m-soori/hi3535_nvr/1. Schematic/BOM.txt

1	1	BT1	BAT_3V	BAT_CR1220					
2	4	C1	20PF	SC0603					
		C2	20PF	SC0603					
		C23	20PF	SC0603					
		C24	20PF	SC0603					
3	2	C3	10nF	C0402					
		C25	10nF	C0402					
4	2	C4	NC/10nF	C0402					
		C26	NC/10nF	C0402					
5	7	C5	4.7UF	SC0603					
		C10	4.7UF	SC0603					
		C12	4.7UF	SC0603					
		C27	4.7UF	SC0603					
		C32	4.7UF	SC0603					
		C34	4.7UF	SC0603					
		C329	4.7uF	SC0603					
6	124	C6	100NF	SC0402					
		C8	100NF	SC0402					
		C9	100NF	SC0402					
		C11	100NF	SC0402					
		C13	100NF	SC0402					
		C14	100NF	SC0402					
		C28	100NF	SC0402					
		C30	100NF	SC0402					
		C31	100NF	SC0402					
		C33	100NF	SC0402					
		C35	100NF	SC0402					
		C36	100NF	SC0402					
		C45	100NF	SC0402					
		C47	100NF	SC0402					
		C50	100NF	SC0402					
		C51	100NF	SC0402					
		C52	100NF	SC0402					
		C53	100NF	SC0402					
		C54	100NF	SC0402					
		C55	100NF	SC0402					
		C56	100NF	SC0402					
		C57	100NF	SC0402					
		C60	100NF	SC0402					
		C61	100NF	SC0402					
		C62	100NF	SC0402					
		C63	100NF	SC0402					
		C64	100NF	SC0402					
		C65	100NF	SC0402					
		C66	100NF	SC0402					
		C88	100NF	SC0402					
		C89	100NF	SC0402					
		C90	100NF	SC0402					
		C91	100NF	SC0402					
		C92	100NF	SC0402					
		C93	100NF	SC0402					
		C97	100NF	SC0402					
		C98	100NF	SC0402					
		C99	100NF	SC0402					
		C100	100NF	SC0402					
		C101	100NF	SC0402					
		C102	100NF	SC0402					
		C103	100NF	SC0402					
		C104	100NF	SC0402					
		C105	100NF	SC0402					
		C106	100NF	SC0402					
		C107	100NF	SC0402					
		C108	100NF	SC0402					
		C109	100NF	SC0402					
		C110	100NF	SC0402					
		C111	100NF	SC0402					
		C112	100NF	SC0402					
		C113	100NF	SC0402					
		C123	100NF	SC0402					
		C124	100NF	SC0402					
		C125	100NF	SC0402					
		C126	100NF	SC0402					
		C127	100NF	SC0402					
		C128	100NF	SC0402					
		C130	100NF	SC0402					
		C131	100NF	SC0402					
		C132	100NF	SC0402					
		C133	100NF	SC0402					
		C134	100NF	SC0402					
		C135	100NF	SC0402					
		C136	100NF	SC0402					
		C137	100NF	SC0402					
		C138	100NF	SC0402					
		C141	100NF	SC0402					
		C142	100NF	SC0402					
		C143	100NF	SC0402					
		C144	100NF	SC0402					
		C145	100NF	SC0402					
		C146	100NF	SC0402					
		C147	100NF	SC0402					
		C148	100NF	SC0402					
		C149	100NF	SC0402					
		C151	100NF	SC0402					
		C152	100NF	SC0402					
		C153	100NF	SC0402					
		C154	100NF	SC0402					
		C156	100NF	SC0402					
		C157	100NF	SC0402					
		C158	100NF	SC0402					
		C159	100NF	SC0402					
		C160	100NF	SC0402					
		C161	100NF	SC0402					
		C162	100NF	SC0402					
		C163	100NF	SC0402					
		C164	100NF	SC0402					
		C167	100NF	SC0402					
		C168	100NF	SC0402					
		C169	100NF	SC0402					
		C170	100NF	SC0402					
		C171	100NF	SC0402					
		C172	100NF	SC0402					
		C173	100NF	SC0402					
		C174	100NF	SC0402					
		C175	100NF	SC0402					
		C186	100NF	SC0402					
		C187	100NF	SC0402					
		C199	100NF	SC0402					
		C200	100NF	SC0402					
		C202	100NF	SC0402					
		C203	100NF	SC0402					
		C204	100NF	SC0402					
		C206	100NF	SC0402					
		C207	100NF	SC0402					
		C210	100NF	SC0402					
		C211	100NF	SC0402					
		C213	100NF	SC0402					
		C214	100NF	SC0402					
		C216	100NF	SC0402					
		C217	100NF	SC0402					
		C219	100NF	SC0402					
		C220	100NF	SC0402					
		C231	100NF	SC0402					
		C241	100NF	SC0402					
		C245	100NF	SC0402					
		C246	100NF	SC0402					
		C249	100NF	SC0402					
		C250	100NF	SC0402					
		C252	100NF	SC0402					
		C323	100NF	SC0402					
		C325	100NF	SC0402					
7	10	C7	1NF	SC0402					
		C29	1NF	SC0402					
		C140	1NF	SC0402					
		C166	1NF	SC0402					
		C264	1NF	SC0402					
		C281	1NF	SC0402					
		C288	1NF	SC0402					
		C302	1NF	SC0402					
		C319	1NF	SC0402					
		C326	1NF	SC0402					
8	41	C15	100NF	SC0603					
		C16	100NF	SC0603					
		C17	100NF	SC0603					
		C18	100NF	SC0603					
		C20	100NF	SC0603					
		C21	100NF	SC0603					
		C37	100NF	SC0603					
		C38	100NF	SC0603					
		C39	100NF	SC0603					
		C40	100NF	SC0603					
		C42	100NF	SC0603					
		C43	100NF	SC0603					
		C183	100NF	SC0603					
		C189	100NF	SC0603					
		C190	100NF	SC0603					
		C191	100NF	SC0603					
		C192	100NF	SC0603					
		C225	100NF	SC0603					
		C227	100NF	SC0603					
		C229	100NF	SC0603					
		C242	100NF	SC0603					
		C254	100NF	SC0603					
		C257	100NF	SC0603					
		C260	100NF	SC0603					
		C263	100NF	SC0603					
		C266	100NF	SC0603					
		C267	100NF	SC0603					
		C271	100NF	SC0603					
		C274	100NF	SC0603					
		C277	100NF	SC0603					
		C280	100NF	SC0603					
		C284	100NF	SC0603					
		C289	100NF	SC0603					
		C292	100NF	SC0603					
		C295	100NF	SC0603					
		C298	100NF	SC0603					
		C301	100NF	SC0603					
		C305	100NF	SC0603					
		C309	100NF	SC0603					
		C315	100NF	SC0603					
		C318	100NF	SC0603					
9	14	C19	10UF	SC0805					
		C22	10UF	SC0805					
		C41	10UF	SC0805					
		C44	10UF	SC0805					
		C139	10UF	SC0805					
		C150	10UF	SC0805					
		C165	10UF	SC0805					
		C176	10UF	SC0805					
		C188	10UF	SC0805					
		C256	10UF	SC0805					
		C273	10UF	SC0805					
		C290	10UF	SC0805					
		C294	10UF	SC0805					
		C310	10UF	SC0805					
10	24	C46	1UF	SC0402					
		C48	1UF	SC0402					
		C67	1UF	SC0402					
		C68	1UF	SC0402					
		C69	1UF	SC0402					
		C80	1UF	SC0402					
		C81	1UF	SC0402					
		C82	1UF	SC0402					
		C86	1UF	SC0402					
		C87	1UF	SC0402					
		C117	1UF	SC0402					
		C118	1UF	SC0402					
		C122	1UF	SC0402					
		C129	1UF	SC0402					
		C155	1UF	SC0402					
		C198	1UF	SC0402					
		C205	1UF	SC0402					
		C208	1UF	SC0402					
		C209	1UF	SC0402					
		C212	1UF	SC0402					
		C215	1UF	SC0402					
		C268	1UF	SC0402					
		C285	1UF	SC0402					
		C307	1UF	SC0402					
11	9	C49	10UF	SC0603					
		C58	10UF	SC0603					
		C59	10UF	SC0603					
		C119	10UF	SC0603					
		C120	10UF	SC0603					
		C121	10UF	SC0603					
		C201	10UF	SC0603					
		C248	10UF	SC0603					
		C251	10UF	SC0603					
12	2	C70	22UF	SC1206					
		C78	22UF	SC1206					
13	5	C71	2.2UF	HSC0402					
		C72	2.2UF	HSC0402					
		C197	2.2UF	HSC0402					
		C218	2.2UF	HSC0402					
		C247	2.2UF	HSC0402					
14	3	C73	470NF	SC0402					
		C74	470NF	SC0402					
		C283	470nF	SC0402					
15	6	C75	220NF	SC0402					
		C76	220NF	SC0402					
		C77	220NF	SC0402					
		C83	220NF	SC0402					
		C84	220NF	SC0402					
		C85	220NF	SC0402					
16	6	C79	2.2UF	SC0603					
		C114	2.2UF	SC0603					
		C115	2.2UF	SC0603					
		C116	2.2UF	SC0603					
		C270	2.2UF	SC0603					
		C287	2.2UF	SC0603					
17	1	C94	4.7UF	SC1206					
18	6	C95	220UF	STC3528					
		C96	220UF	STC3528					
		C261	220UF	STC3528					
		C265	220UF	STC3528					
		C278	220UF	STC3528					
		C282	220UF	STC3528					
19	1	C177	1NF	SC0603					
20	2	C178	27PF	SC0603					
		C179	27PF	SC0603					
21	2	C180	22PF	SC0402					
		C181	22PF	SC0402					
22	4	C182	8pF	C0402					
		C185	8pF	C0402					
		C232	8pF	C0402					
		C233	8pF	C0402					
23	4	C184	1uF	C0402					
		C239	1uF	C0402					
		C244	1uF	C0402					
		C347	1uF	C0402					
24	4	C221	10NF	SC0402					
		C222	10NF	SC0402					
		C223	10NF	SC0402					
		C224	10NF	SC0402					
25	4	C226	100UF	STC7343					
		C230	100UF	STC7343					
		C321	100UF	STC7343					
		C322	100UF	STC7343					
26	2	C228	10NF	SC0603					
		C243	10NF	SC0603					
27	3	C234	4.7uF	C0603					
		C240	4.7uF	C0603					
		C355	4.7uF	C0603					
28	11	C235	0.1uF	C0402					
		C236	0.1uF	C0402					
		C237	0.1uF	C0402					
		C238	0.1uF	C0402					
		C253	0.1uF	C0402					
		C339	0.1uF	c0402					
		C340	0.1uF	c0402					
		C342	0.1uF	C0402					
		C345	0.1uF	c0402					
		C346	0.1uF	C0402					
		C354	0.1uF	C0402					
29	4	C255	47UF	STC7343					
		C272	47UF	STC7343					
		C293	47UF	STC7343					
		C308	47UF	STC7343					
30	15	C258	22UF	SC0805					
		C259	22UF	SC0805					
		C262	22UF	SC0805					
		C275	22UF	SC0805					
		C276	22UF	SC0805					
		C279	22UF	SC0805					
		C296	22UF	SC0805					
		C297	22UF	SC0805					
		C300	22UF	SC0805					
		C313	22UF	SC0805					
		C314	22UF	SC0805					
		C317	22UF	SC0805					
		C324	22UF	SC0805					
		C327	22UF	SC0805					
		C328	22UF	SC0805					
31	3	C269	NC	SC0402					
		C286	NC	SC0402					
		C306	NC	SC0402					
32	1	C291	220UF	CAPC2-138-335					
33	4	C299	100UF	STC3528					
		C303	100UF	STC3528					
		C316	100UF	STC3528					
		C320	100UF	STC3528					
34	1	C304	1UF/NC	SC0603					
35	1	C311	0.033UF	C0603					
36	1	C312	0.033UF	SC0603					
37	2	C330	220PF	SC0603					
		C331	220PF	SC0603					
38	2	C332	0.1UF	SC0603					
		C333	0.1UF	SC0603					
39	5	C334	1U	C0402					
		C335	1U	C0402					
		C336	1U	C0402					
		C337	1U	C0402					
		C338	1U	C0402					
40	1	C341	22uF	c0805					
41	2	C343	"matching circuit, will be determined"	C0402					
		C344	"matching circuit, will be determined"	C0402					
42	2	C348	10uF/6.3V	SMC0603					
		C349	10uF/6.3V	SMC0603					
43	5	C350	0.1uF	SMC0402					
		C351	0.1uF	SMC0402					
		C352	0.1uF	SMC0402					
		C353	0.1uF	SMC0402					
		C356	0.1uF	SMC0402					
44	3	C357	33pF	SMC0402					
		C358	33pF	SMC0402					
		C359	33pF	SMC0402					
45	4	D1	LED	SD0805-LED					
		D2	LED	SD0805-LED					
		D4	LED	SD0805-LED					
		D8	LED	SD0805-LED					
46	1	D3	1N4148	SOD523					
47	1	D5	1N5819	SOD123					
48	1	D6	NC/1N5819	SOD123					
49	1	D7	DZ	SD2723					
50	2	D9	MBRS330T3	SMC-2L					
		D10	MBRS330T3	SMC-2L					
51	8	ED1	NC/ESDA6V8UL/AZC199-02S	SOT23					
		ED2	NC/ESDA6V8UL/AZC199-02S	SOT23					
		ED3	NC/ESDA6V8UL/AZC199-02S	SOT23					
		ED4	NC/ESDA6V8UL/AZC199-02S	SOT23					
		ED5	NC/ESDA6V8UL/AZC199-02S	SOT23					
		ED6	NC/ESDA6V8UL/AZC199-02S	SOT23					
		ED7	NC/ESDA6V8UL/AZC199-02S	SOT23					
		ED8	NC/ESDA6V8UL/AZC199-02S	SOT23					
52	4	ED9	NC/ESD9B5VL	E0402N					
		ED10	NC/ESD9B5VL	E0402N					
		ED11	NC/ESD9B5VL	E0402N					
		ED12	NC/ESD9B5VL	E0402N					
53	2	ESD1	ES0402V014BT	ESD0402					
		ESD2	ES0402V014BT	ESD0402					
54	2	FB1	BLM18PG181SN1	L0603					
		FB2	BLM18PG181SN1	L0603					
55	3	FB3	31/3A-L3	SMR0603					
		FB4	31/3A-L3	SMR0603					
		FB5	31/3A-L3	SMR0603					
56	1	F1	FUSE2	SF6127					
57	6	ID1	ID-BOARD	ID-BOARD					
		ID2	ID-BOARD	ID-BOARD					
		ID3	ID-BOARD	ID-BOARD					
		ID4	ID-BOARD	ID-BOARD					
		ID5	ID-BOARD	ID-BOARD					
		ID6	ID-BOARD	ID-BOARD					
58	2	J1	LPJG4813HENL	SI-51009-F					
		J2	LPJG4813HENL	SI-51009-F					
59	1	J3	SIP3	SIP-3P					
60	1	J4	SIP7M2	SATA7-M					
61	1	J5	USB-4M2	USB4-1507					
62	1	J6	USB-9S4	RUSB9-180-0726A					
63	1	J7	10029449-111RLF	HDMI_A					
64	4	J8	SIP1	SIP-1P					
		J9	SIP1	SIP-1P					
		J10	SIP1	SIP-1P					
		J11	SIP1	SIP-1P					
65	1	J12	PWC3_A	PWC0103-M-C					
66	1	J13	DEBUG	conn3_box					
67	1	J14	6.91322E+11	PHEONIX_CONN_3					
68	1	J15	HEADER 4 2.54mm /NC	header-4					
69	1	J16	CON3	antenna_wifi					
70	8	LB1	LB	SL0805					
		LB2	LB	SL0805					
		LB3	LB	SL0805					
		LB4	LB	SL0805					
		LB19	LB	SL0805					
		LB21	LB	SL0805					
		LB23	LB	SL0805					
		LB25	LB	SL0805					
71	13	LB5	LB	SL0402					
		LB6	LB	SL0402					
		LB7	LB	SL0402					
		LB8	LB	SL0402					
		LB9	LB	SL0402					
		LB10	LB	SL0402					
		LB11	LB	SL0402					
		LB12	LB	SL0402					
		LB13	LB	SL0402					
		LB14	LB	SL0402					
		LB15	LB	SL0402					
		LB17	LB	SL0402					
		LB18	LB	SL0402					
72	1	LB16	LB	SL0603					
73	4	LB20	LB	SL1206					
		LB22	LB	SL1206					
		LB24	LB	SL1206					
		LB27	LB	SL1206					
74	1	LB26	LB	SL1806					
75	1	LED1	LED0603-G	SM0603LED_AC					
76	2	L1	2.2UH	HSL1008					
		L2	2.2UH	HSL1008					
77	3	L3	12UH	SPL1212C					
		L4	12UH	SPL1212C					
		L5	12UH	SPL1212C					
78	2	L6	15UH	L_					
		L7	15UH	L_					
79	1	L8	"matching circuit,will be determined"	R0402					
80	1	MPCIE_A_1	MINI PCIE-52-H6.7	pciexp_mini52pn_half					
81	1	Q1	DS1820	TO-TR					
82	2	Q2	WNM2021/2SK3018	SOT23					
		Q3	WNM2021/2SK3018	SOT23					
83	1	Q4	NC/WNM2021/2SK3018	SOT23					
84	10	RN1	33	SRN8-0804					
		RN2	33	SRN8-0804					
		RN3	33	SRN8-0804					
		RN4	33	SRN8-0804					
		RN5	33	SRN8-0804					
		RN6	33	SRN8-0804					
		RN7	33	SRN8-0804				R271	C360
		RN8	33	SRN8-0804				R272	C361
		RN9	33	SRN8-0804				R273	C362
		RN10	33	SRN8-0804				R274	C363
85	2	R1	1MEG	SR0603				R275	C364
		R51	1MEG	SR0603				R276	C365
86	24	R2	0	SR0402				R277	C366
		R3	0	SR0402				R278	C367
		R4	0	SR0402				R279	
		R26	0	SR0402				R280	
		R28	0	SR0402					
		R30	0	SR0402					
		R32	0	SR0402					
		R33	0	SR0402					
		R38	0	SR0402					
		R53	0	SR0402					
		R54	0	SR0402					
		R55	0	SR0402					
		R77	0	SR0402					
		R79	0	SR0402					
		R80	0	SR0402					
		R83	0	SR0402					
		R84	0	SR0402					
		R85	0	SR0402					
		R186	0	SR0402					
		R223	0	SR0402					
		R226	0	SR0402					
		R231	0	SR0402					
		R234	0	SR0402					
		R241	0	SR0402					
87	6	R5	0/NC	SR0402					
		R15	0/NC	SR0402					
		R31	0/NC	SR0402					
		R56	0/NC	SR0402					
		R66	0/NC	SR0402					
		R82	0/NC	SR0402					
88	4	R6	510R	R0402					
		R29	510R	R0402					
		R57	510R	R0402					
		R81	510R	R0402					
89	19	R7	0R	R0402					
		R8	0R	R0402					
		R9	0R	R0402					
		R10	0R	R0402					
		R11	0R	R0402					
		R12	0R	R0402					
		R13	0R	R0402					
		R14	0R	R0402					
		R58	0R	R0402					
		R59	0R	R0402					
		R60	0R	R0402					
		R61	0R	R0402					
		R62	0R	R0402					
		R63	0R	R0402					
		R64	0R	R0402					
		R65	0R	R0402					
		R262	0R	R0402					
		R263	0R	R0402					
		R265	0R	r0402					
90	18	R16	1K	SR0402					
		R67	1K	SR0402					
		R103	1K	SR0402					
		R104	1K	SR0402					
		R105	1K	SR0402					
		R106	1K	SR0402					
		R117	1K	SR0402					
		R118	1K	SR0402					
		R119	1K	SR0402					
		R120	1K	SR0402					
		R154	1K	SR0402					
		R155	1K	SR0402					
		R161	1K	SR0402					
		R162	1K	SR0402					
		R163	1K	SR0402					
		R164	1K	SR0402					
		R166	1K	SR0402					
		R196	1K	SR0402					
91	2	R17	2.49K	SR0603					
		R68	2.49K	SR0603					
92	2	R18	NC/10	R0402					
		R69	NC/10	R0402					
93	24	R19	33	SR0402					
		R20	33	SR0402					
		R22	33	SR0402					
		R24	33	SR0402					
		R25	33	SR0402					
		R27	33	SR0402					
		R70	33	SR0402					
		R71	33	SR0402					
		R73	33	SR0402					
		R75	33	SR0402					
		R76	33	SR0402					
		R78	33	SR0402					
		R111	33	SR0402					
		R112	33	SR0402					
		R113	33	SR0402					
		R114	33	SR0402					
		R115	33	SR0402					
		R116	33	SR0402					
		R125	33	SR0402					
		R126	33	SR0402					
		R127	33	SR0402					
		R128	33	SR0402					
		R129	33	SR0402					
		R130	33	SR0402					
94	34	R21	4.7K	SR0603					
		R23	4.7K	SR0603					
		R34	4.7K	SR0603					
		R35	4.7K	SR0603					
		R36	4.7K	SR0603					
		R37	4.7K	SR0603					
		R40	4.7K	SR0603					
		R42	4.7K	SR0603					
		R43	4.7K	SR0603					
		R45	4.7K	SR0603					
		R46	4.7K	SR0603					
		R48	4.7K	SR0603					
		R49	4.7K	SR0603					
		R72	4.7K	SR0603					
		R74	4.7K	SR0603					
		R87	4.7K	SR0603					
		R88	4.7K	SR0603					
		R89	4.7K	SR0603					
		R90	4.7K	SR0603					
		R91	4.7K	SR0603					
		R92	4.7K	SR0603					
		R94	4.7K	SR0603					
		R96	4.7K	SR0603					
		R98	4.7K	SR0603					
		R100	4.7K	SR0603					
		R137	4.7K	SR0603					
		R138	4.7K	SR0603					
		R139	4.7K	SR0603					
		R140	4.7K	SR0603					
		R141	4.7K	SR0603					
		R145	4.7K	SR0603					
		R146	4.7K	SR0603					
		R150	4.7K	SR0603					
		R153	4.7K	SR0603					
95	3	R39	470	SR0603					
		R86	470	SR0603					
		R249	470	SR0603					
96	10	R41	4.7K/NC	SR0603					
		R44	4.7K/NC	SR0603					
		R47	4.7K/NC	SR0603					
		R93	4.7K/NC	SR0603					
		R95	4.7K/NC	SR0603					
		R97	4.7K/NC	SR0603					
		R147	4.7K/NC	SR0603					
		R148	4.7K/NC	SR0603					
		R149	4.7K/NC	SR0603					
		R156	4.7K/NC	SR0603					
97	2	R50	4.7K/CN	SR0603					
		R99	4.7K/CN	SR0603					
98	2	R52	4.7K	SR0402					
		R142	4.7K	SR0402					
99	6	R101	10K	SR0402					
		R109	10K	SR0402					
		R123	10K	SR0402					
		R133	10K	SR0402					
		R136	10K	SR0402					
		R213	10K	SR0402					
100	3	R102	240	SR0402					
		R110	240	SR0402					
		R124	240	SR0402					
101	4	R107	120	SR0402					
		R108	120	SR0402					
		R121	120	SR0402					
		R122	120	SR0402					
102	1	R131	1MEG	SR0402					
103	1	R132	10	SR0402					
104	5	R135	10K	R0402					
		R202	10K	R0402					
		R204	10K	R0402					
		R205	10K	R0402					
		R264	10K	r0402					
105	3	R143	0/NC	SR0603					
		R144	0/NC	SR0603					
		R216	0/NC	SR0603					
106	11	R151	10K	SR0603					
		R152	10K	SR0603					
		R157	10K	SR0603					
		R158	10K	SR0603					
		R159	10K	SR0603					
		R160	10K	SR0603					
		R165	10K	SR0603					
		R193	10K	SR0603					
		R195	10K	SR0603					
		R198	10K	SR0603					
		R200	10K	SR0603					
107	1	R169	470K	SR0402					
108	15	R170	22	SR0402					
		R172	22	SR0402					
		R174	22	SR0402					
		R176	22	SR0402					
		R177	22	SR0402					
		R178	22	SR0402					
		R180	22	SR0402					
		R181	22	SR0402					
		R182	22	SR0402					
		R183	22	SR0402					
		R184	22	SR0402					
		R185	22	SR0402					
		R187	22	SR0402					
		R188	22	SR0402					
		R190	22	SR0402					
109	2	R171	270	SR0603					
		R173	270	SR0603					
110	2	R175	200	SR0603					
		R179	200	SR0603					
111	6	R189	1K	SR0603					
		R191	1K	SR0603					
		R229	1K	SR0603					
		R237	1K	SR0603					
		R245	1K	SR0603					
		R251	1K	SR0603					
112	4	R192	100K	SR0603					
		R194	100K	SR0603					
		R197	100K	SR0603					
		R199	100K	SR0603					
113	1	R201	680R	R0402					
114	1	R203	100K	R0402					
115	1	R212	1.13K	SR0603					
116	1	R214	20K	SR0402					
117	1	R215	47K	SR0402					
118	4	R217	1.62K%1	R0402					
		R218	1.62K%1	R0402					
		R219	1.62K%1	R0402					
		R220	1.62K%1	R0402					
119	2	R221	NC/10K	R0402					
		R222	NC/10K	R0402					
120	3	R224	100K	SR0402					
		R232	100K	SR0402					
		R242	100K	SR0402					
121	1	R225	12.1K	SR0402					
122	1	R227	1.5K	SR0402					
123	1	R228	127K	SR0402					
124	2	R230	24.9K	SR0402					
		R244	24.9K	SR0402					
125	1	R233	27K	SR0402					
126	1	R235	12K	SR0402					
127	1	R236	200K	SR0402					
128	1	R238	45.3K	SR0402					
129	1	R239	1K	SR1206					
130	2	R240	10K/NC	SR0603					
		R253	10K/NC	SR0603					
131	1	R243	24K	SR0402					
132	2	R246	100	SR0603					
		R252	100	SR0603					
133	3	R247	51	SR0603					
		R248	51	SR0603					
		R250	51	SR0603					
134	1	R254	49.9	SC0603					
135	2	R255	10k	SC0603					
		R256	10k	SC0603					
136	1	R257	49	SC0603					
137	1	R258	1.91k	SC0603					
138	1	R259	3.16k	SC0603					
139	2	R260	499	SC0603					
		R261	499	SC0603					
140	1	R266	0R/NC	R0402					
141	2	R267	0R/NM	SMR0402					
		R269	0R/NM	SMR0402					
142	1	R268	0R	SMR0402					
143	1	R270	240R	SMR0402					
144	1	SIM1	CR-201-6P	micro_sim					
145	2	SW1	DSW4	SDSW8-L					
		SW2	DSW4	SDSW8-L					
146	1	S1	PSW3_B	PSW3-RA					
147	2	TS1	TEST	GND12					
		TS2	TEST	GND12					
148	1	T1	DLW21SN900SQ2L	choke_coil					
149	2	U1	RTL8211EG_1	QFN64-050-0909LH					
		U2	RTL8211EG_1	QFN64-050-0909LH					
150	1	U4	HI3535	PBGA563-32-2828					
151	2	U5	DDR3 DRAM-4GBIT-800MHZ-16BIT	BGA96-32-1609G					
		U6	DDR3 DRAM-4GBIT-800MHZ-16BIT	BGA96-32-1609G					
152	1	U7	MCP7940M-I/SN	soic-8					
153	1	U8	H27U2G8F2CTR_BC	SOP48-20-720A					
154	2	U9	MIC2505	SOP8-50-150					
		U10	MIC2505	SOP8-50-150					
155	1	U11	GL850G	SSOP28					
156	2	U12	NC/RClamp0524PA/ESD5304/TPD4E02B04DQAR	SLP2510P8					
		U13	NC/RClamp0524PA/ESD5304/TPD4E02B04DQAR	SLP2510P8					
157	3	U14	TSP54328EDDA	HSOP8					
		U15	TSP54328EDDA	HSOP8					
		U16	TSP54328EDDA	HSOP8					
158	2	U17	FMB3904 dual NPN	SSOT-6L					
		U18	FMB3904 dual NPN	SSOT-6L					
159	1	U19	TPS54383PWP	HTSSOP14					
160	1	U20	MAX3232	soic16					
161	1	U21	ZM5304	ZM5304					
162	1	U22	RL-UM12BS-8188EUS	WIFI_BT_R					
163	1	U23	PT5108E23E-33/RT9013-33B	SOT23-5					
164	2	X1	25MHZ	SX2-1205					
		X2	25MHZ	SX2-1205					
165	1	X3	24MHZ	SX2-1205					
166	1	X4	0.032768MHZ	XTAL2-100					
167	1	X5	12M/20pF	5032-12m					
168	1	Y1	32.768K	cm315d
