m-soori/hi3535_nvr/6. Doc/PadDesign.txt

Begin layer = End layer = internal layer + 10
Thermal reliefs = Antipads = Regular pads + 10
Soldermask Top = Regular Pad Top + 10
