m-soori/hi3535_nvr/2. Layout/Design Recommendations.xlsx

Sheet: Board
2. PCB Design Recommendation
2.1. Fanout Design Recommendations
* Pay attention to the fanout mode of the pins in the five outmost circles and via positions, ensuring the maximum current capacity of the power layer, smooth reflow paths of the GND layer, and the integrity of the GND layer and power layer
* It is recommended that power be supplied to the 3.3 V, 1.5 V, and DVDD_CORE power pins by using complete power planes and the power be supplied to the DVDD_CPU pin over a copper plane. In addition, ensure that the copper planes for the DVDD_CORE and DVDD_CPU pins are wide to support the maximum current capacities of 3 A and 2 A respectively.
2.2. Design Recommendations for Power Supplies and Filtering Capacitors
2.2.1. Core Power Supply
* Same as demo board. The recommended material for the filtering capacitors is X7R.
* Routing mode and filtering capacitor layout for core power supply must be same as demo board
2.2.2. CPU Power Supply Design
2.3. Design Requirements on DDR2 or DDR3 SDRAM Interface Routing
The design of the DDR SDRAM interface on the Hi3535 must be the same as that on the Hi3535 demo board. The items to be designed include the trace width, trace spacing, the spacing between a trace and GND, trace length, surrounding with GND traces, filtering capacitor position, and matching mode.
2.4. GMAC Routing Recommendations
Avoid routing signal traces across power plane splits to retain complete reference planes for signal traces.
Determine the signal trace length based on the clock trace length, and ensure that the length deviation is ±200 mils.
Ensure that the GND under the transformer is void.
Each pair of differential traces (MDI+_0, MDI−_0, MDI+_1, MDI−_1, MDI+_2, MDI−_2, MDI+_3, and MDI−_3) has the same length. The length deviation is ±5 mils, and the impedance of each differential trace is 100 Ω±10%.
2.5 USB 2.0 Circuit Design Recommendations
The differential data traces must be short and straight, and the internal differential traces must have the same length. t is recommended that the trace deviation be ±5 mils.
The differential impedance of the differential data trace must be 90 Ω±10%.
Route differential data traces on the plane that is close to the GND plane and never change the routing plane.
Route differential data traces by referencing a complete GND plane, and do not cross the plane splits.
Minimize the use of vias and corners when routing differential data traces. When corners are required, use arcs or135° turns rather than a 90° turn, reducing signal reflection and impedance variance.
Keep the differential data traces away from other high-speed cyclic signal traces and large current signal traces. The spacing must be greater than 50 mils. In this way, the crosstalk effect is reduced. Keep the differential data traces at least 20 mils away from low-speed non-cyclic signals.
Place the REXT resistor close to the Hi3535.
2.6 USB 3.0 Circuit Design Recommendations
Place the blocking capacitor close to the connector.
Route traces at the top layer, and punch at most one vias.
Ensure that the length of each differential trace is shorter than 3 inches.
2.7 Design Recommendations on SATA Port Routing
The differential impedance must be 100 Ω±10%.
The 10 nF surface mounting technology (SMT) capacitor connected to the differential signal line in series must be placed close to the SATA connector.
It is recommended that the length deviation for each pair of differential signal traces be ±5 mils.
Route traces at the top layers and never punch vias and change the routing layer.
It is recommended that the signal trace length on the PCB be shorter than 5 inches
2.8 Design Recommendations on HDMI Routing
The differential impedance of the four pairs of HDMI differential signal traces must be 100 Ω±10%.
ESD components must be placed close to the HDMI connector.
It is recommended that the signal trance at the corners be routed as arcs.
The length deviation for each pair of internal differential signal traces must be ±5 mils, and the length deviation for all differential signal traces must be ±50 mils.
The length of each HDMI differential signal trace is shorter than 5 inches.
2.10 PCB Design Recommendations on the PCIe Bus
The differential data traces must be short and straight, and the internal differential traces must have the same length. It is recommended that the trace deviation be ±20 mils.
Ensure that the spacing between adjacent differential data traces is constant. Route traces on the routing planes close to GND, and do not change a routing plane.

Sheet: Allegro
Creating Differential Pairs
* Constraint Manager
_ Electrical -> Net -> Routing -> Differential Pair
 | A list of nets appear, pick a pair of traces, R-click -> Create -> Differential Pair
 | Diff Pair Name
 | The 2 traces will move to the diff pair group
_ Object -> Create -> Differential Pair…
 | Auto Setup…
 | + Filter, - Filter, Prefix
Creating a Cset
* Constraint Manager
_ Spacing
_ Object -> Create -> Spacing C-set: Create new C-Set
_ Net -> Line ->
Setting Impedance
- Cross Section
- Thickness
- Trace width
Tool
Phase tune
Delay tune
Change to another editor
File -> Change editor -> Check High Speed
Total Etch Length
- Optional: we can highlight the rat nets
- Constraint Manger -> Electrical -> Net -> Total Etch Length
 | Pick the traces -> create -> net class
- Route
- Come back with CM -> Analyze -> Analyze Modes…
- Electrical Modes -> Turn on Total etch length
- It will give you the length of the traces
- CM -> Electrical -> Electrical Constraint Set -> Routing -> Total Etch length
- R-click on the table -> Create -> Electrical Cset -> Create a Cset
- Set maximum total etch
- Change the group into Cset group
- Delay tune
Electrical Constraint Set Topologies Allegro PCB High Speed Option

Sheet: TPS
The layout guidelines presented here are illustrated in the PCB layout examples given in Figure 51 and Figure 52.
• The PowerPAD must be connected to a low current (signal) ground plane having a large copper surface areato dissipate heat. Extend the copper surface well beyond the IC package area to maximize thermal transfer of heat away from the IC.
• Connect the GND pin to the PowerPAD through a 10-mil (.010 in, or 0.0254 mm) wide trace.
• Place the ceramic input capacitors close to PVDD1 and PVDD2; connect using short, wide traces.
• Maintain a tight loop of wide traces from SW1 or SW2 through the switch node, inductor, output capacitor and rectifier diode. Avoid using vias in this loop.
• Use a wide ground connection from the input capacitor to the rectifier diode, placed as close to the power path as possible. Placement directly under the diode and the switch node is recommended.
• Locate the bootstrap capacitor close to the BOOT pin to minimize the gate drive loop.
• Locate voltage setting resistors and any feedback components over the ground plane and away from the switch node and the rectifier diode to input capacitor ground connection.
• Locate snubber components (if used) close to the rectifier diode with minimal loop area.
• Locate the BP bypass capacitor very close to the IC; a minimal loop area is recommended.
• Locate the output ceramic capacitor close to the inductor output terminal between the inductor and any electrolytic capacitors, if used.

Sheet: Stackup
 | Layer Stackup | Thickness
 | Silk top | Default
 | Solder top
ART01 |  | 1.8
PREPREG |  | 3.9
GND02 |  | 1.2
CORE |  | xxx
POW03 |  | 1.2
PREPREG |  | 3.9
ART04 |  | 1.8
 | Solder bot | Default
 | Silk bot
Single Impedance | Layer | Trace Width (mil) | Tolerance | Freq (MHz) | Remark
50 ohm | 1, 4 | 6 | 10% | Default
Diff Impedance | Layer | Trace W/S (mil) | Tolerance | Freq (MHz) | Remark
100 ohm | 1, 4 | 5/8 | 10% | Default
90 ohm | 1 | 6.1/7 | 10% | Default
