m-soori/hi3535_nvr/(list of files, cad)

Other CAD files:
Footprint/1825027-5.psm
Footprint/5032-12m.psm
Footprint/abm3-24.psm
Footprint/anten_sma_fe_edge.psm
Footprint/antenna_wifi.psm
Footprint/b3u-1000p.psm
Footprint/bat_cr1220.psm
Footprint/bat_upright.psm
Footprint/bga453-19x19.psm
Footprint/bga624_0p8_21x21.psm
Footprint/bga636_1.psm
Footprint/bga96-32-1609g.psm
Footprint/bitpipe.psm
Footprint/block2.psm
Footprint/button_fsm.psm
Footprint/buzzer_dip2.psm
Footprint/bzv55c.psm
Footprint/c0402.psm
Footprint/c0603.psm
Footprint/c0805.psm
Footprint/cap-2917.psm
Footprint/cap2-300-240.psm
Footprint/cap400.psm
Footprint/cap_1210.psm
Footprint/cap_al_d.psm
Footprint/cap_alu_smd_d.psm
Footprint/cap_thru.psm
Footprint/capc2-138-335.psm
Footprint/capmp3216x166.psm
Footprint/capp_ae_f.psm
Footprint/capp_taj_a.psm
Footprint/capp_taj_c.psm
Footprint/capp_taj_d.psm
Footprint/choke_coil.psm
Footprint/clp-2x15-1_27-l-d.psm
Footprint/cm315d.psm
Footprint/con5_microusb_skt_sm.psm
Footprint/con5smd.psm
Footprint/con_2.psm
Footprint/con_40p_bot.psm
Footprint/con_dil_8.psm
Footprint/conffc0_5mm_40_top.psm
Footprint/conn2_box.psm
Footprint/conn3_box.psm
Footprint/conn50.psm
Footprint/conn5_box.psm
Footprint/conn_dil_10.psm
Footprint/conn_jack_dc.psm
Footprint/connffc6p0_5.psm
Footprint/connffc6p0_5_top.psm
Footprint/cry-d3225.psm
Footprint/cry3225.psm
Footprint/cry3225_m.psm
Footprint/crys14.psm
Footprint/d1206.psm
Footprint/db15-3rf-a.psm
Footprint/db9-2rm.psm
Footprint/dc_jack_straight.psm
Footprint/dfn2510p10e_az1045.psm
Footprint/dip_2x6.psm
Footprint/do-214ab.psm
Footprint/do214ac_sma.psm
Footprint/drill3mm.psm
Footprint/dsw4-lp.psm
Footprint/e0402n.psm
Footprint/esd0402.psm
Footprint/ese11mv13.psm
Footprint/ethernet_poe.psm
Footprint/fbga169_0p5_14x18mm.psm
Footprint/fbga96-10x14.psm
Footprint/fbga96_0p8_14x10.psm
Footprint/ffc_15pin_1mm.psm
Footprint/fid-040.psm
Footprint/finished_hole-100.psm
Footprint/finished_smt-200.psm
Footprint/gnd12.psm
Footprint/harting_12p.psm
Footprint/harting_2p.psm
Footprint/hdmi_a.psm
Footprint/header-4.psm
Footprint/header17x2.psm
Footprint/header2.psm
Footprint/header25x2.psm
Footprint/header2x2.psm
Footprint/header3.psm
Footprint/header3x2.psm
Footprint/header4-125.psm
Footprint/header4.psm
Footprint/header4x2.psm
Footprint/header5x2.psm
Footprint/header6-125.psm
Footprint/header8-125.psm
Footprint/header_3p.psm
Footprint/header_3x2.psm
Footprint/header_4p.psm
Footprint/header_4x2.psm
Footprint/header_5x2.psm
Footprint/hearder_2_pitch_1p25mm.psm
Footprint/hk23f-6-200.psm
Footprint/hole160-8star.psm
Footprint/hsc0402.psm
Footprint/hsl1008.psm
Footprint/hsod323a.psm
Footprint/hsop8.psm
Footprint/hsr0402.psm
Footprint/htssop14.psm
Footprint/id-board.psm
Footprint/idc20-dtm1-a.psm
Footprint/in4d_5x5.psm
Footprint/ind-3x3.psm
Footprint/ind-5x5.psm
Footprint/ind_3x3.psm
Footprint/ind_4_7u_2a.psm
Footprint/ind_4u7_rs9113.psm
Footprint/ind_hex.psm
Footprint/ind_tdk-vclf4020.psm
Footprint/indc2012n.psm
Footprint/l0603.psm
Footprint/l_.psm
Footprint/lan8270a.psm
Footprint/lcc28.psm
Footprint/ledrgb.psm
Footprint/lqfp48_7x7mm_0_5mmpp.psm
Footprint/lqfp48l.psm
Footprint/lqfp_32p.psm
Footprint/mark.psm
Footprint/mf-msmf.psm
Footprint/micro_sim.psm
Footprint/mj8-srlfy.psm
Footprint/mlf14b-050-0403l.psm
Footprint/mlf32-050-0505le.psm
Footprint/mlf_1_2mmx1_2mm-4pin.psm
Footprint/molex_47151-19_hdmi.psm
Footprint/molex_53048-0810.psm
Footprint/mp2365.psm
Footprint/msop10.psm
Footprint/msop8.psm
Footprint/nrfmini.psm
Footprint/oled128x32.psm
Footprint/oled128x32_1.psm
Footprint/opto_7mm.psm
Footprint/pbga563-32-2828.psm
Footprint/pciexp_mini52pn_half.psm
Footprint/pheonix_conn_3.psm
Footprint/plcc32.psm
Footprint/pmr0104-200rq.psm
Footprint/poe.psm
Footprint/powerso20.psm
Footprint/pqfp100.psm
Footprint/psw3-ra.psm
Footprint/pwc0103-m-c.psm
Footprint/qfn-72.psm
Footprint/qfn32_d5_5x5_50.psm
Footprint/qfn48-6x6.psm
Footprint/qfn48.psm
Footprint/qfn64-050-0909lh.psm
Footprint/r0402.psm
Footprint/r0402s4.psm
Footprint/r0603.psm
Footprint/r0805.psm
Footprint/r2w.psm
Footprint/rca80-8.psm
Footprint/rj45-vertical.psm
Footprint/rk616_bga144.psm
Footprint/rn2483.psm
Footprint/rs9113.psm
Footprint/rt8070zqw.psm
Footprint/rusb9-180-0726a.psm
Footprint/sata7-m.psm
Footprint/sata7_aba-sat-010-k.psm
Footprint/sata_pwr.psm
Footprint/sc0402.psm
Footprint/sc0603.psm
Footprint/sc0805.psm
Footprint/sc1206.psm
Footprint/sc1210.psm
Footprint/sc70_5.psm
Footprint/scapc2-0808c.psm
Footprint/sd0805-led.psm
Footprint/sd1714a.psm
Footprint/sd1714d.psm
Footprint/sd2723.psm
Footprint/sdsw8-l.psm
Footprint/sen3-100c.psm
Footprint/sf6127.psm
Footprint/sgm8903.psm
Footprint/si-51009-f.psm
Footprint/sip-1p.psm
Footprint/sip-3p.psm
Footprint/sk34a.psm
Footprint/sl0402.psm
Footprint/sl0603.psm
Footprint/sl0805.psm
Footprint/sl0805b.psm
Footprint/sl1206.psm
Footprint/sl1210.psm
Footprint/sl1806.psm
Footprint/sl4040.psm
Footprint/slp2510p8.psm
Footprint/sm0603led_ac.psm
Footprint/smc-2l.psm
Footprint/smc0201.psm
Footprint/smc0402.psm
Footprint/smc0603.psm
Footprint/smc0805.psm
Footprint/smdcap.psm
Footprint/smdres.psm
Footprint/smr0201.psm
Footprint/smr0402.psm
Footprint/smr0603.psm
Footprint/smr0805.psm
Footprint/smr1206.psm
Footprint/sod123.psm
Footprint/sod323f.psm
Footprint/sod523.psm
Footprint/soic-8.psm
Footprint/soic14.psm
Footprint/soic16.psm
Footprint/soic20w.psm
Footprint/soic4.psm
Footprint/soic8.psm
Footprint/sop16-26-208-255.psm
Footprint/sop16-50-173.psm
Footprint/sop16-50-300a.psm
Footprint/sop38-20-173a.psm
Footprint/sop48-20-720a.psm
Footprint/sop56-20-250-550.psm
Footprint/sop8-26-118.psm
Footprint/sop8-50-150.psm
Footprint/sop8-50-157h.psm
Footprint/sop8-50-173.psm
Footprint/sop8h-50-155a.psm
Footprint/sot223.psm
Footprint/sot23-5.psm
Footprint/sot23-5b.psm
Footprint/sot23-6.psm
Footprint/sot23-6l.psm
Footprint/sot23-6n.psm
Footprint/sot23.psm
Footprint/sot230p696x180-4n.psm
Footprint/sot23_2.psm
Footprint/sot23_6.psm
Footprint/sot25.psm
Footprint/sot523_312.psm
Footprint/spl1212c.psm
Footprint/sr0402.psm
Footprint/sr0603.psm
Footprint/sr1206.psm
Footprint/srn8-0804.psm
Footprint/ss14.psm
Footprint/ssop28.psm
Footprint/ssot-6l.psm
Footprint/ssw-push.psm
Footprint/stamp-1x5-80.psm
Footprint/stc3528.psm
Footprint/stc7343.psm
Footprint/stfm24-39-630.psm
Footprint/sw_dip_2p_smd.psm
Footprint/sw_smd_3x6x2mm5.psm
Footprint/sx2-1205.psm
Footprint/sx4-0705.psm
Footprint/t-0_7.psm
Footprint/t-1_0.psm
Footprint/test_hole.psm
Footprint/to-269aa.psm
Footprint/to-tr.psm
Footprint/to92ecb.psm
Footprint/tp24-smd.psm
Footprint/tqfp64.psm
Footprint/trc41604nl.psm
Footprint/tsop48.psm
Footprint/tssop-8.psm
Footprint/tssop20.psm
Footprint/usb-mini.psm
Footprint/usb4-1507.psm
Footprint/usb_a.psm
Footprint/usb_cam.psm
Footprint/usb_x2.psm
Footprint/usbonboard.psm
Footprint/usd_socket.psm
Footprint/usop_10p.psm
Footprint/vaf2.psm
Footprint/vaf3-a.psm
Footprint/vaf6-1406d.psm
Footprint/vmn2.psm
Footprint/wbc0104-49t.psm
Footprint/wbc0109-20ra.psm
Footprint/wcm_2012hdmi_900t.psm
Footprint/wifi_bt_r.psm
Footprint/wlcsp-20.psm
Footprint/xson10u.psm
Footprint/xtal1170x500x450.psm
Footprint/xtal2-100.psm
Footprint/zip20.psm
Footprint/zm5202_a.psm
Footprint/zm5304.psm
