m-soori/hi3535_nvr/1. Schematic/draft.pdf

# Connector

## VOU1120_DATA7/BOOT_SEL0

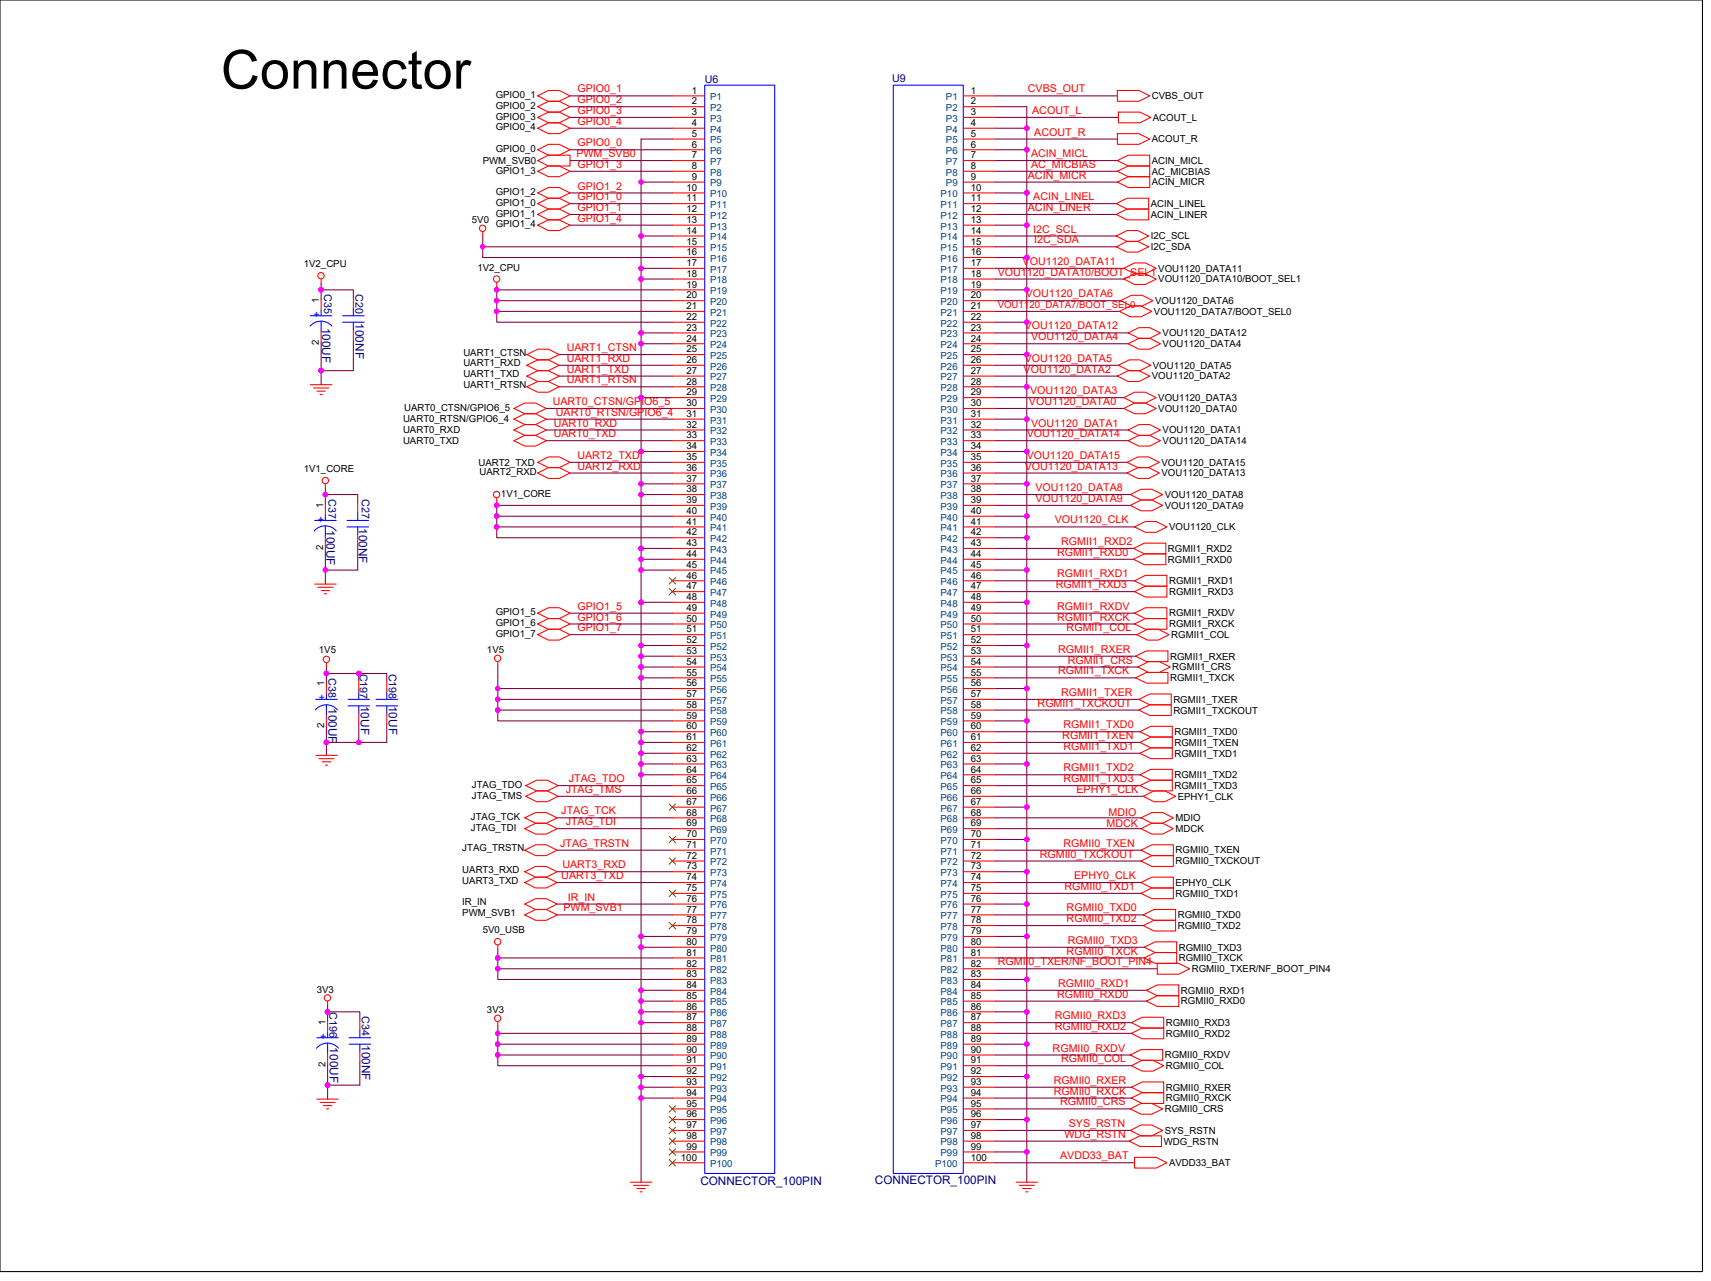
[picture p1: page 1]

VO

## VOU1120_DATA11

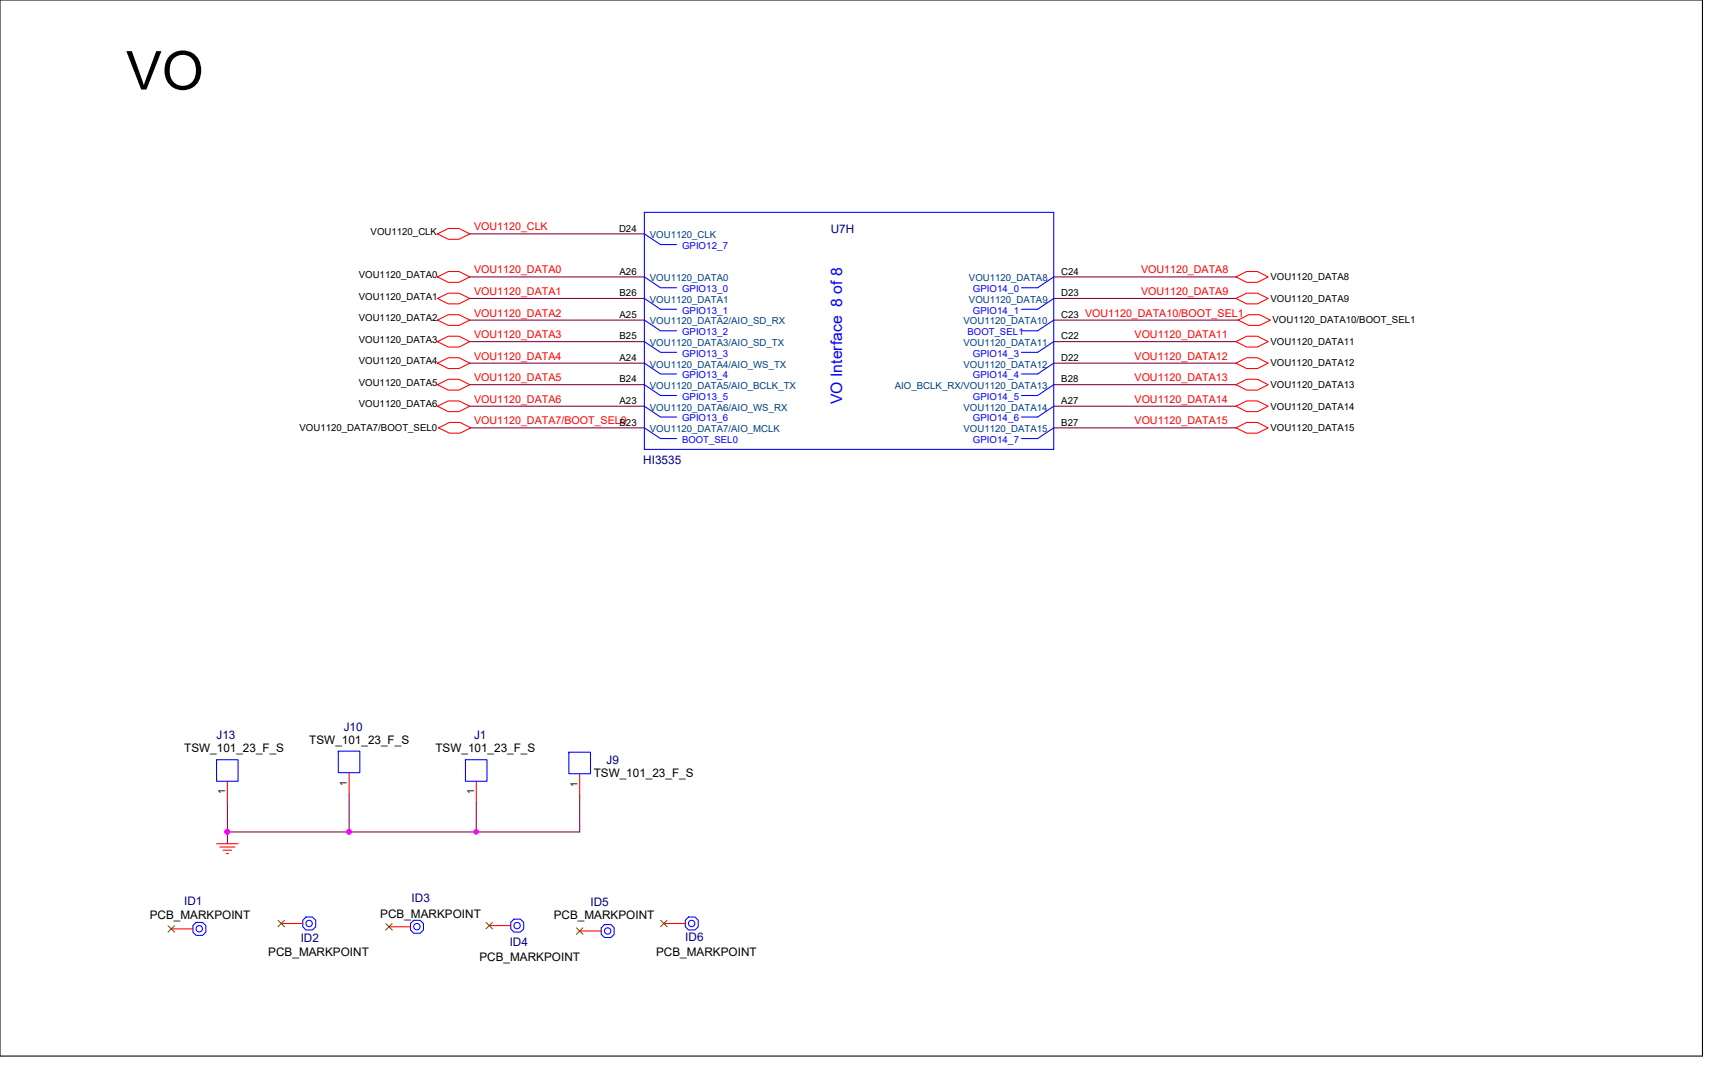
[picture p2: page 2]

The HDMI differential trace impedance is 100 OHM. HDMI The HDMI trace length is less than 5 inch.

## HDMI_SEC

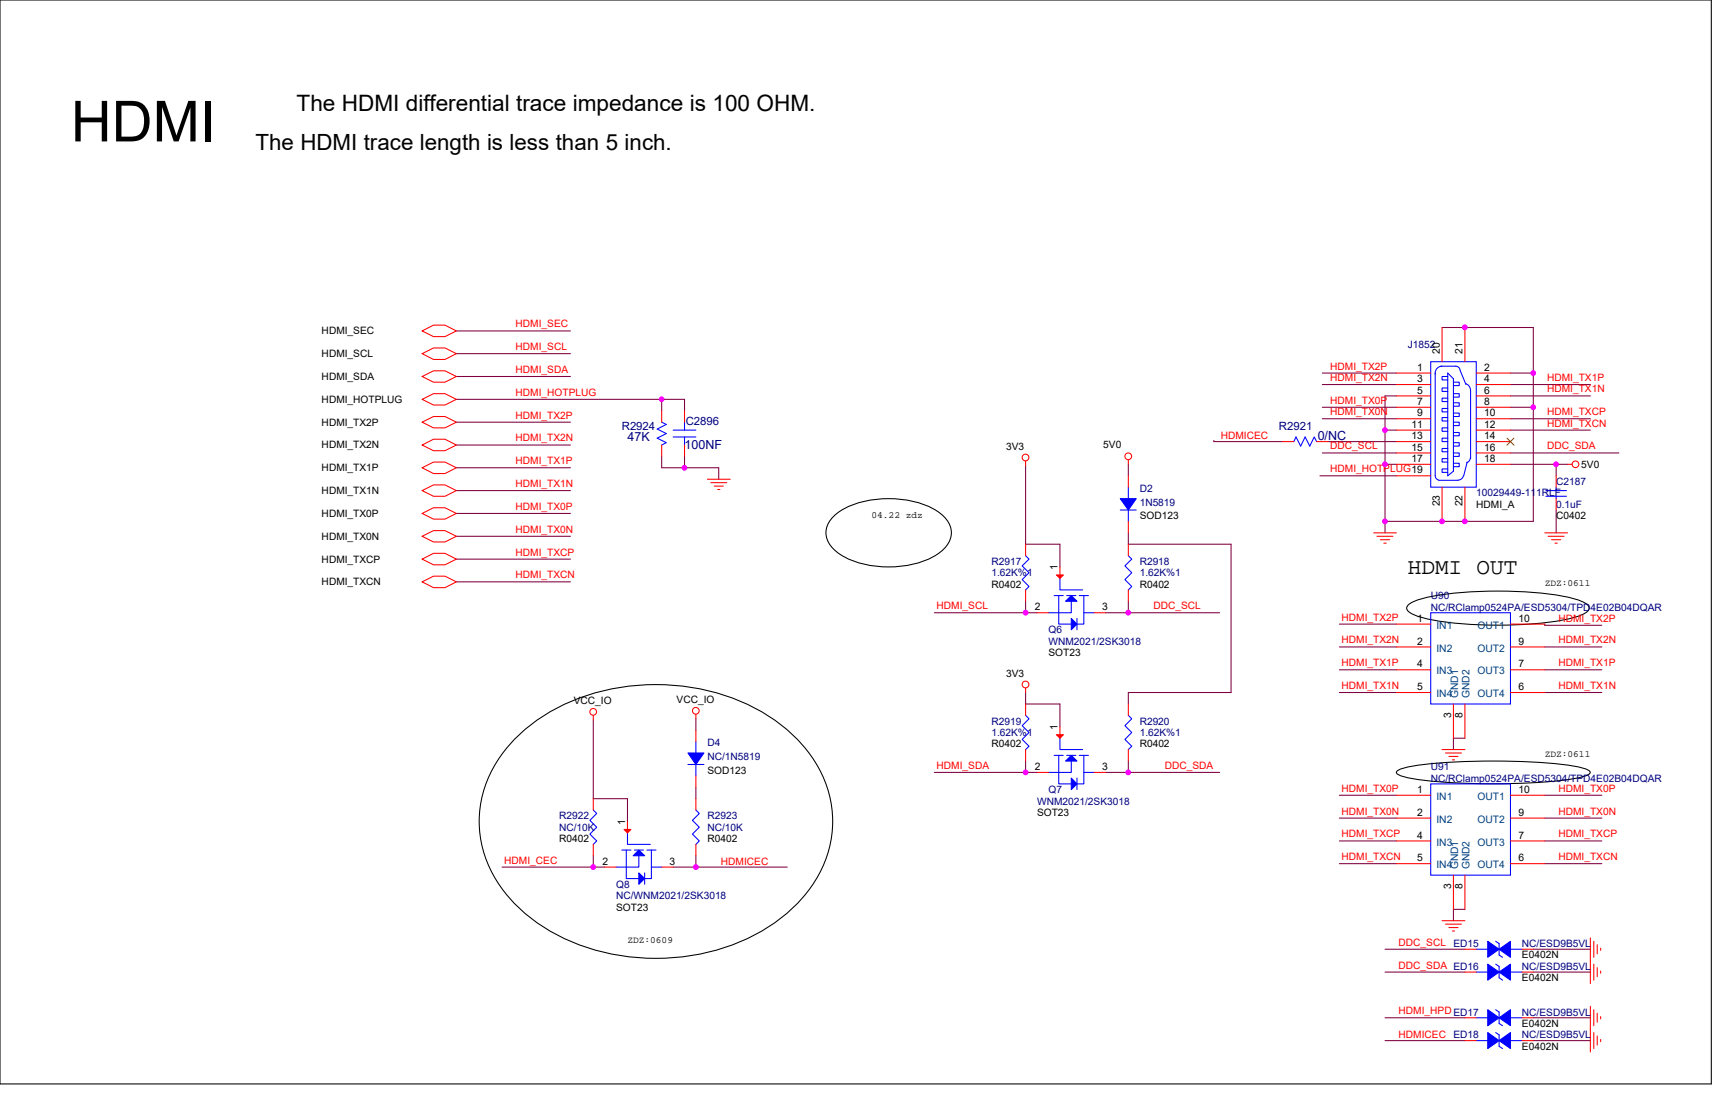
[picture p3: page 3]

### Put 75 OHM Resistors close to Hi3535

# DISPLAY

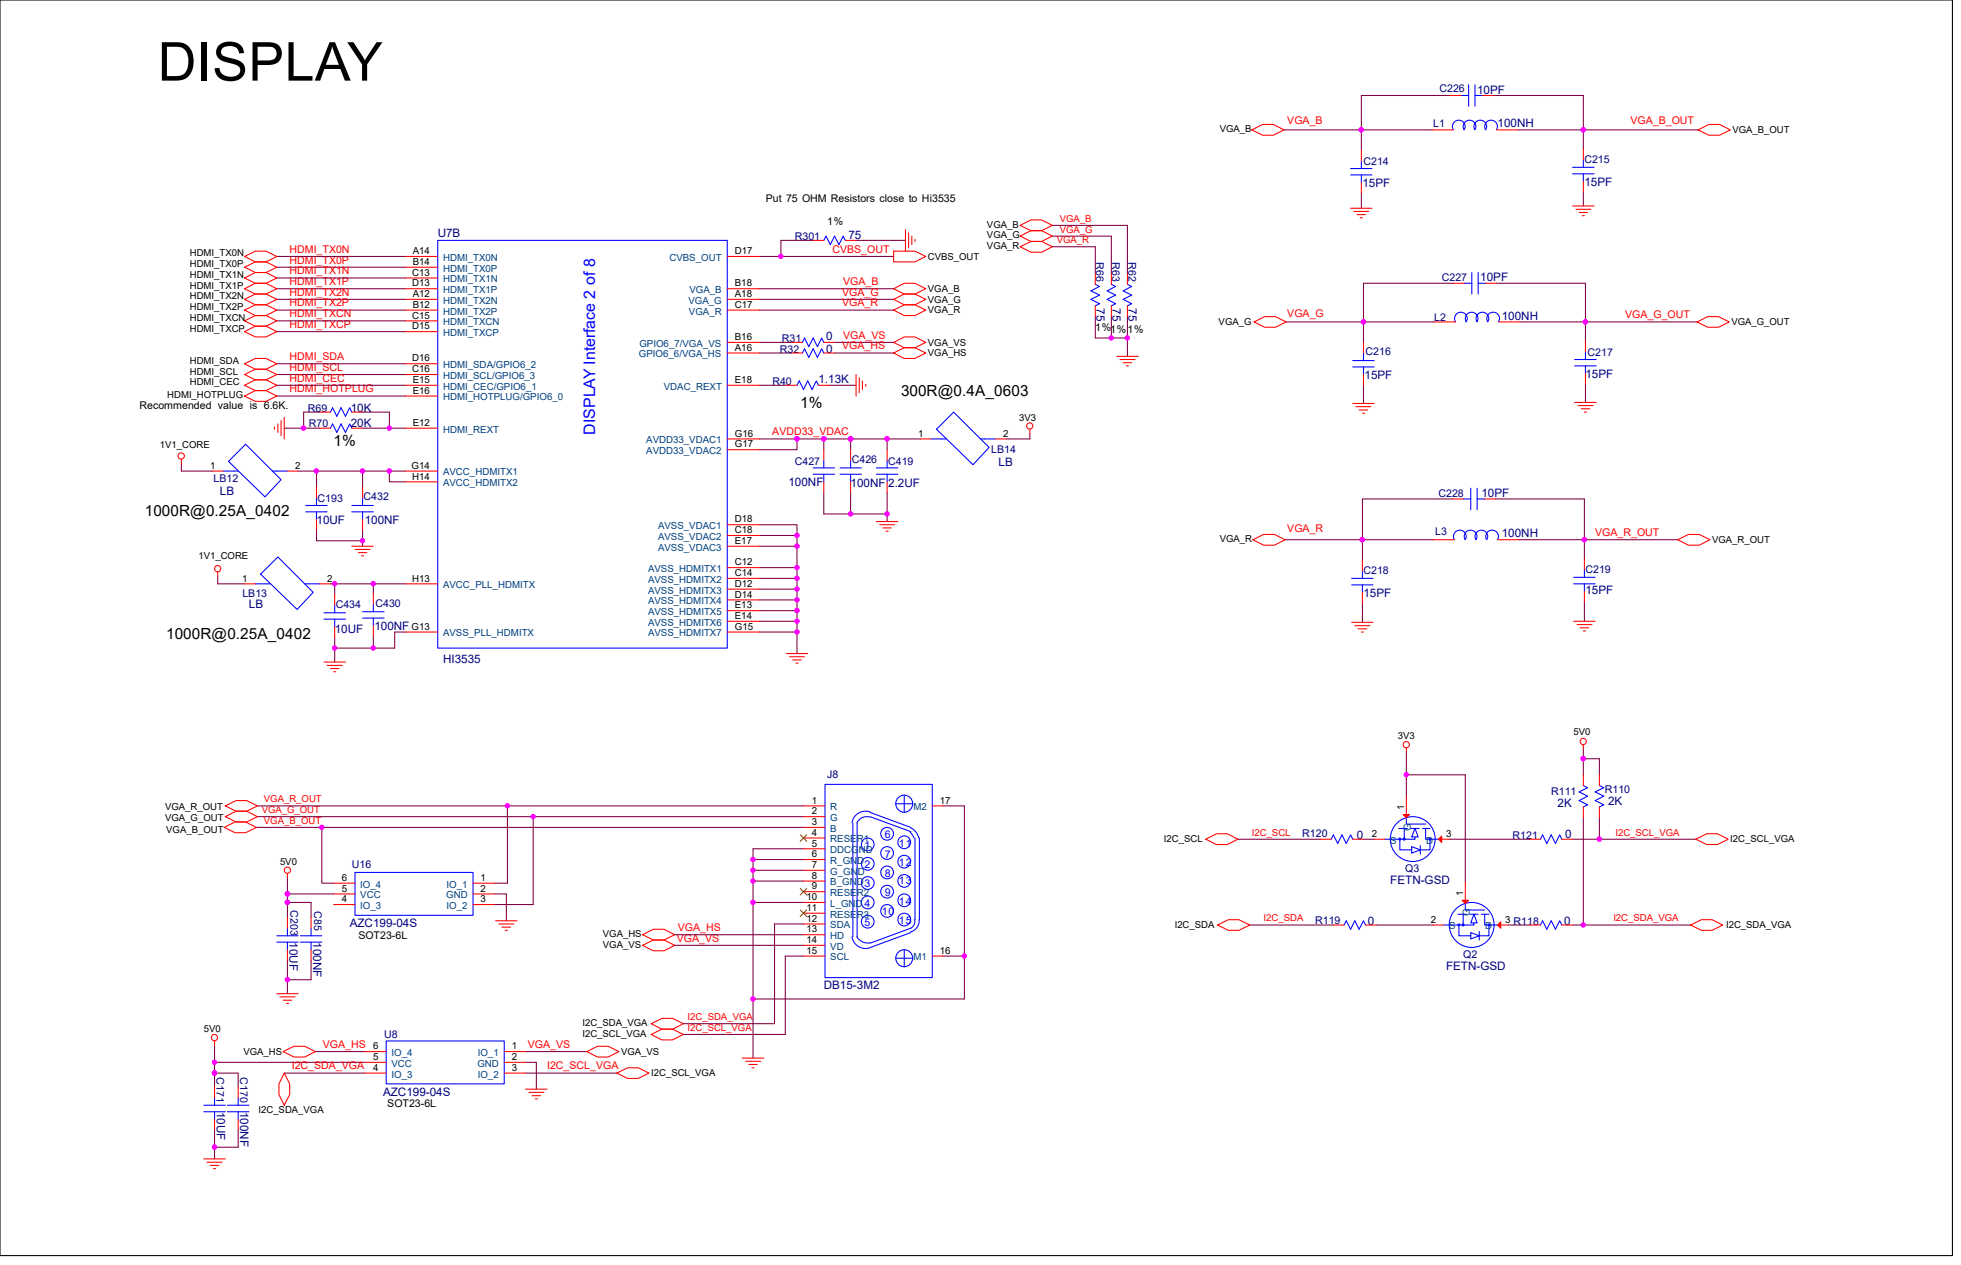
[picture p4: page 4]

# USB3.0

The SATA trace length is less than 5 inch. The USB trace length is less than 5 inch.

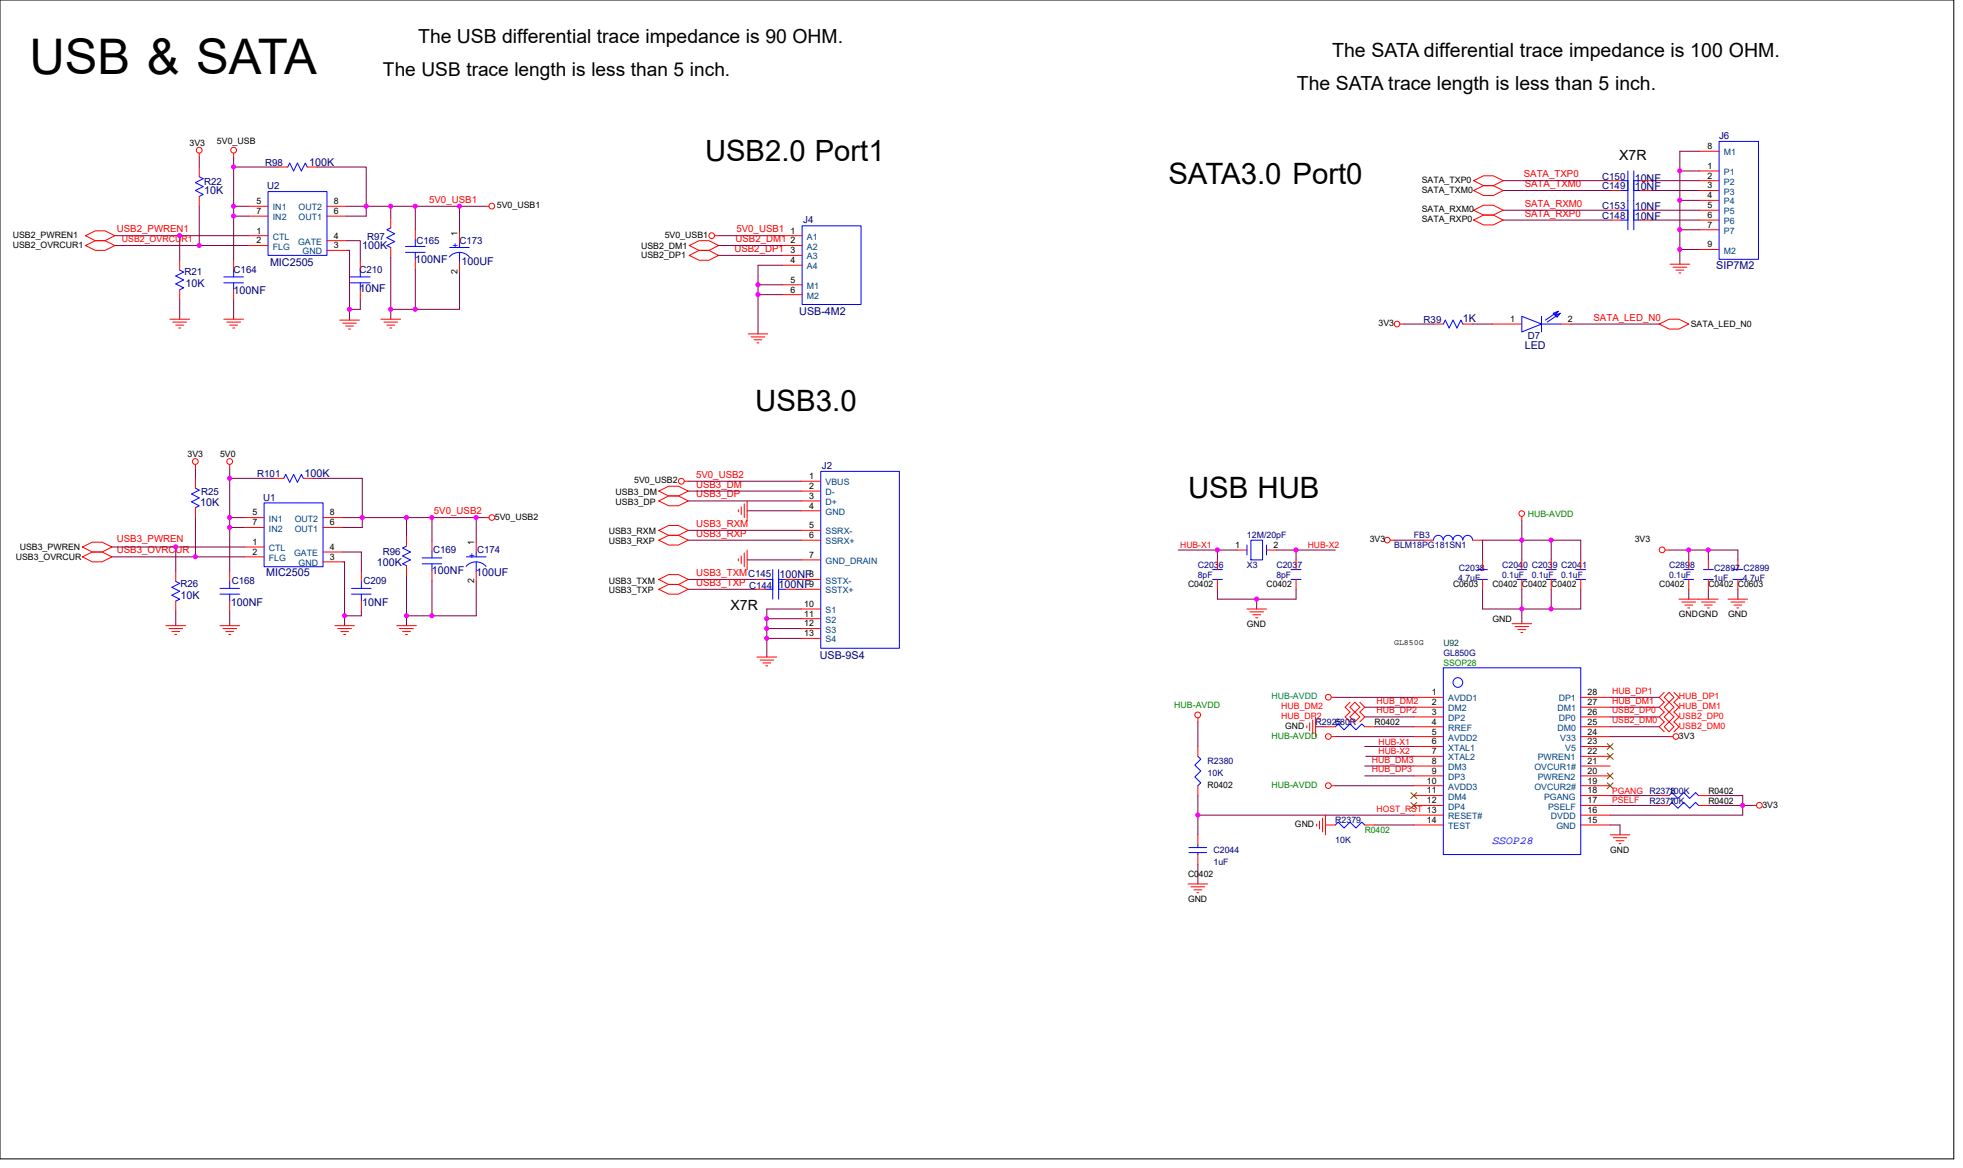
[picture p5: page 5]

The SATA differential trace impedance is 100 OHM. The USB differential trace impedance is 90 OHM.

# Interface

1%

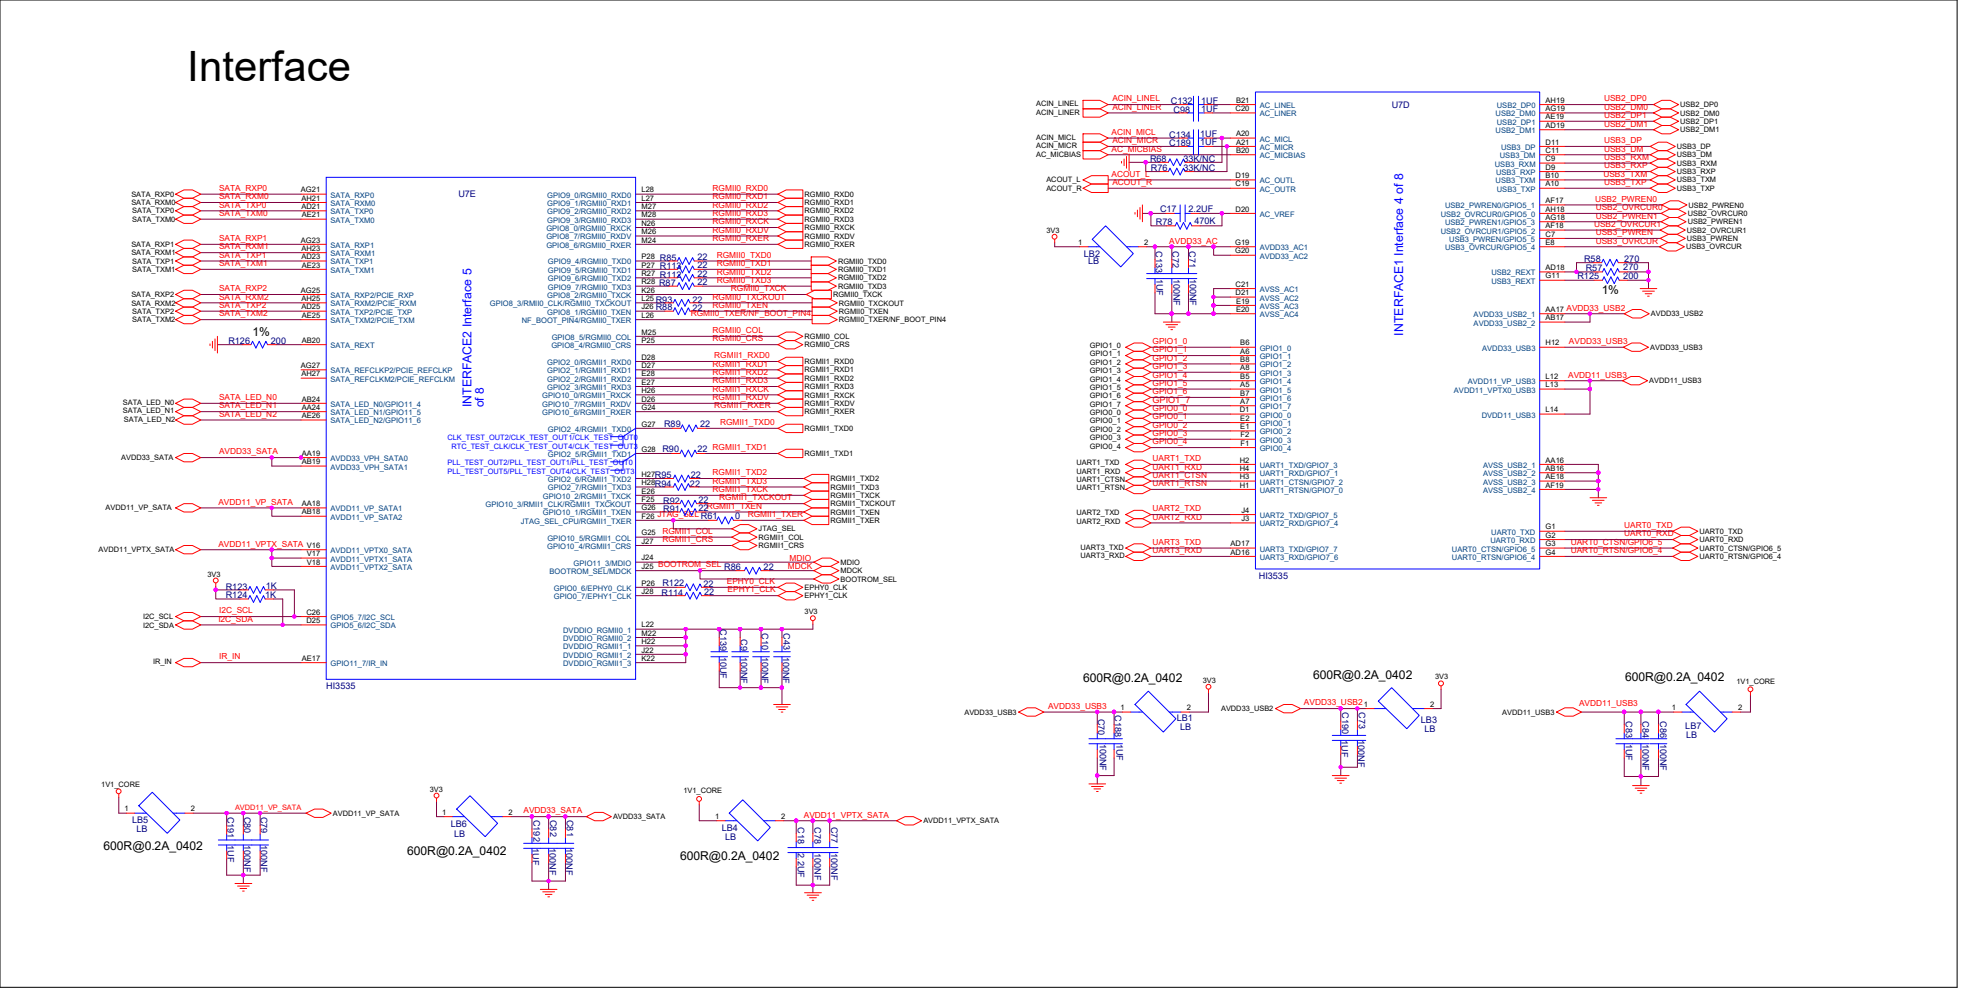
[picture p6: page 6]

R68 33K/NC | AC_OUTL D19 | USB3_RXM USB3_RXP

# 00100 4k page size,24bit ecc,256page/block,5addr 00101 2k page size,24bit ecc,64page/block,5addr

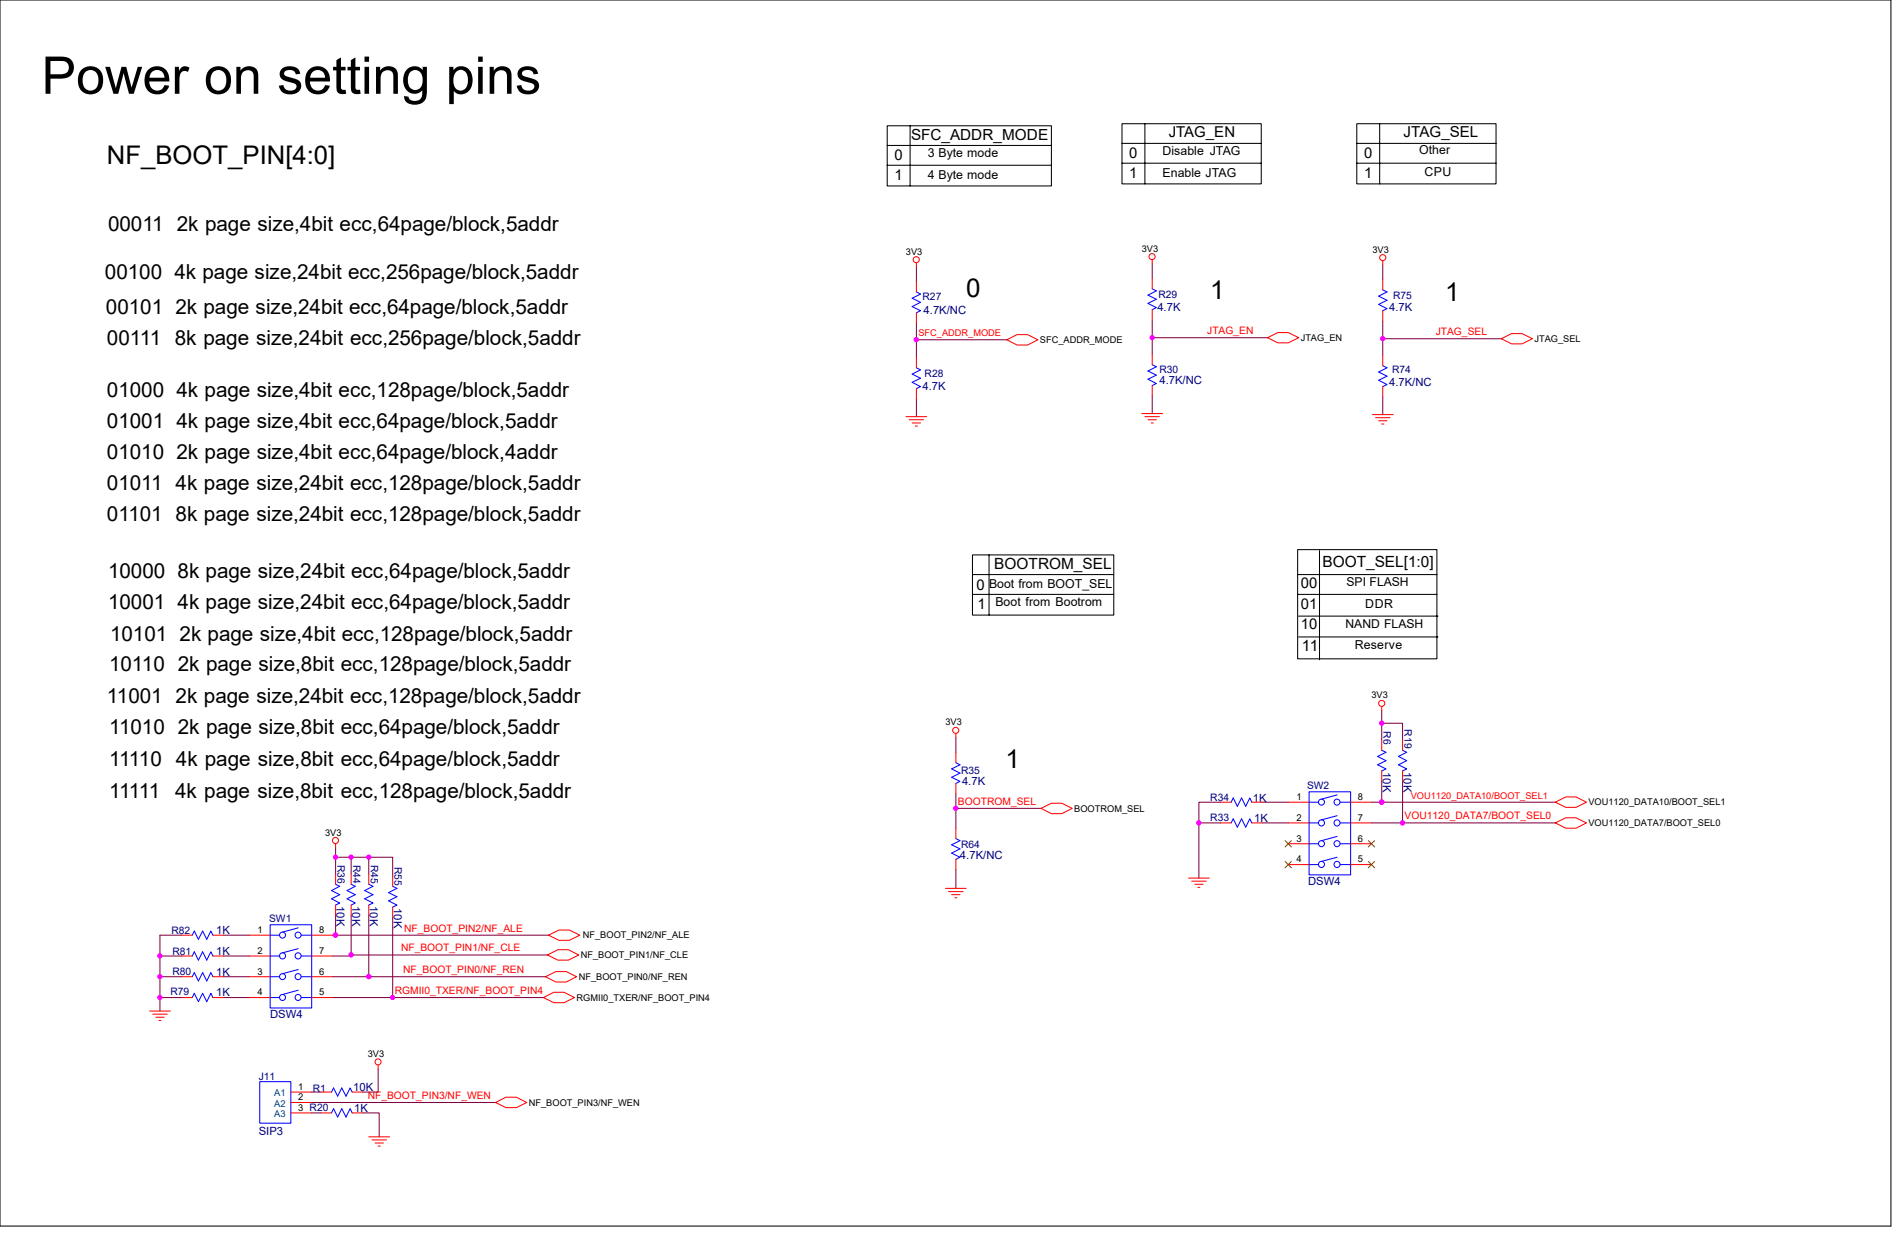
[picture p7: page 7]

Power on setting pins

00011 2k page size,4bit ecc,64page/block,5addr

00111 8k page size,24bit ecc,256page/block,5addr

01000 4k page size,4bit ecc,128page/block,5addr
01001 4k page size,4bit ecc,64page/block,5addr
01010 2k page size,4bit ecc,64page/block,4addr
01011 4k page size,24bit ecc,128page/block,5addr
01101 8k page size,24bit ecc,128page/block,5addr

10000 8k page size,24bit ecc,64page/block,5addr
10001 4k page size,24bit ecc,64page/block,5addr
10101 2k page size,4bit ecc,128page/block,5addr
10110 2k page size,8bit ecc,128page/block,5addr
11001 2k page size,24bit ecc,128page/block,5addr
11010 2k page size,8bit ecc,64page/block,5addr
11110 4k page size,8bit ecc,64page/block,5addr
11111 4k page size,8bit ecc,128page/block,5addr

10 | NAND FLASH
11 | Reserve

Put this cap close to the Hi3535.

# SYSTEM & FLASH

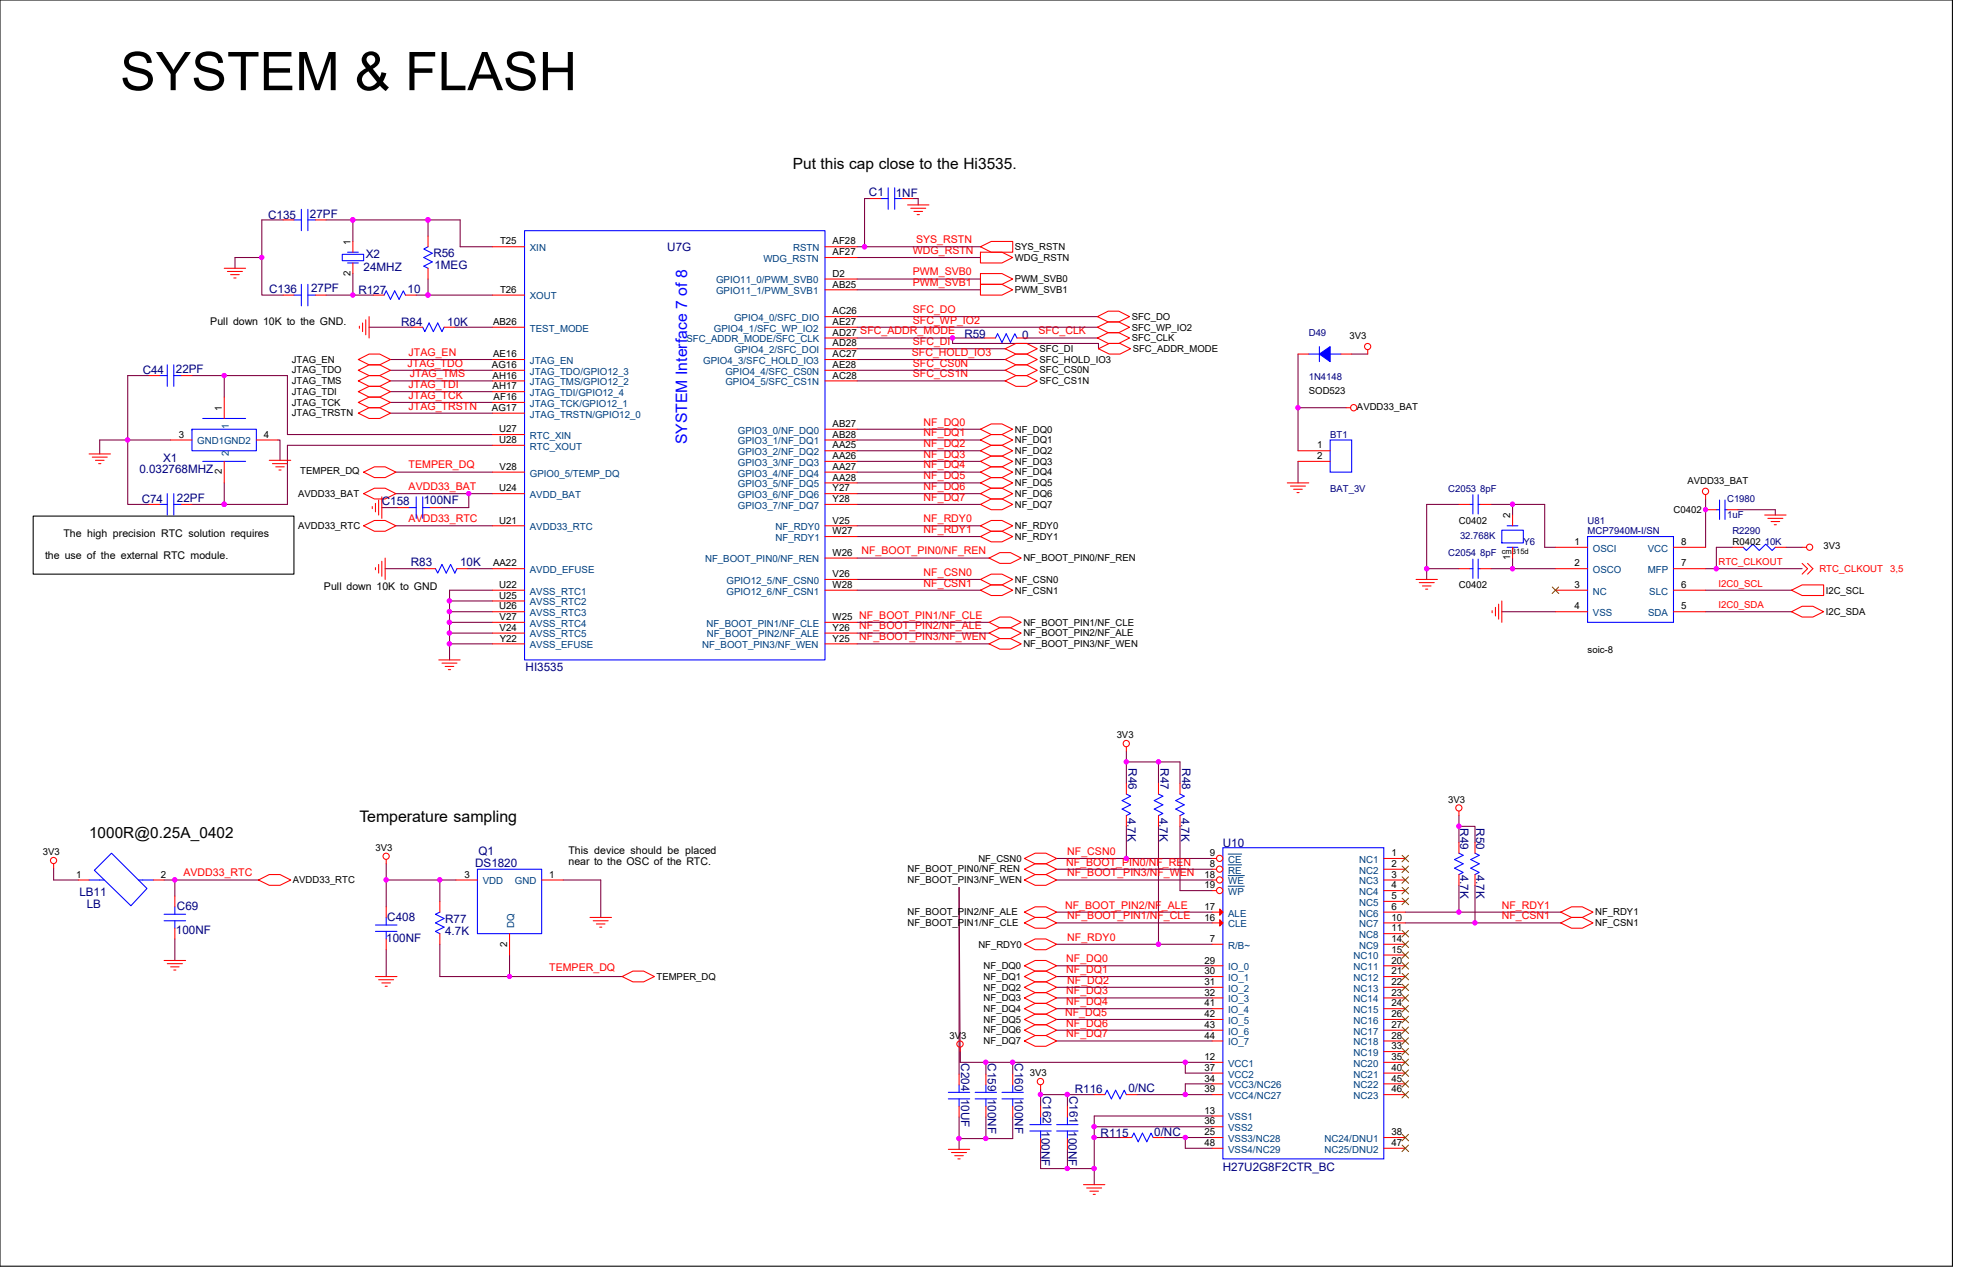
[picture p8: page 8]

Pull down 10K to the GND.

TEMPER_DQ AVDD33_BAT | GPIO0_5/TEMP_DQ V28 AVDD_BAT U24 AVDD33_RTC U21 AVDD_EFUSE AA22 | NF_DQ2 NF_DQ3 | 2

The high precision RTC solution requires
the use of the external RTC module.

Pull down 10K to GND

This device should be placed
near to the OSC of the RTC.

1%

# DDR3_B

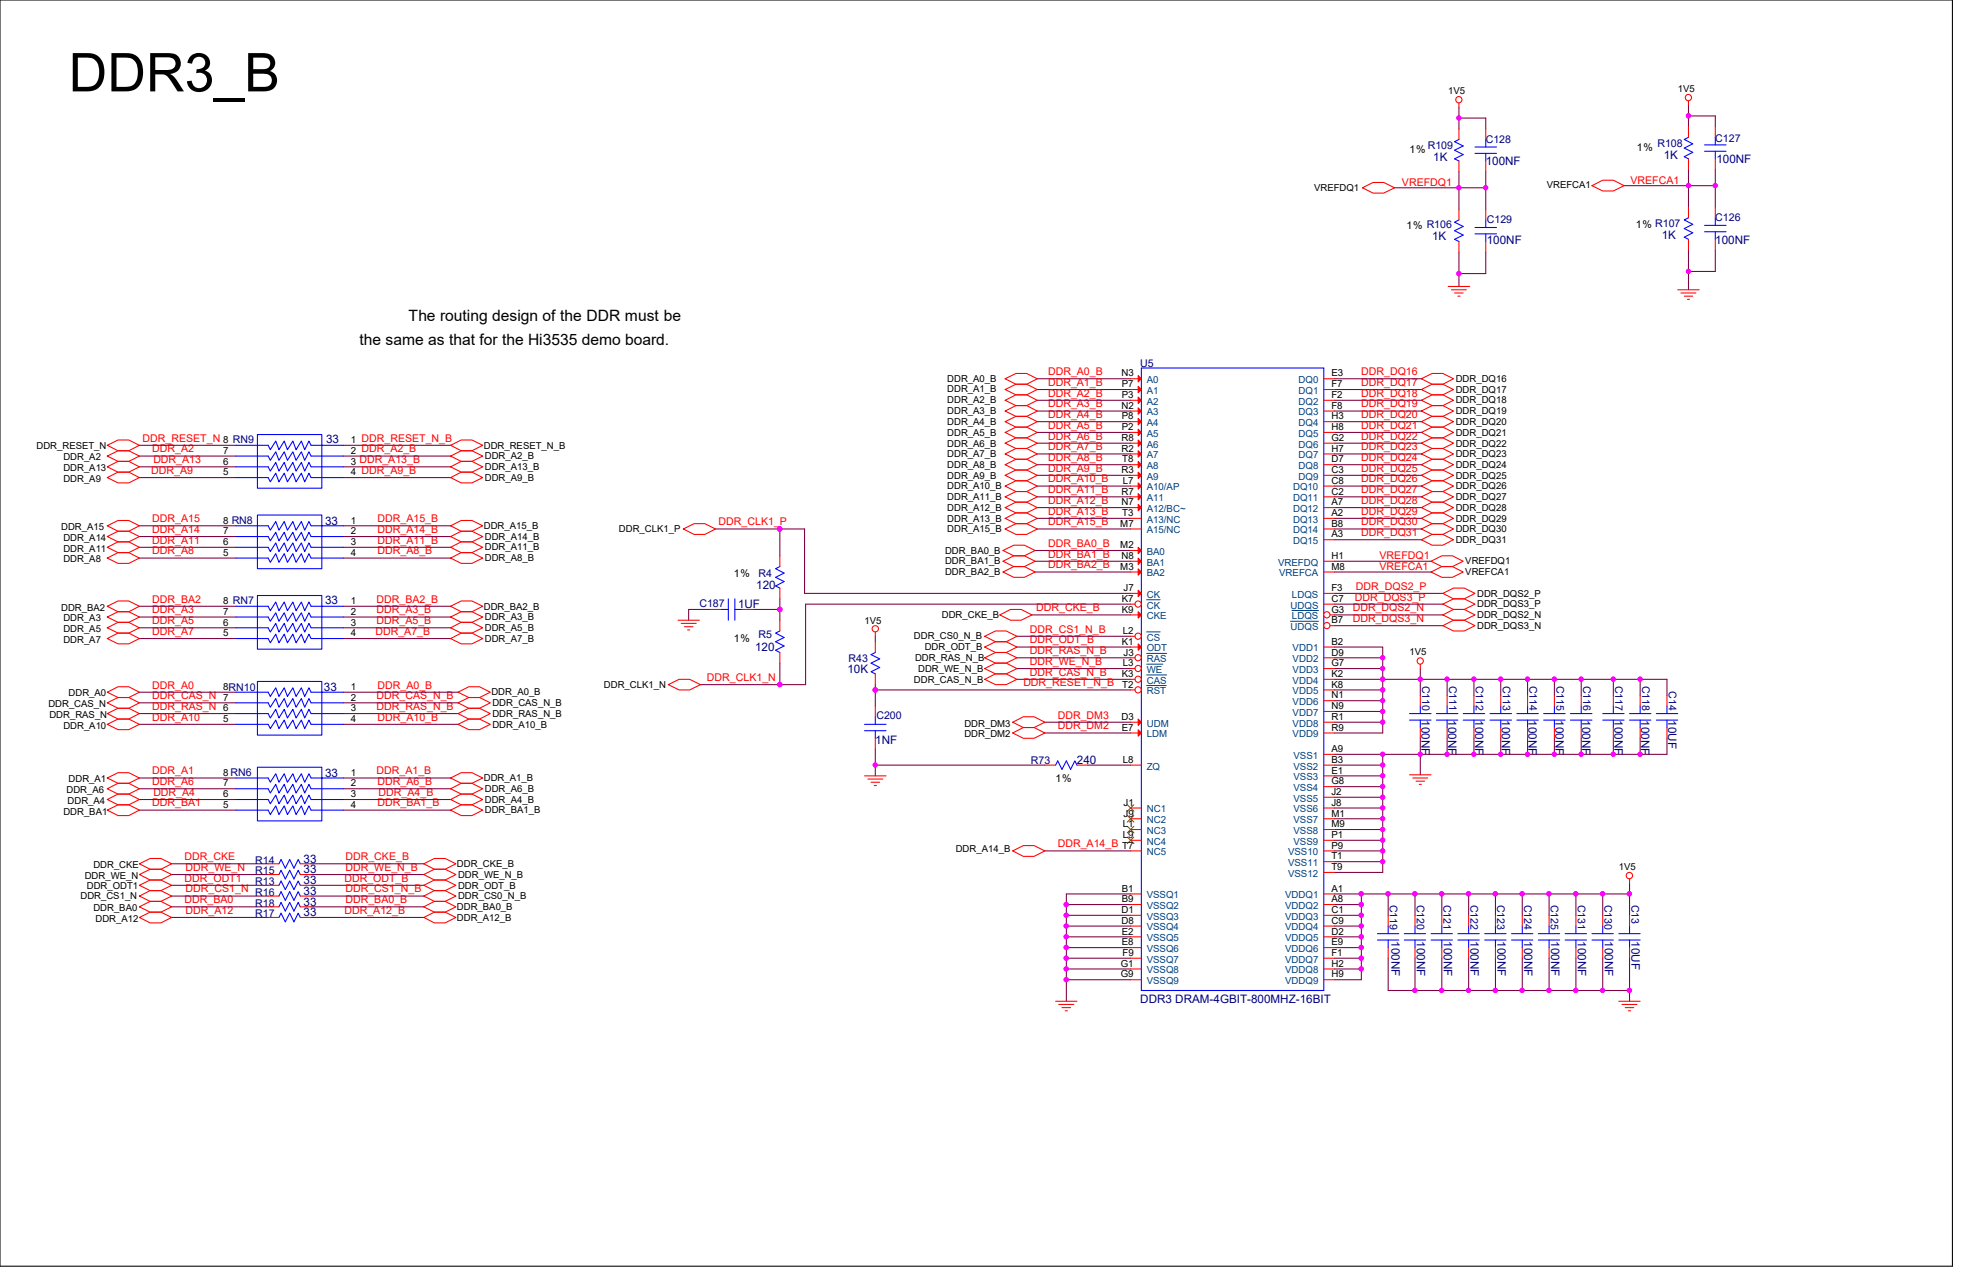
[picture p9: page 9]

The routing design of the DDR must be
the same as that for the Hi3535 demo board.

1%

the same as that for the Hi3535 demo board.

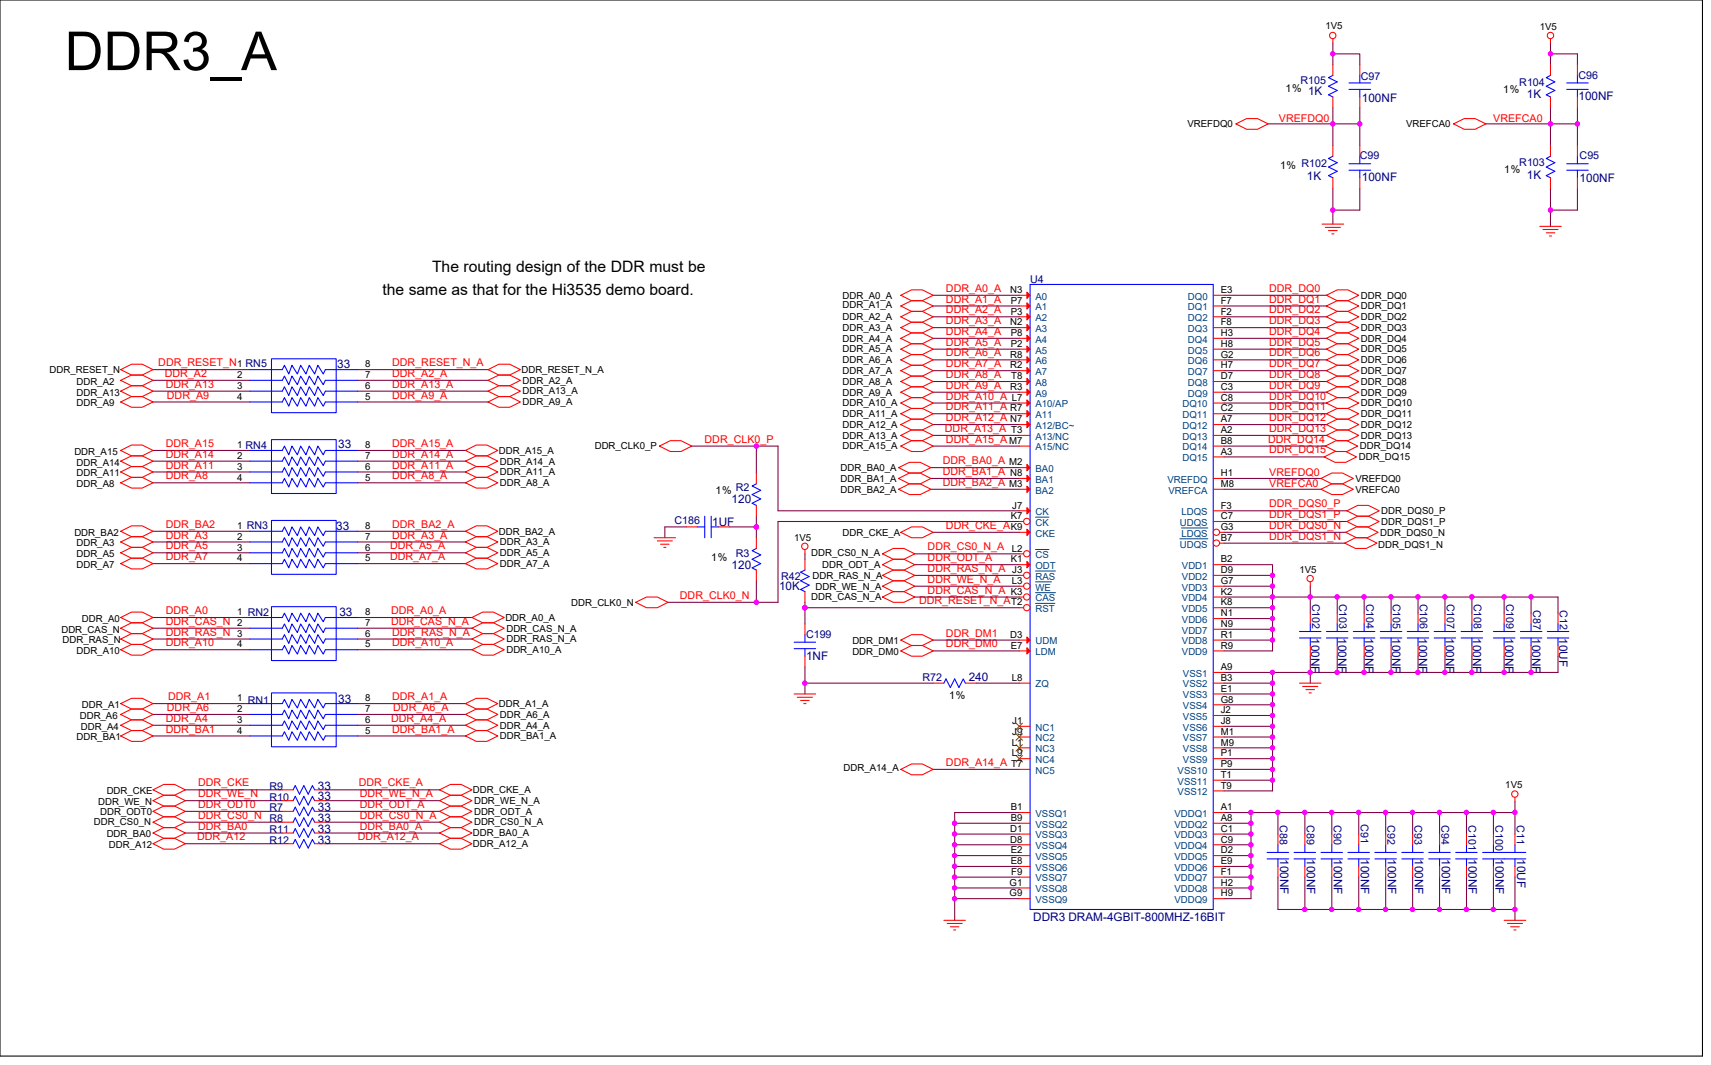
[picture p10: page 10]

The routing design of the DDR must be

# HI3535 DDR3

the same as that for the Hi3535 demo board.

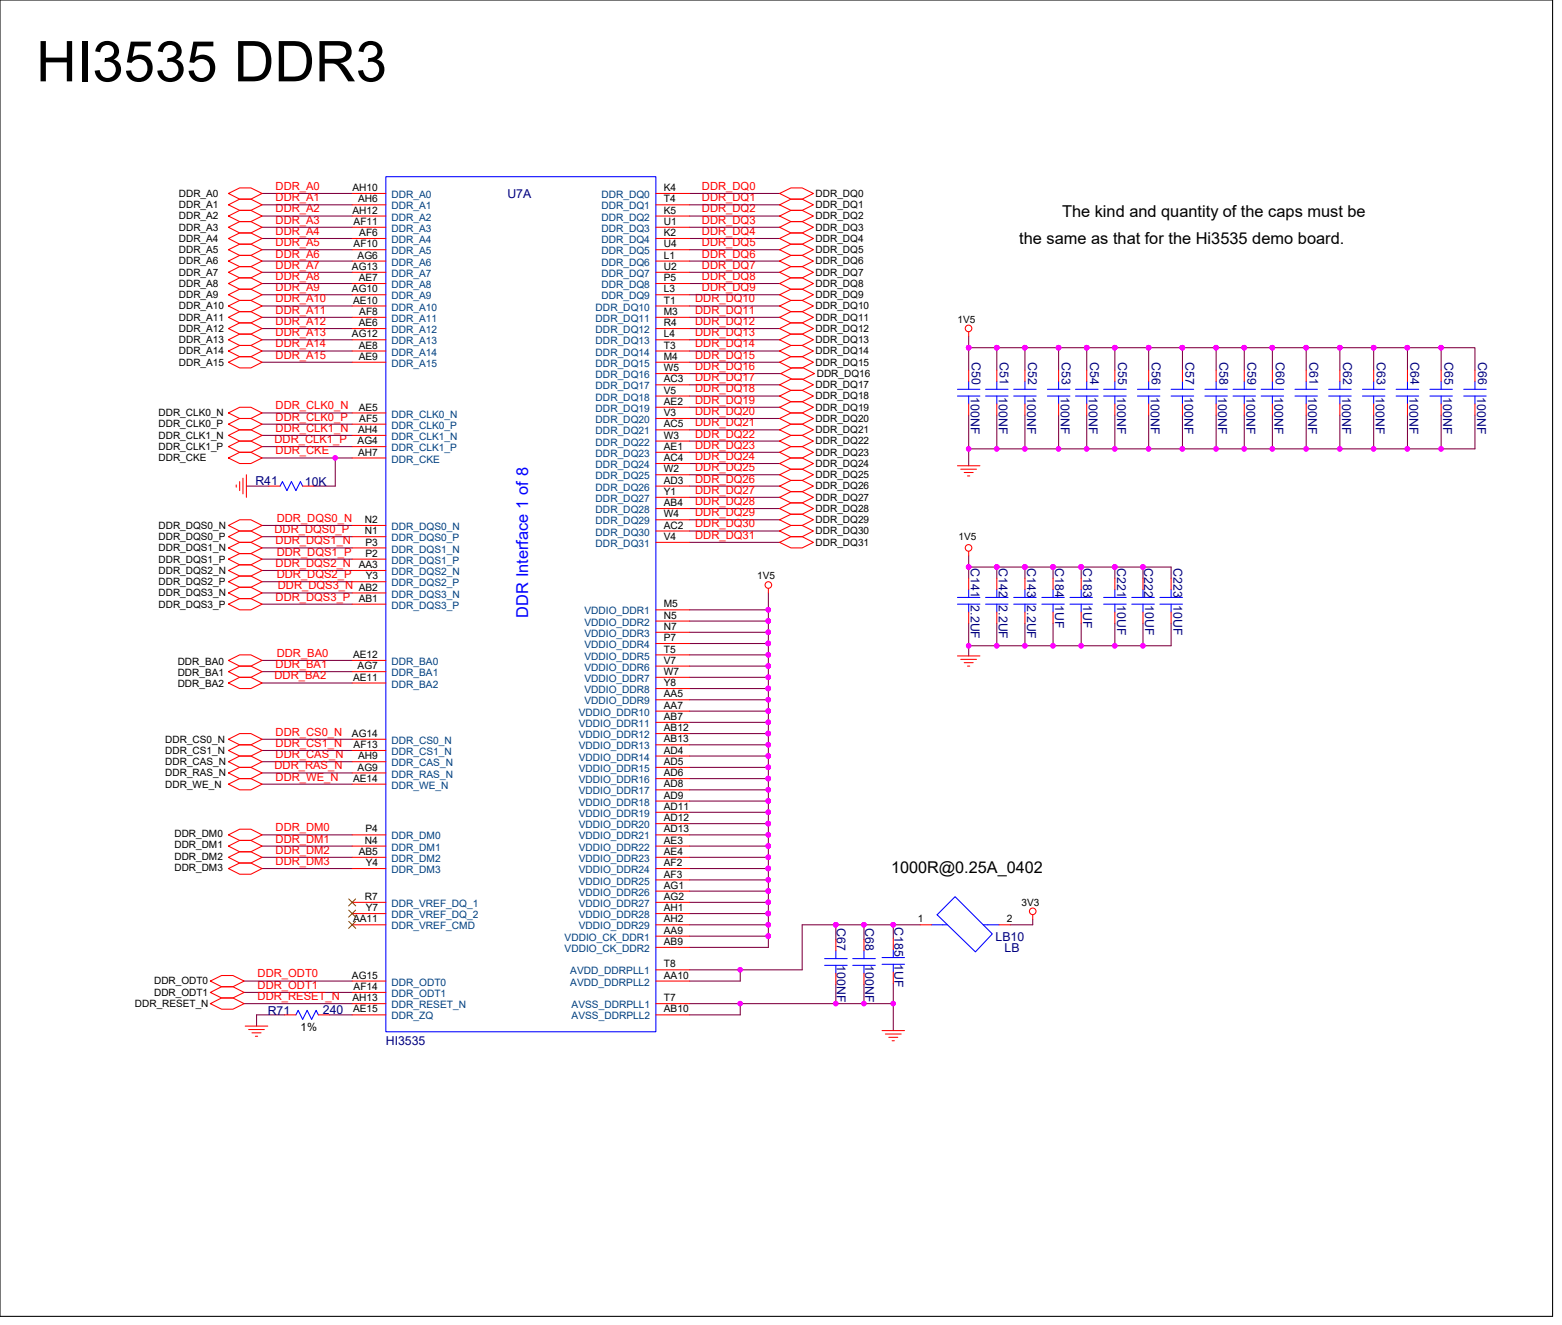
[picture p11: page 11]

The kind and quantity of the caps must be

# POWER & VSS

# 1000R@0.25A_0402

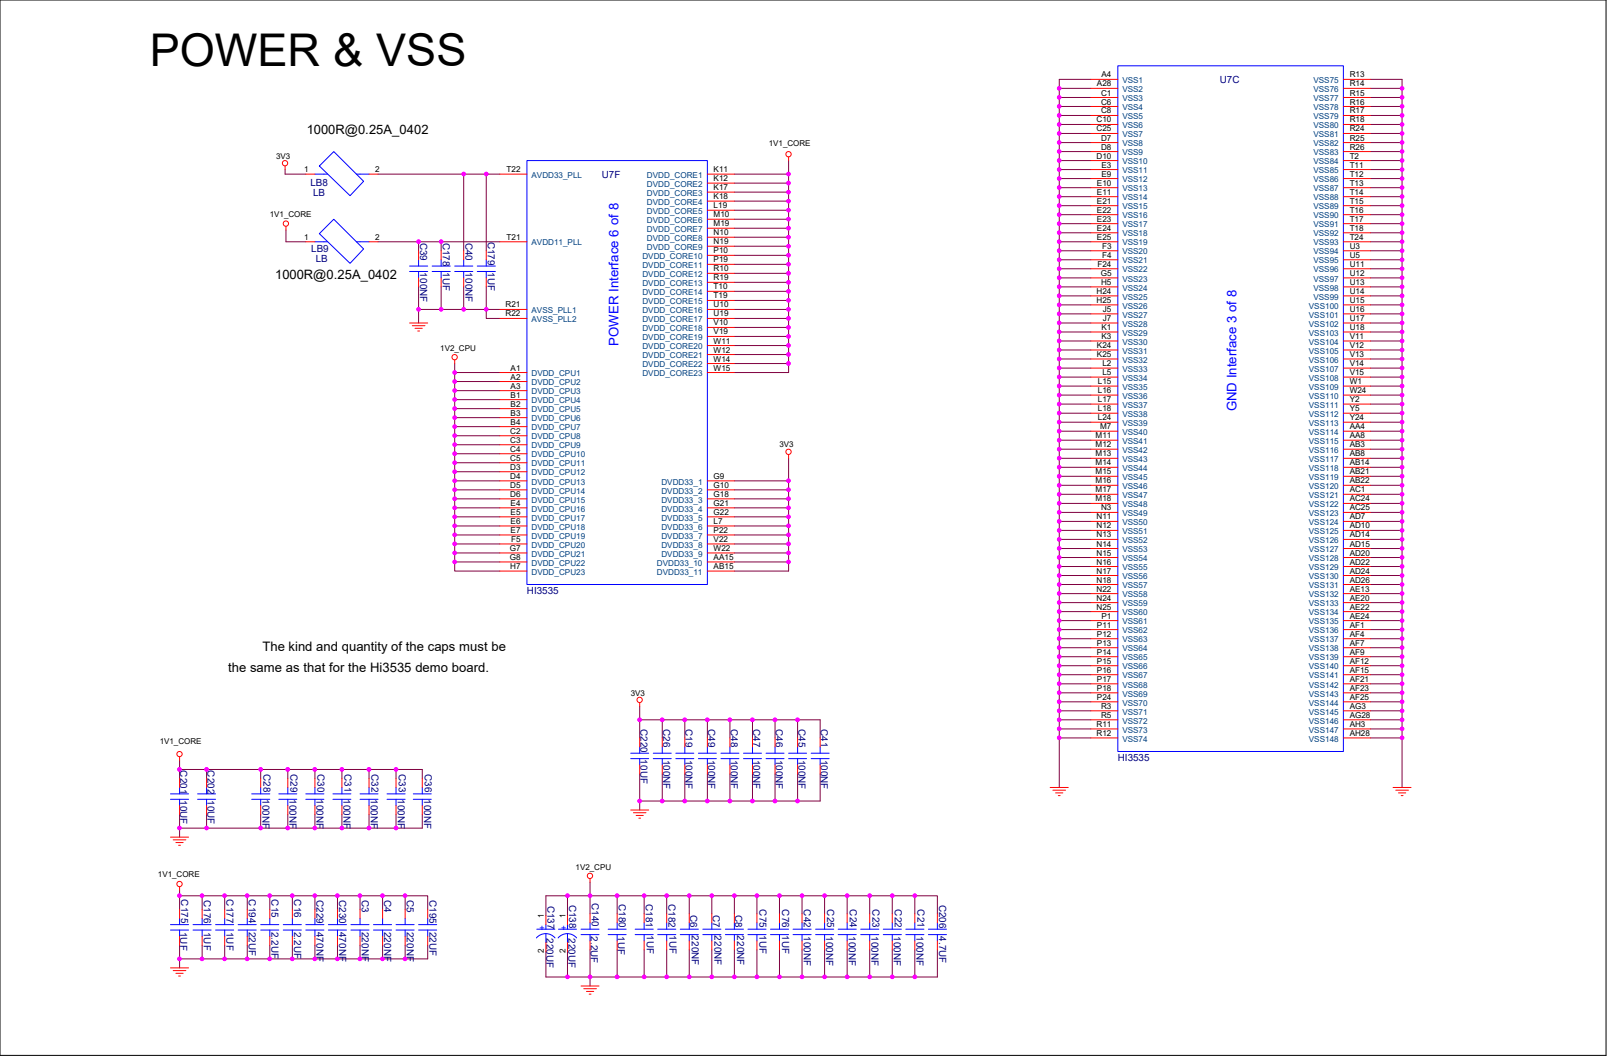
[picture p12: page 12]

AVDD11_PLL T21

AVSS_PLL2 R22 AVSS_PLL1 R21

The kind and quantity of the caps must be
the same as that for the Hi3535 demo board.

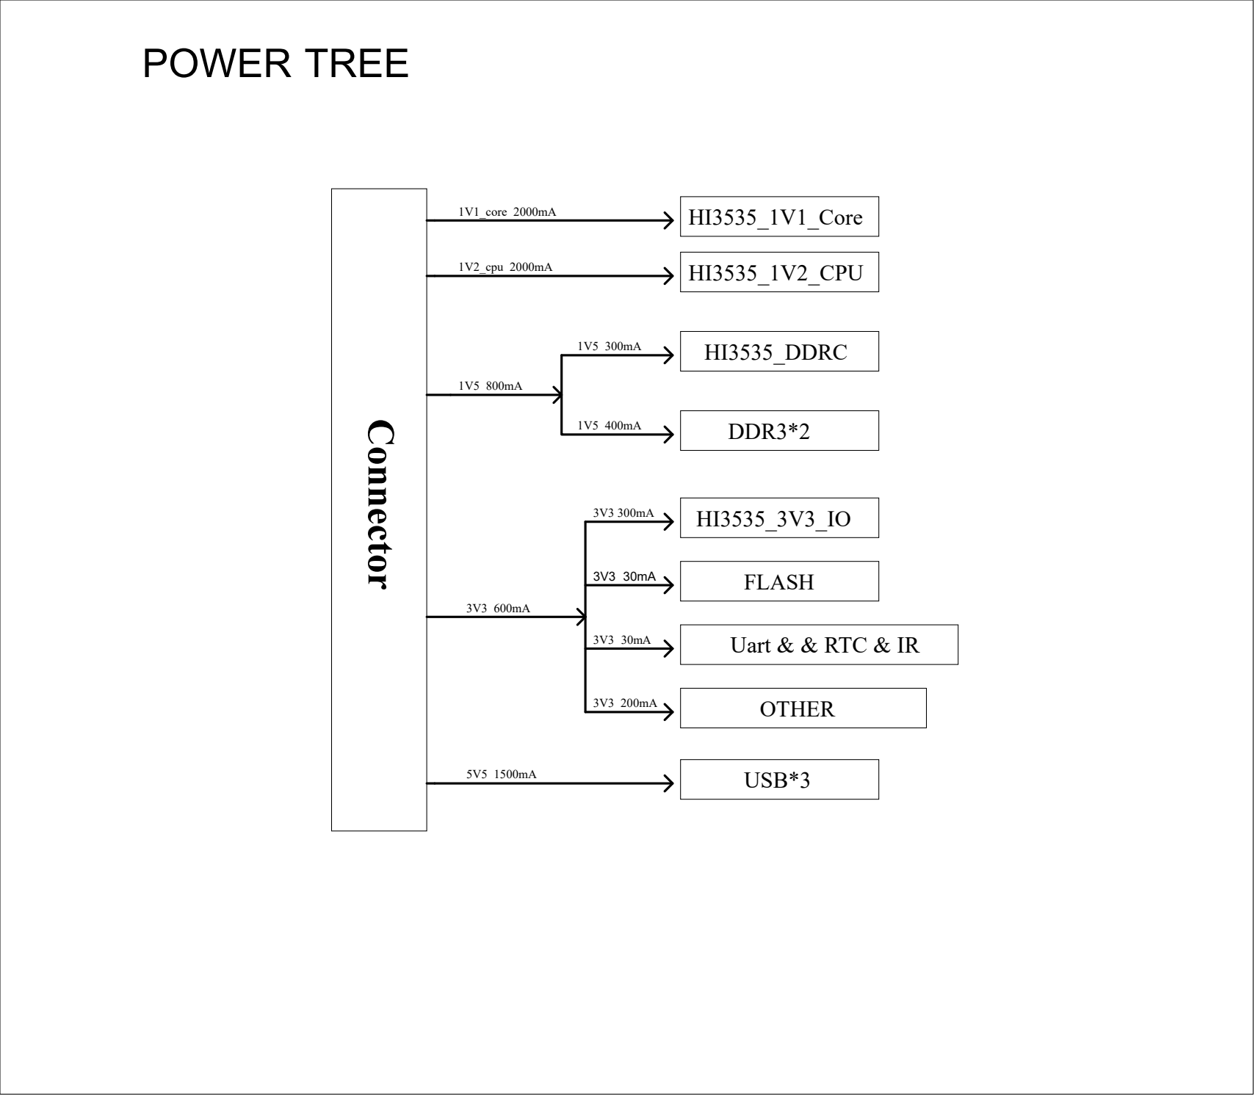
[picture p13: figure]
POWER TREE; Connector; HI3535_1V1_Core; HI3535_1V2_CPU; HI3535_DDRC; DDR3*2; FLASH; OTHER; USB*3; Uart & & RTC & IR; 1V1_core 2000mA; 1V2_cpu 2000mA

# BLOCK DIAGRAM

# USB3.0

# USB2.0 USB2.0

# DDR

# DDR

SATA3.0 | SATA3.0 | SATA3.0
| SPI
HDMI | VGA

# Connector

# Connector HI3535 Sys crystal RTC crystal

# Nandflash

# 2013.07.10 Ver.A schematic

# CHANGE LIST

# 2013.09.27 Change C144 C145 form 10nF to 100nF

# 16.Connector

15.VO

# 14.HDMI

# 13.DISPLAY

# 12.USB & SATA

# 11.INTERFACE

# 10.POWER ON SETTING PINS

# 09.SYSTEM & FLASH

# 08.DDR3_B

# 07.DDR3_A

# 06.Hi3535 DDR3

# 05.POWER & VSS

# 04.POWER TREE

# 03.BLOCK DIAGRAM

# 02.CHANGE LIST

# 01.Hi3535DMEB VER.A

# Hi3535DMEB VER.A

# ETH0

Reserve for cable discharge.

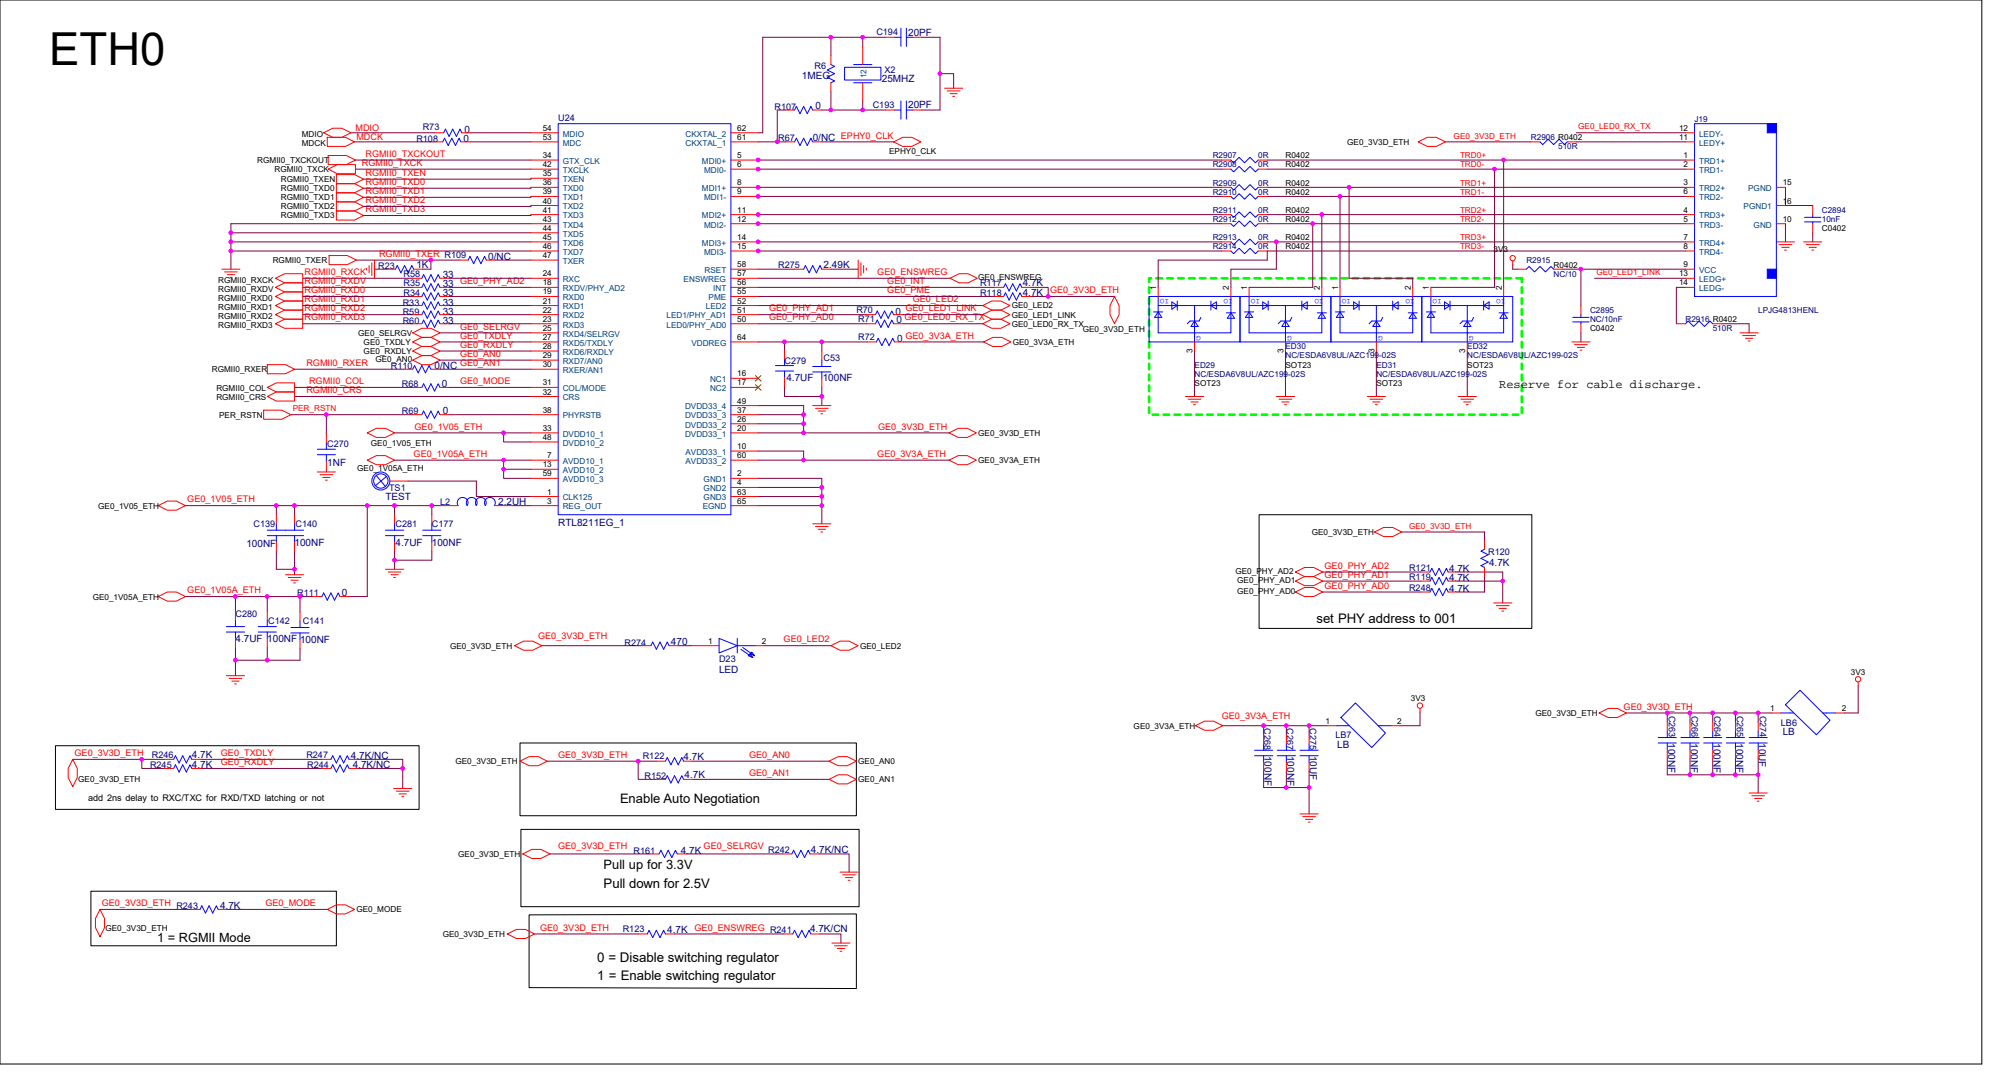
[picture p14: page 17]

set PHY address to 001

# ETH1

### 1MEG

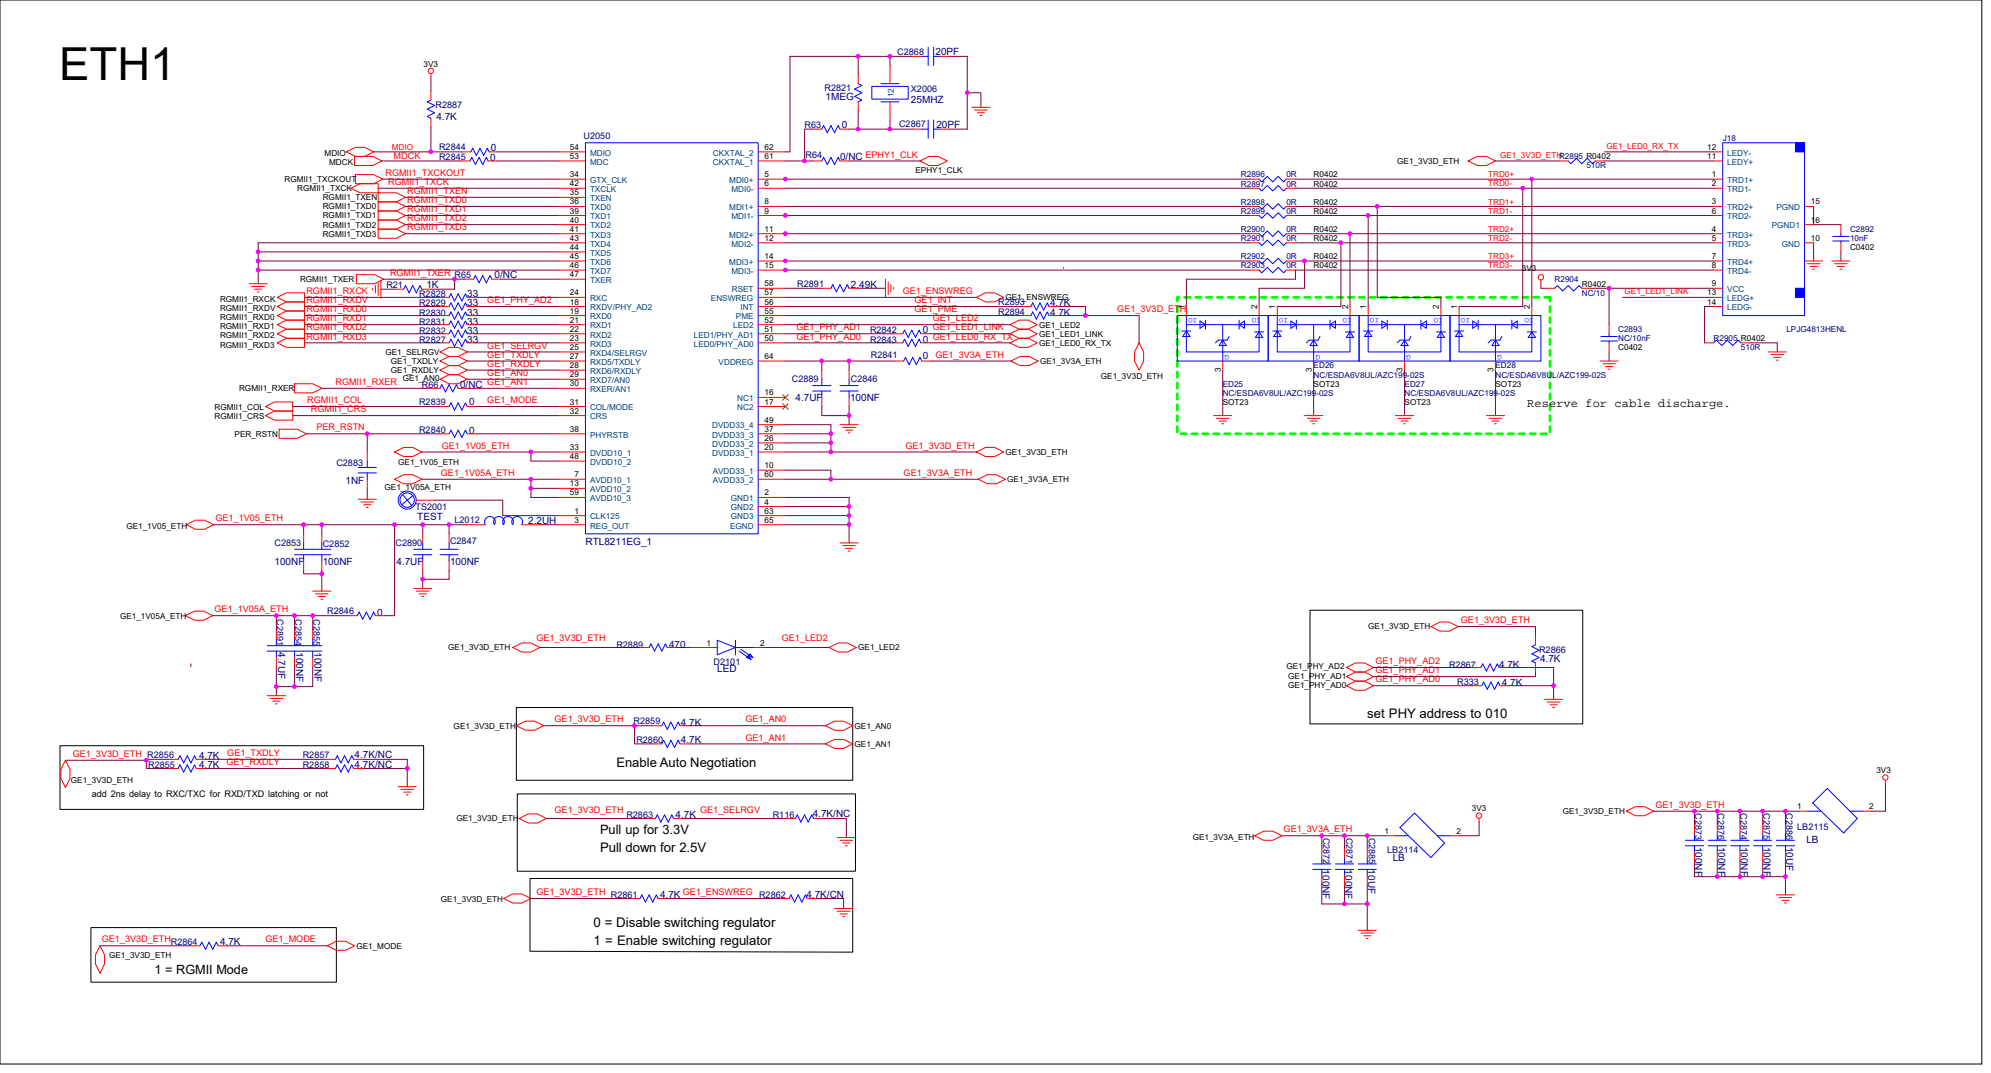
[picture p15: page 18]

set PHY address to 010

GE1_3V3D_ETH
add 2ns delay to RXC/TXC for RXD/TXD latching or not

# UART2_TXD UART0_TXD

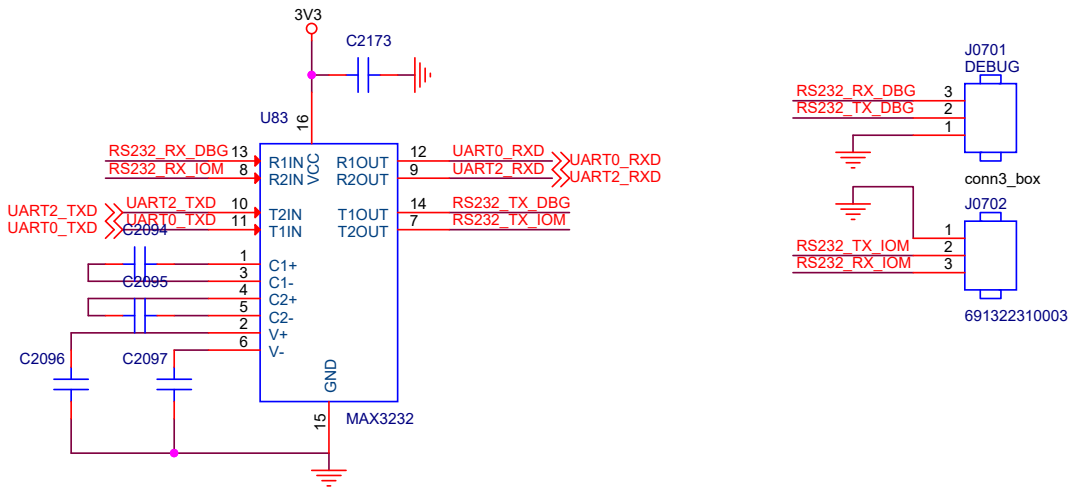
[picture p16: page 19]

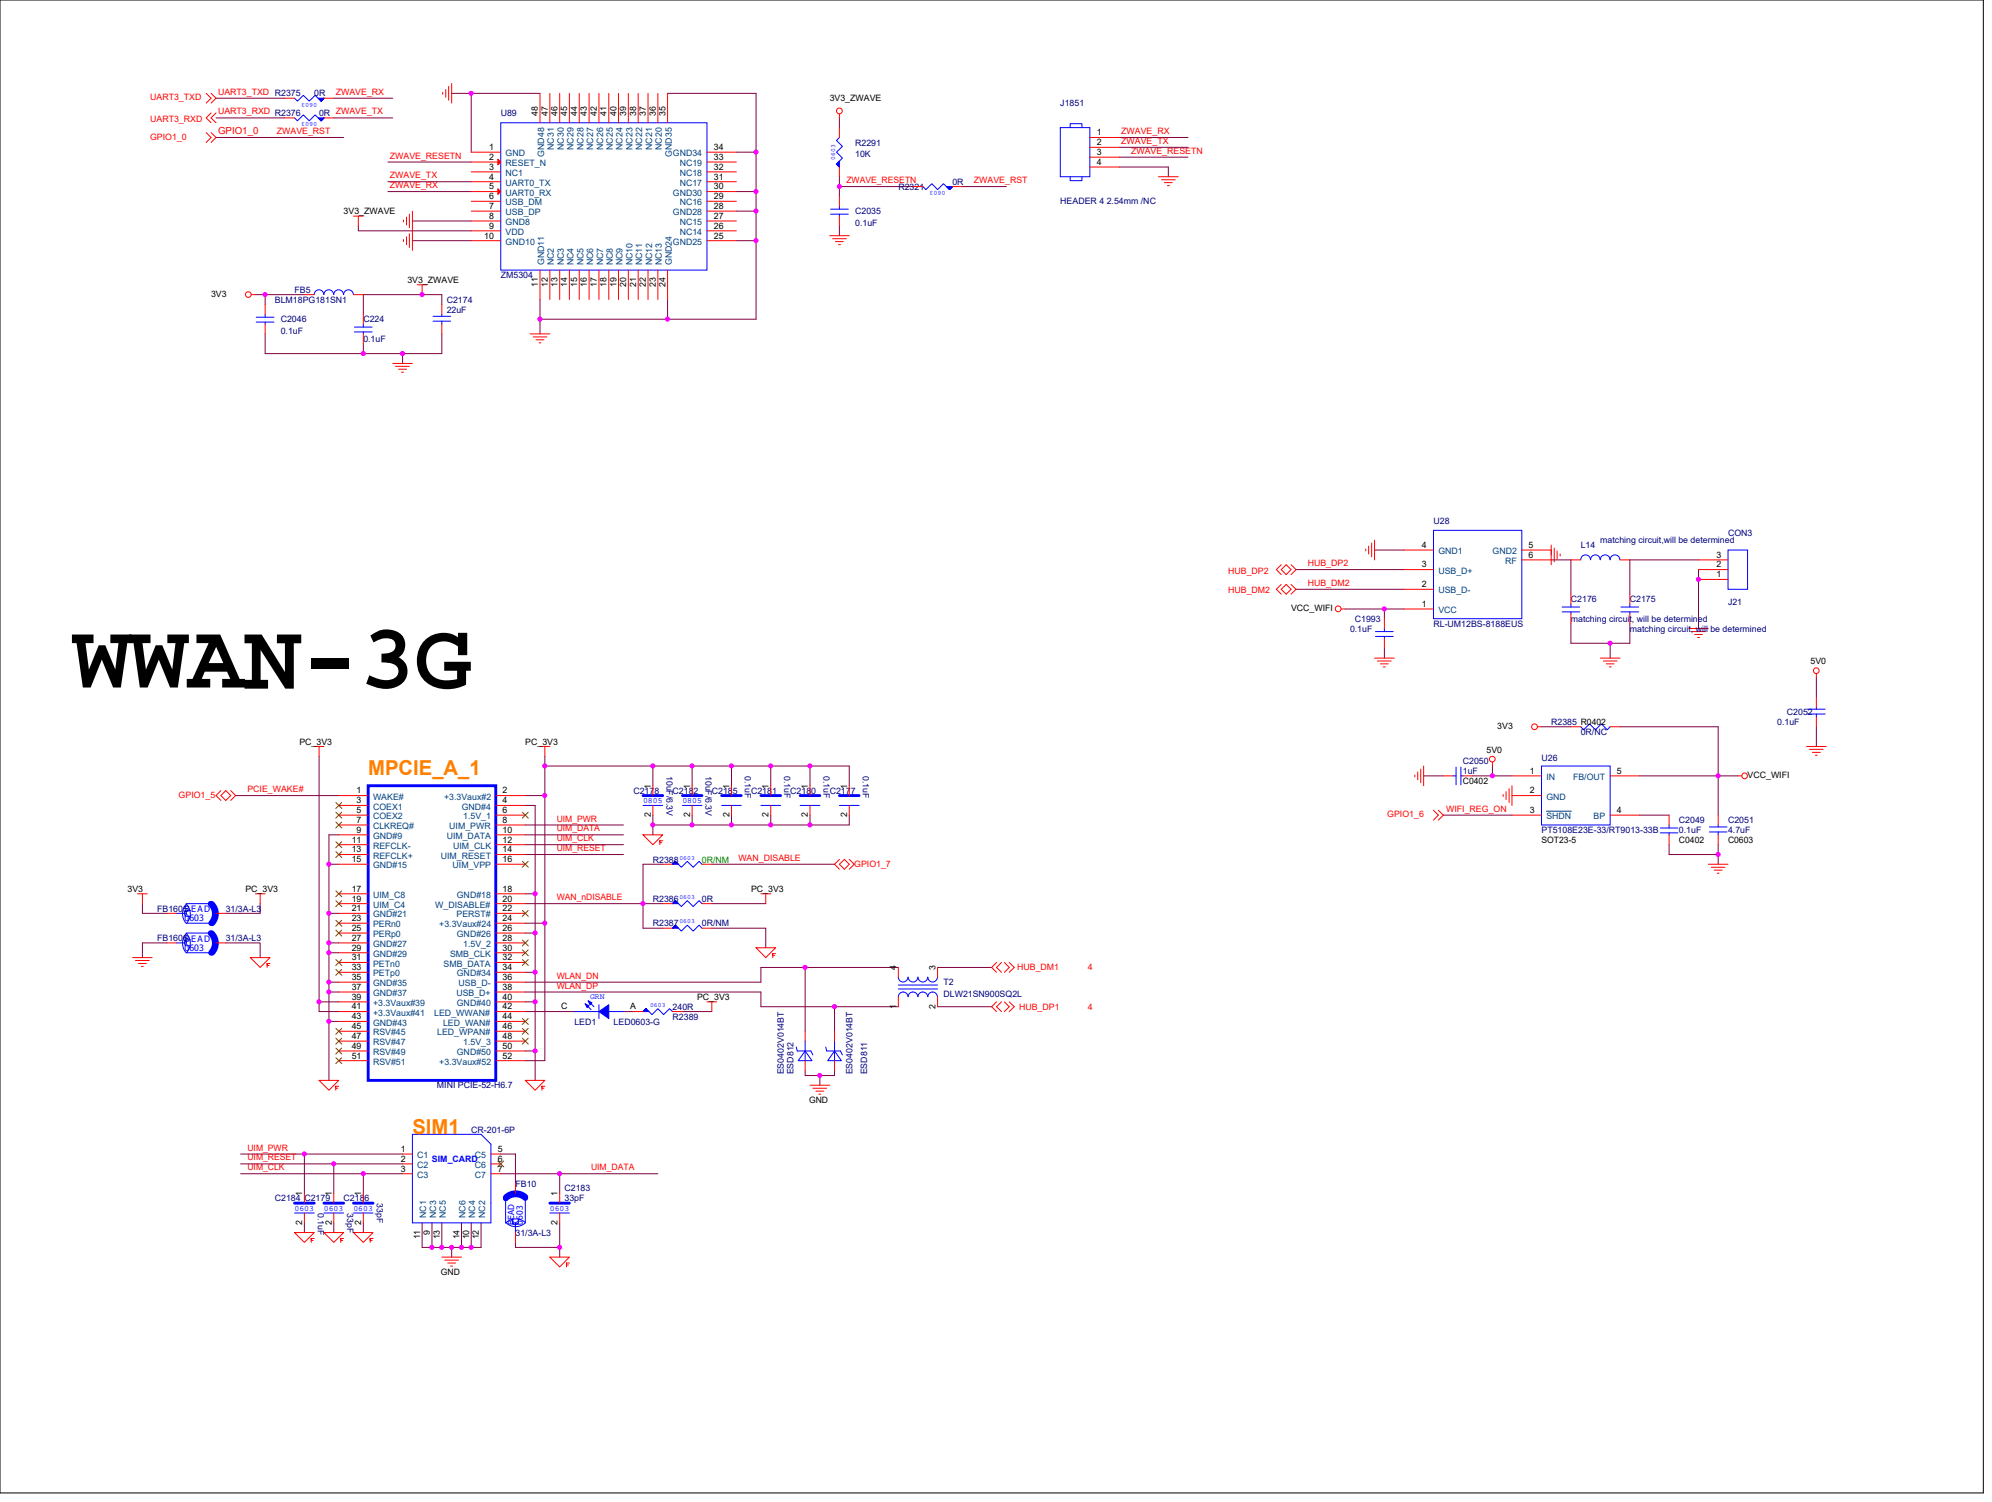
[picture p17: page 20]

L14 matching circuit,will be determined

matching circuit, will be determined
