m-soori/hi3535_nvr/1. Schematic/HI3535DMEB _ 04.pdf

# ETH0

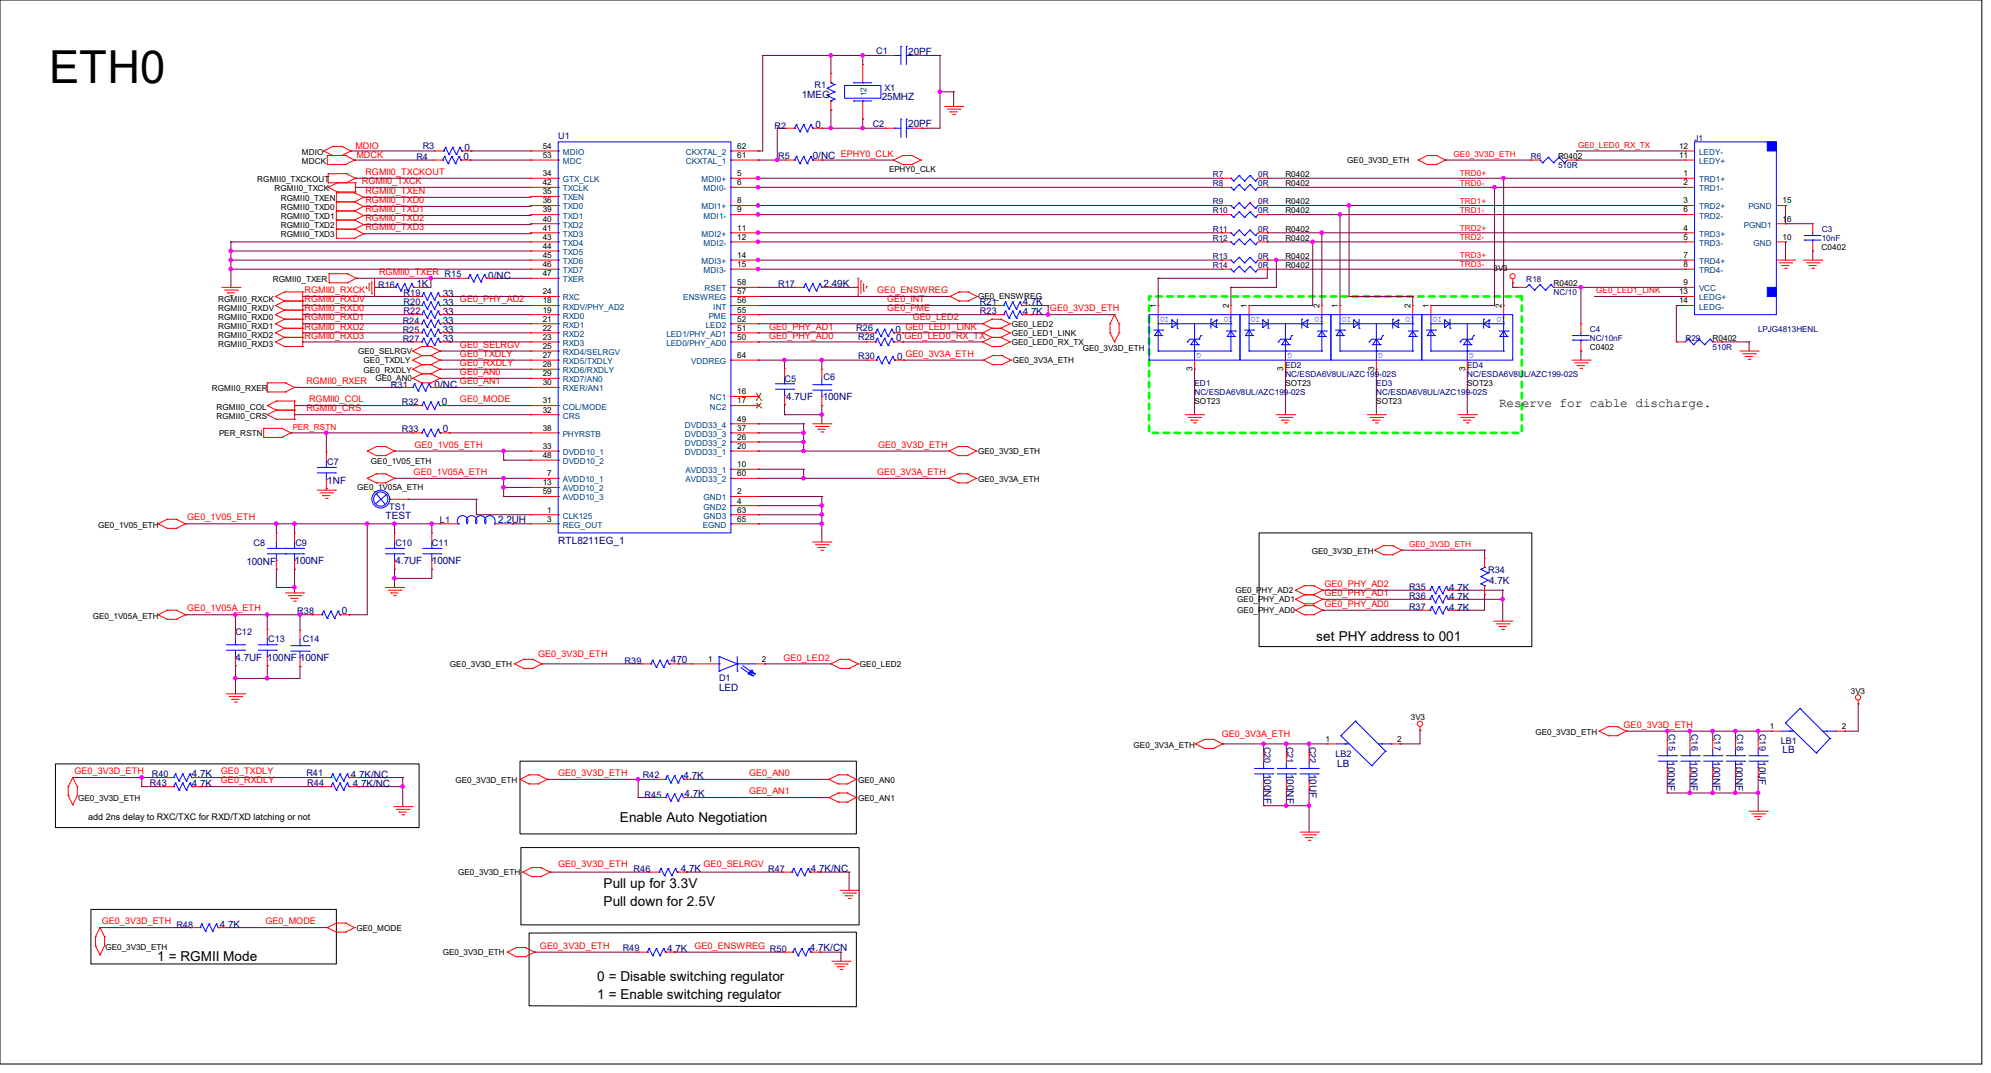
[picture p18: page 1]

TRD2-

TRD3+
TRD3- | 3V3

Reserve for cable discharge.

set PHY address to 001
