m-soori/hi3535_nvr/1. Schematic/HI3535DMEB _ 09.pdf

Put this cap close to the Hi3535.

# SYSTEM & FLASH

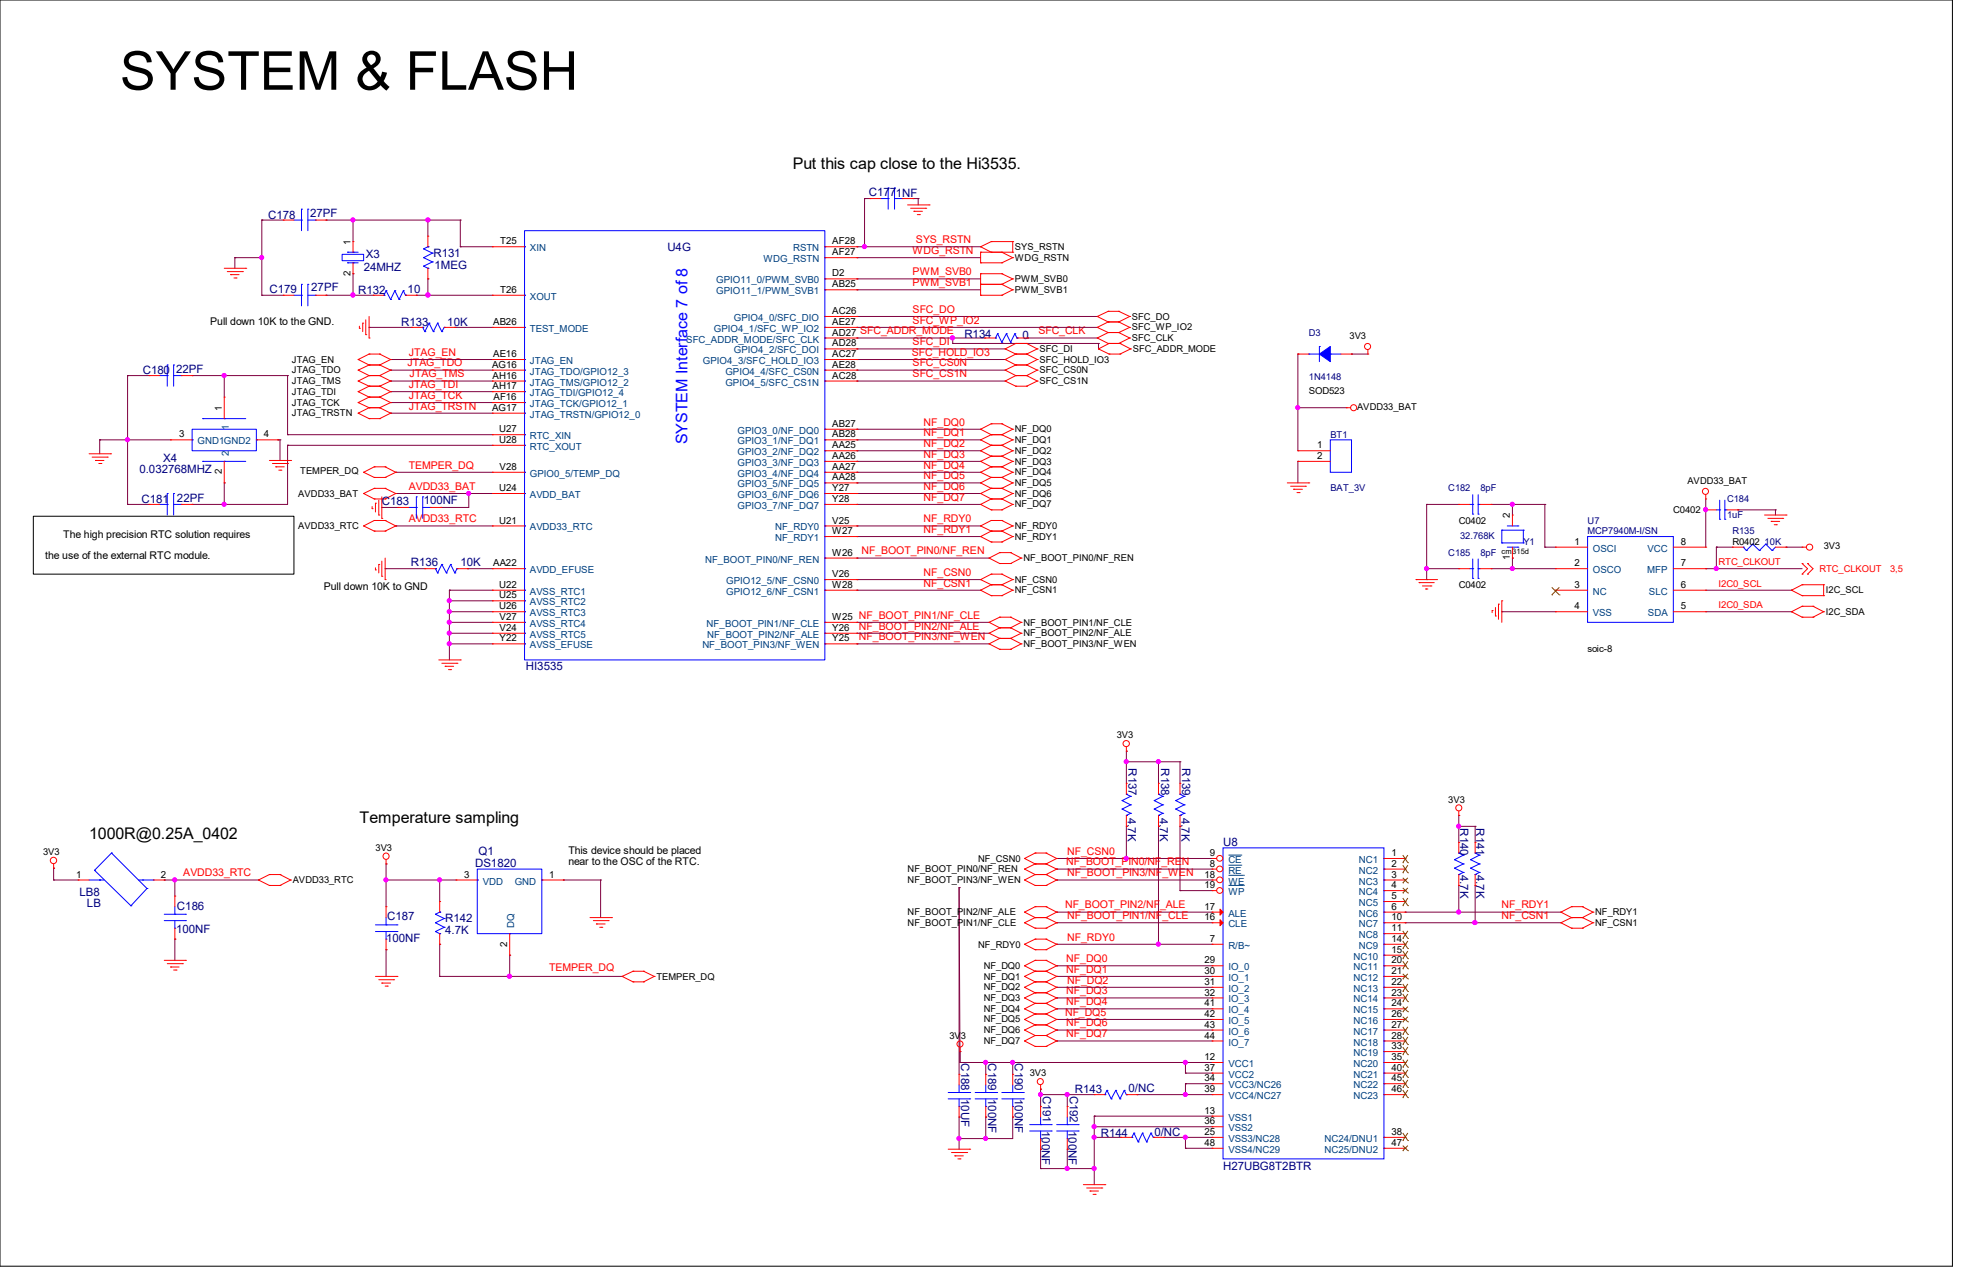
[picture p19: page 1]

Pull down 10K to the GND.

The high precision RTC solution requires

the use of the external RTC module.

Pull down 10K to GND

This device should be placed
near to the OSC of the RTC.
