m-soori/hi3535_nvr/1. Schematic/NEW.pdf

VO

## VOU1120_DATA9

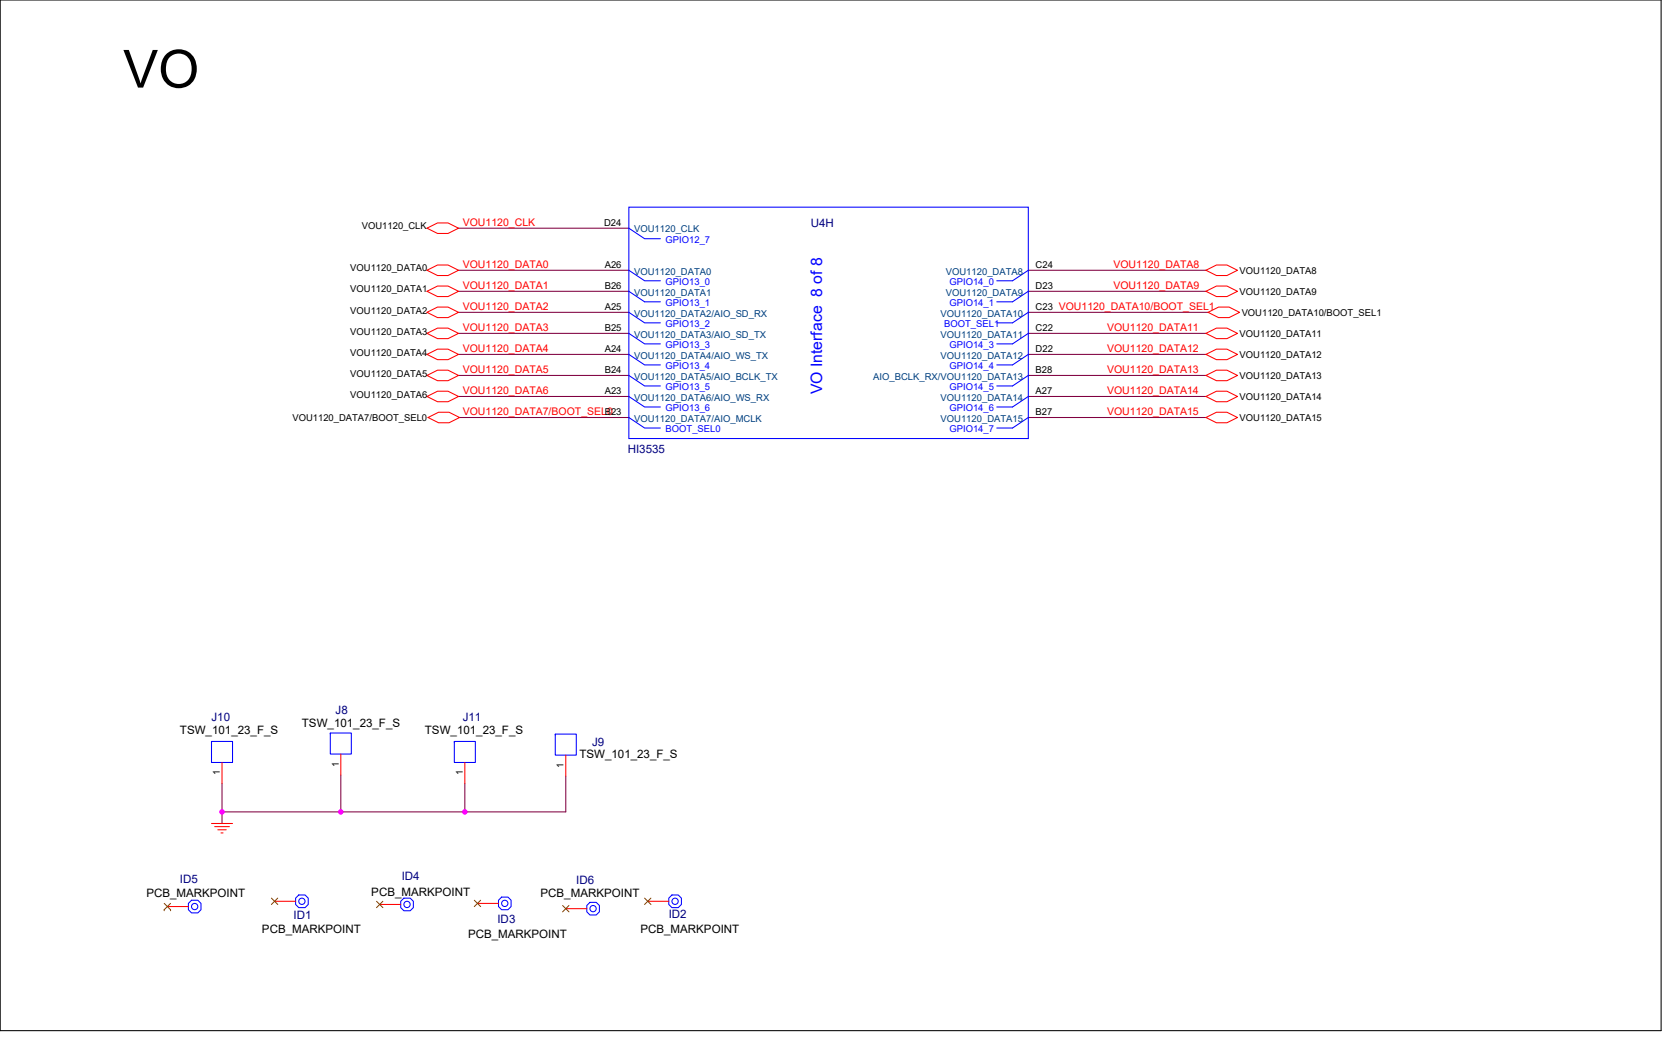
[picture p39: page 2]

The HDMI differential trace impedance is 100 OHM. HDMI The HDMI trace length is less than 5 inch.

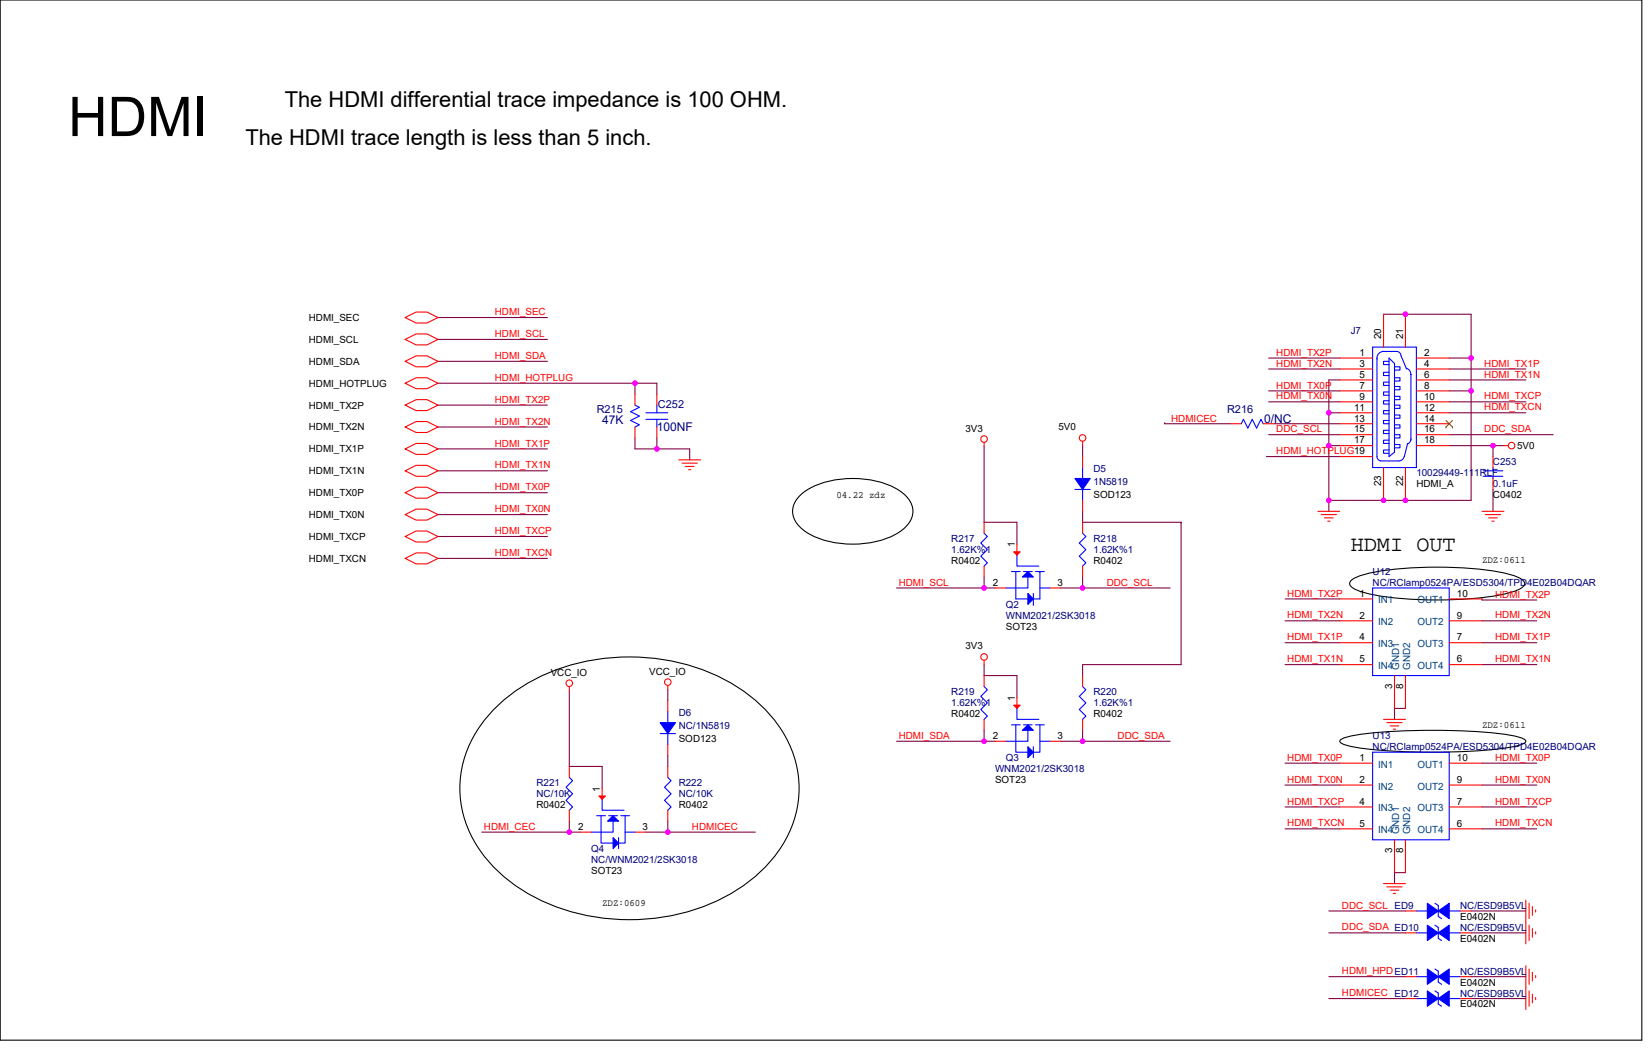
[picture p40: page 3]

# DISPLAY

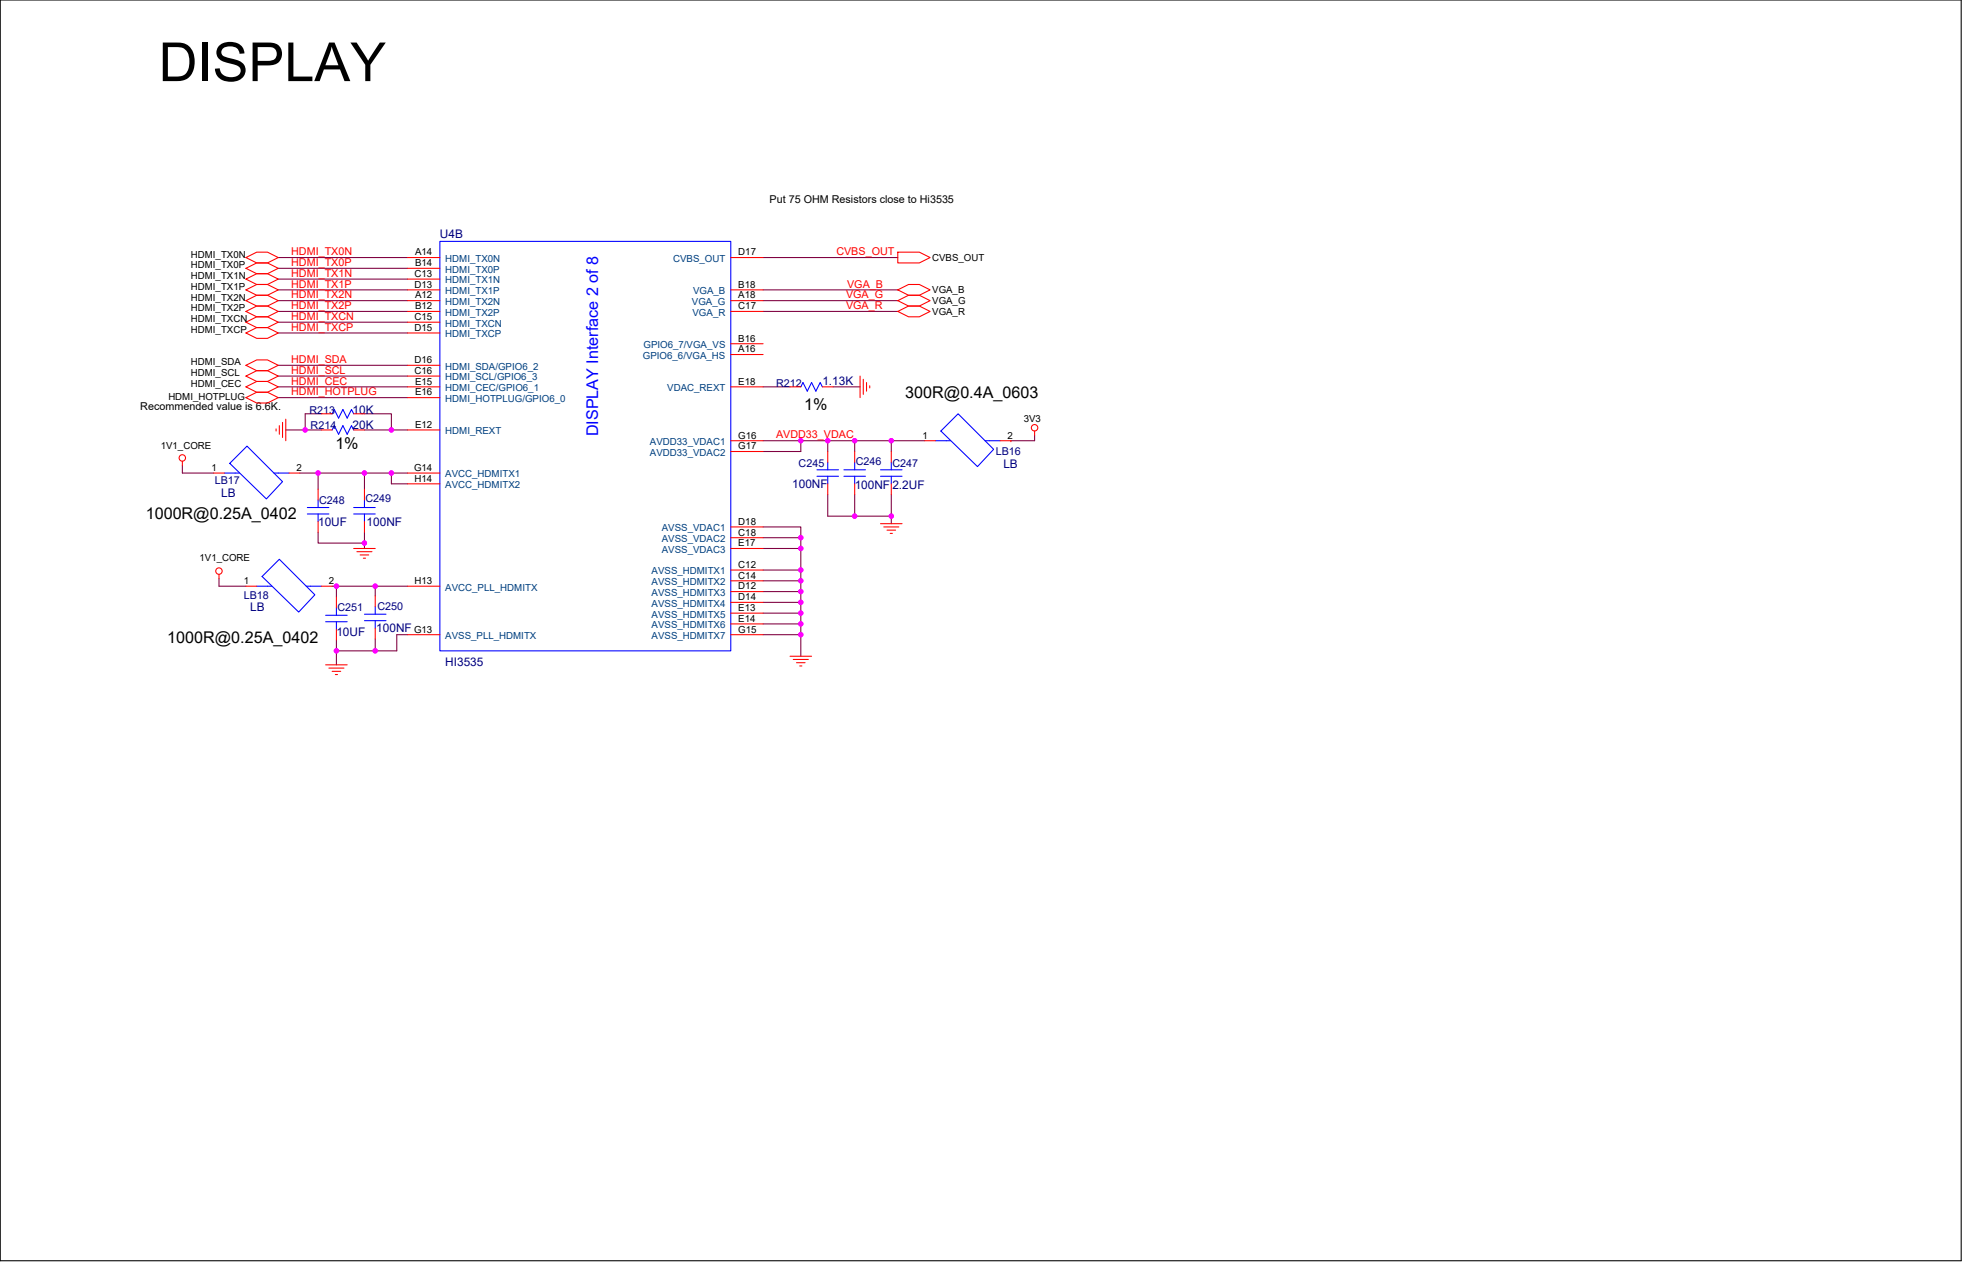
[picture p41: page 4]

Put 75 OHM Resistors close to Hi3535

The SATA trace length is less than 5 inch. The USB trace length is less than 5 inch.

The SATA differential trace impedance is 100 OHM. The USB differential trace impedance is 90 OHM.

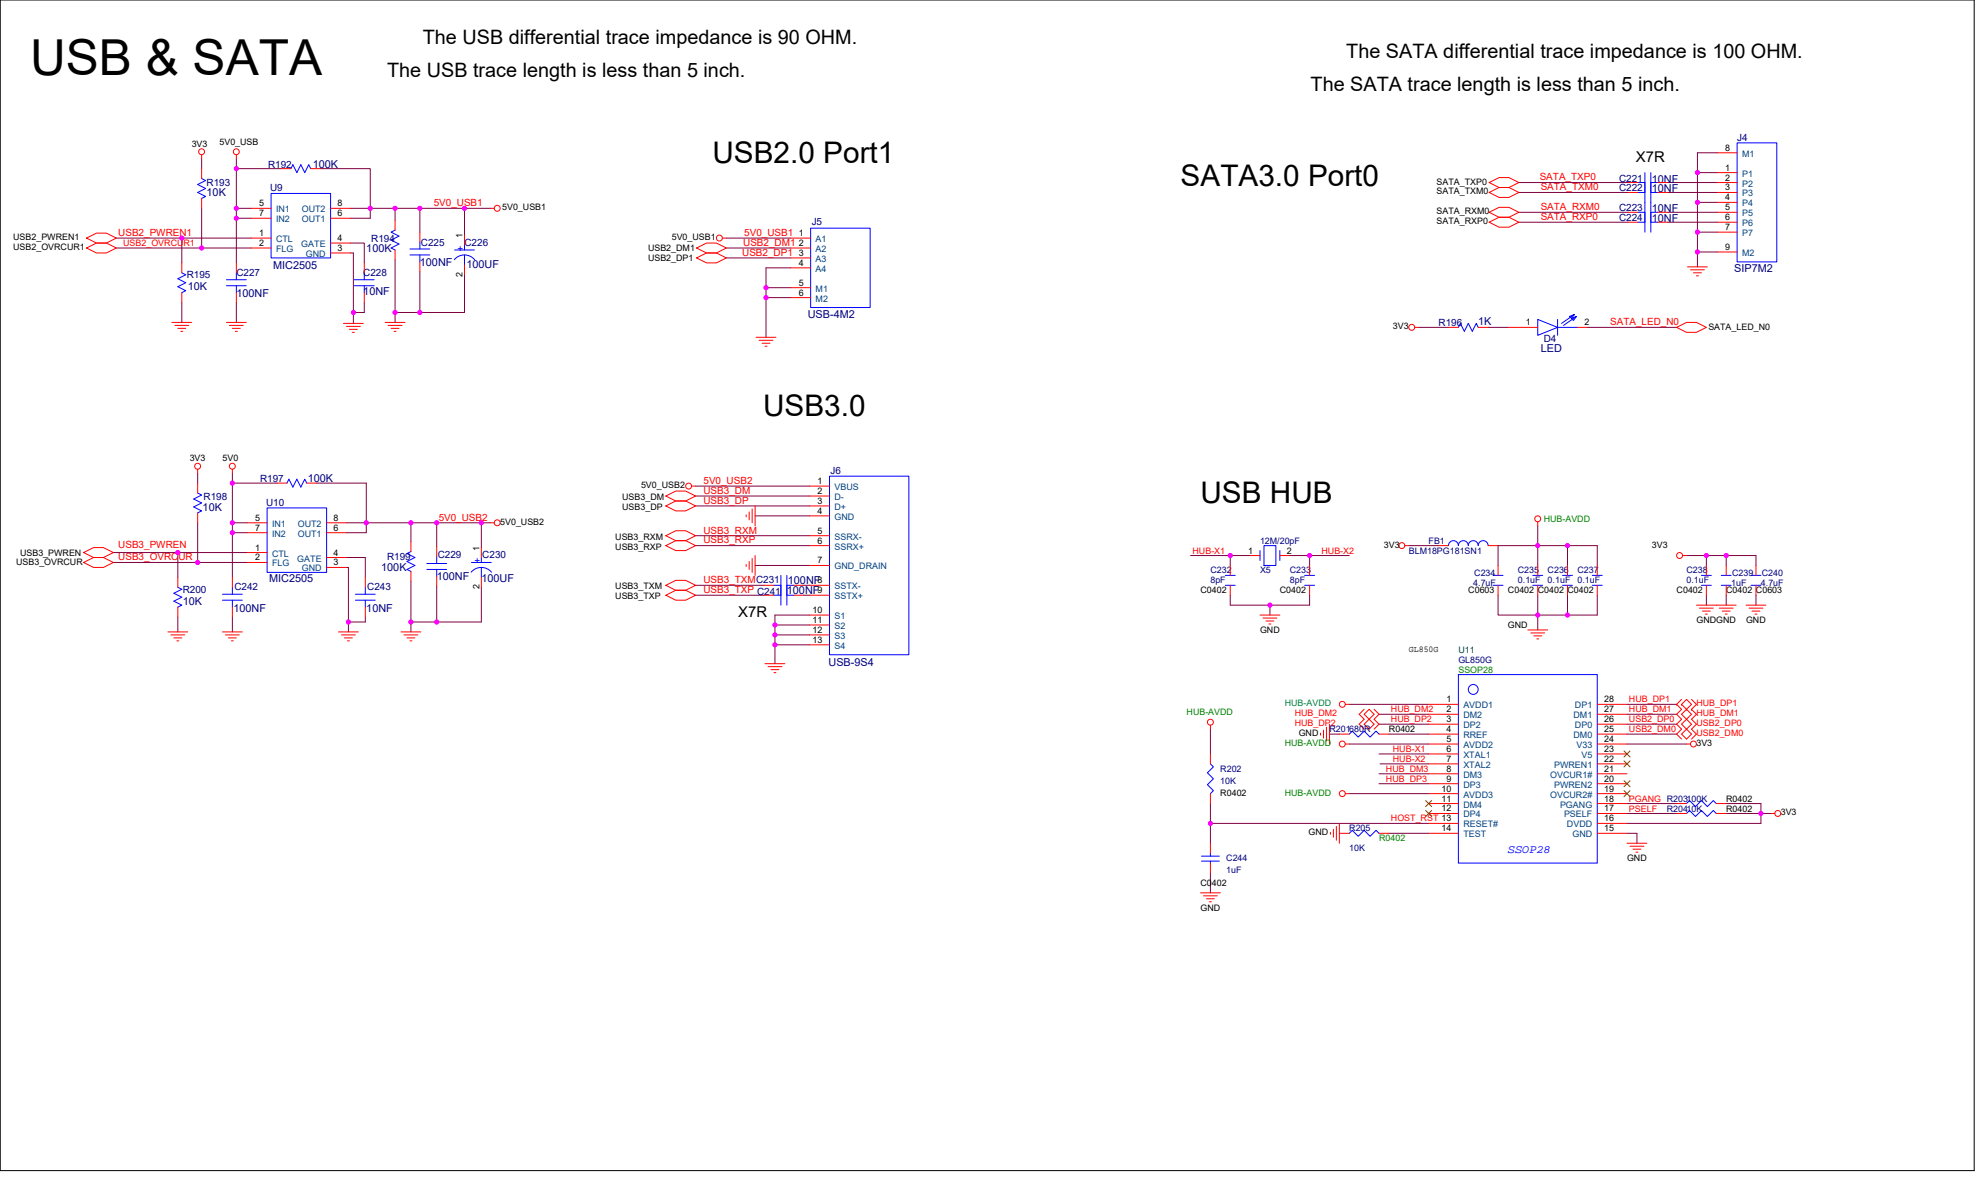
[picture p42: page 5]

# Interface

1%

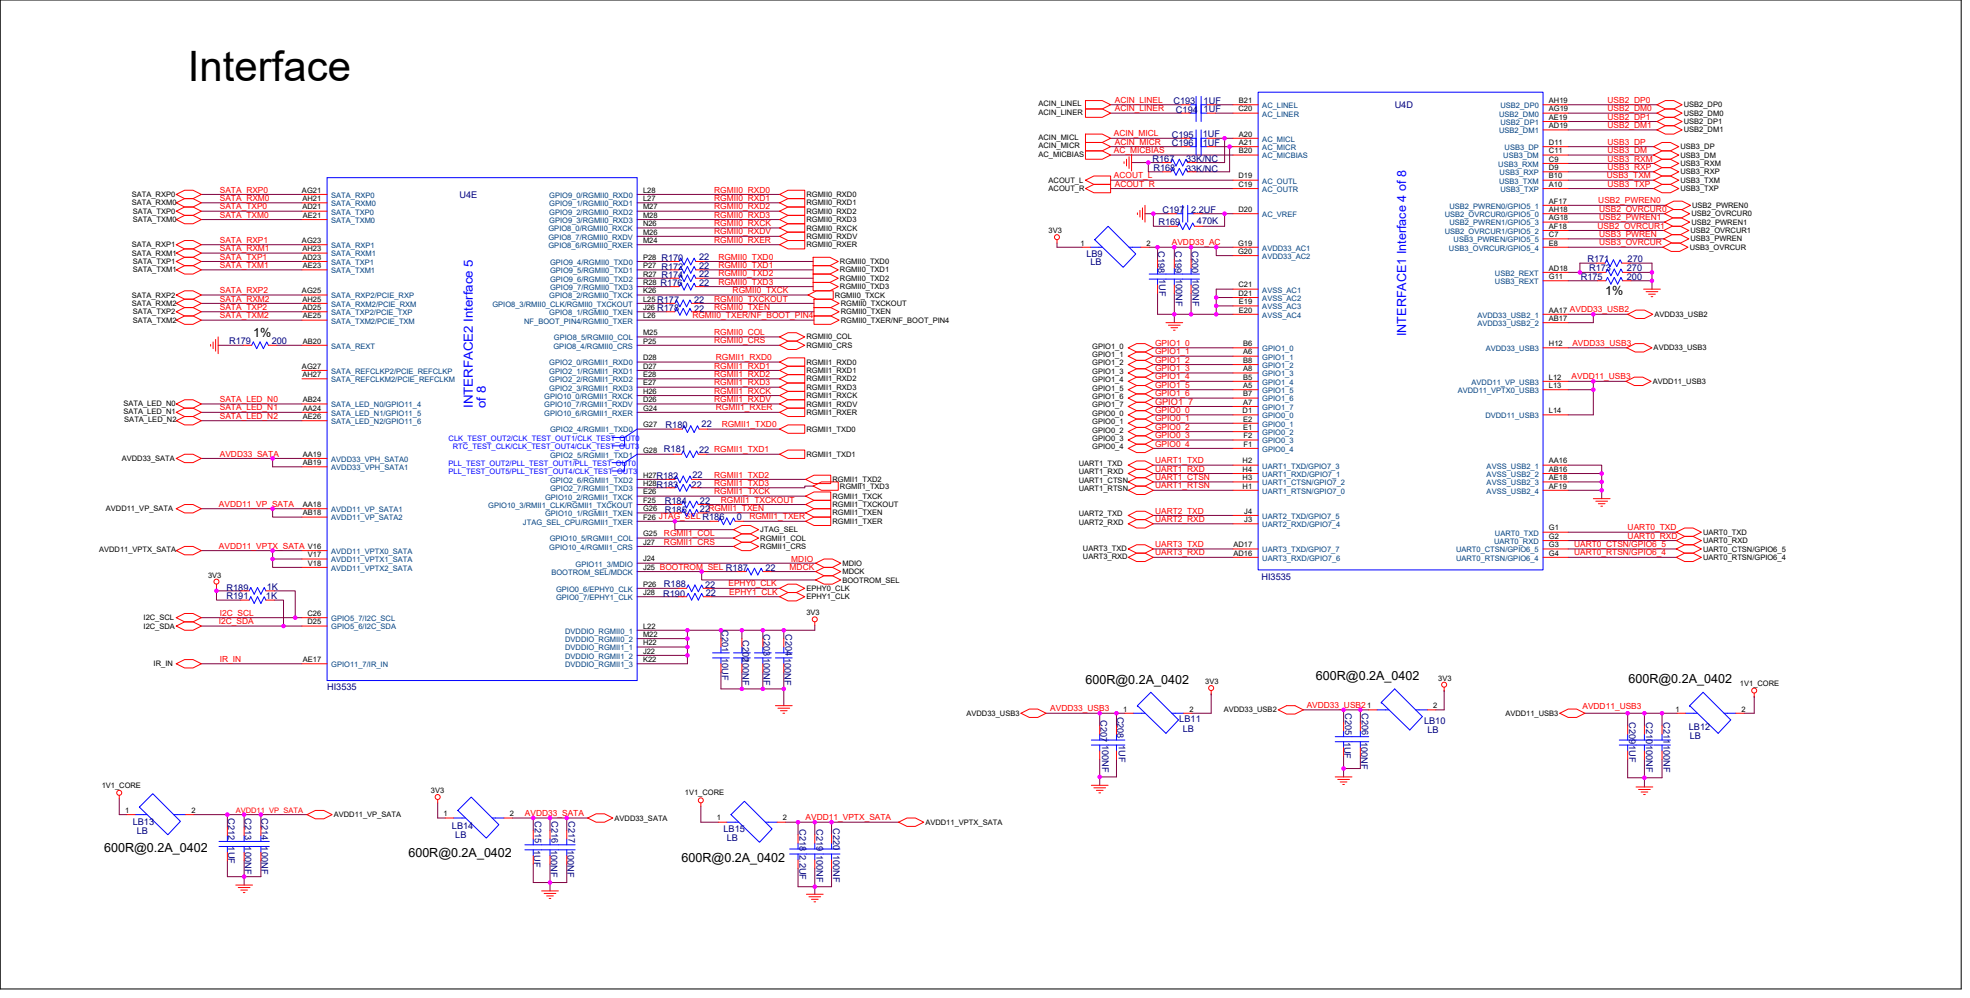
[picture p43: page 6]

# 00100 4k page size,24bit ecc,256page/block,5addr 00101 2k page size,24bit ecc,64page/block,5addr

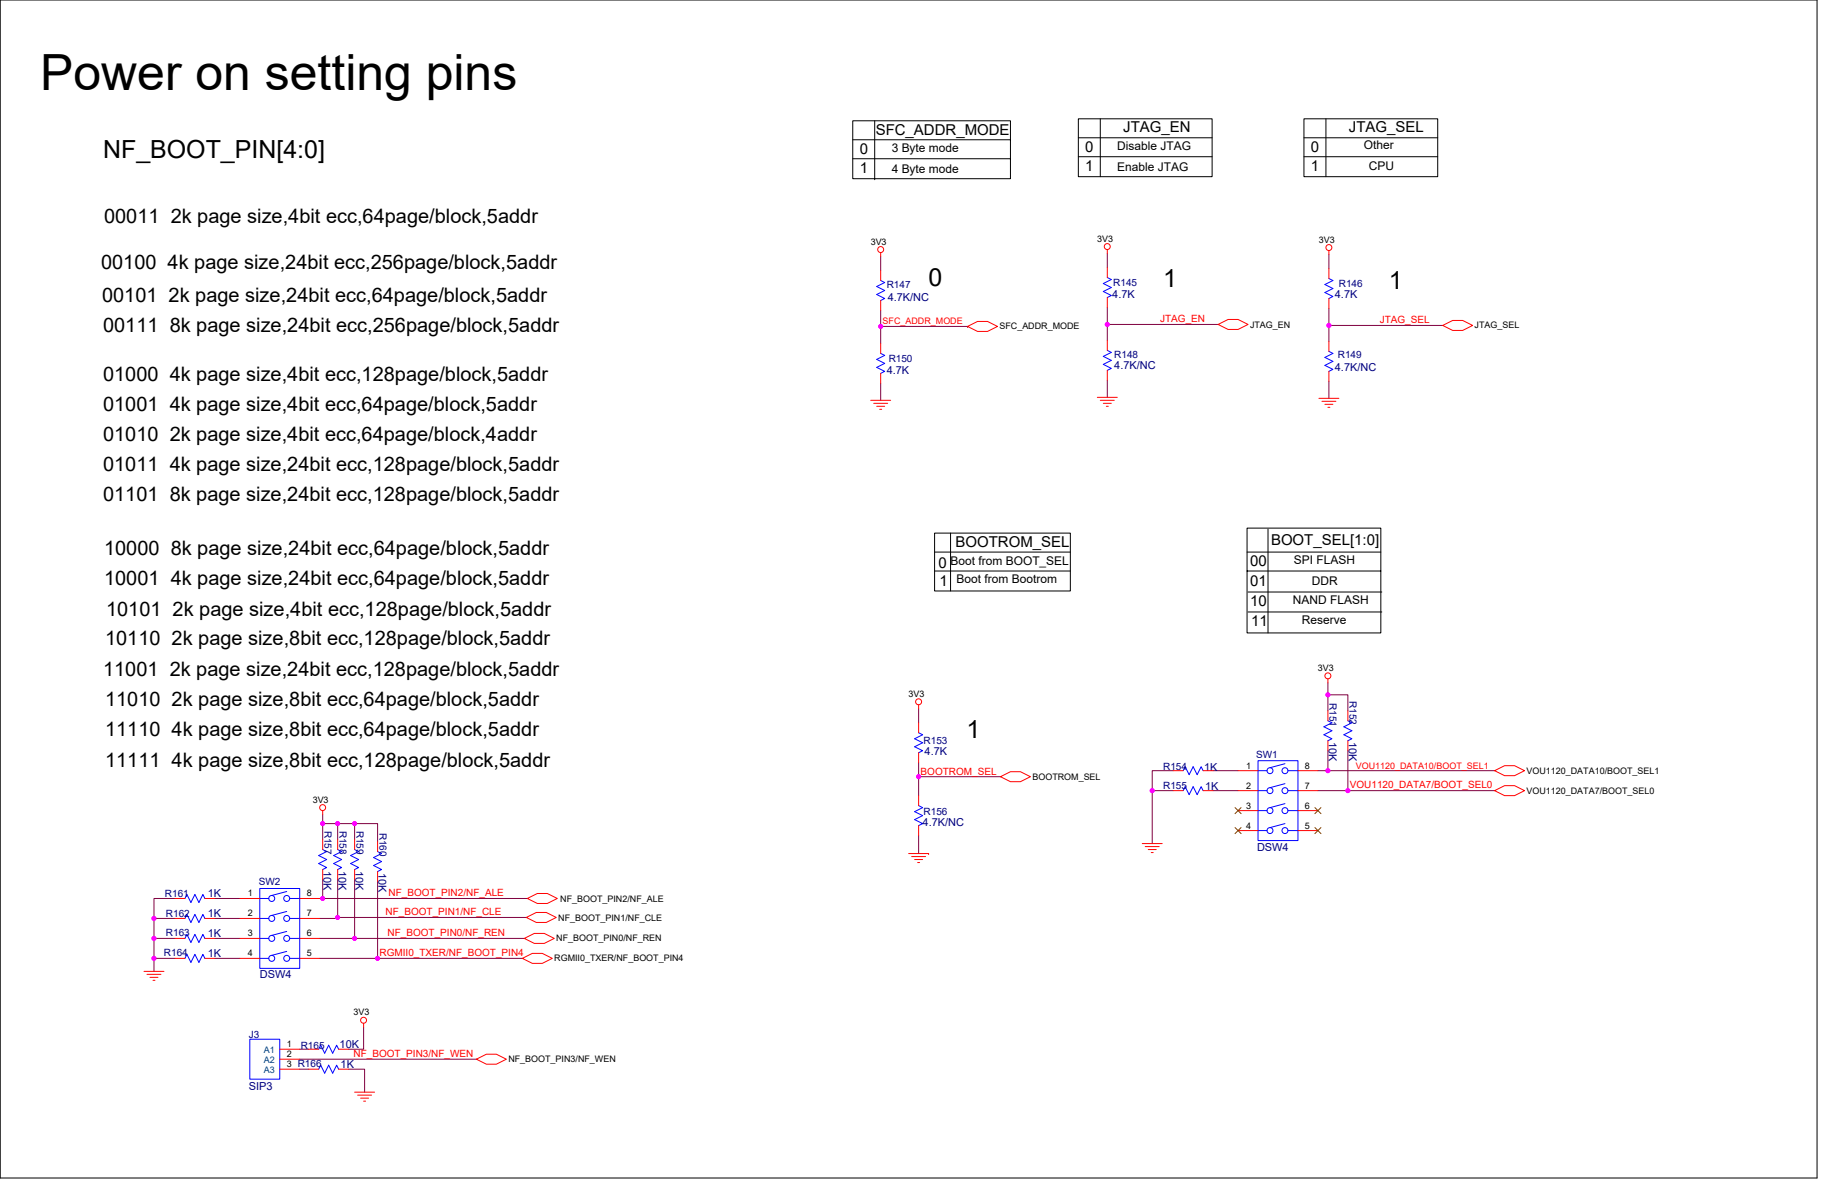
[picture p44: page 7]

Power on setting pins

00011 2k page size,4bit ecc,64page/block,5addr

00111 8k page size,24bit ecc,256page/block,5addr

01000 4k page size,4bit ecc,128page/block,5addr
01001 4k page size,4bit ecc,64page/block,5addr
01010 2k page size,4bit ecc,64page/block,4addr
01011 4k page size,24bit ecc,128page/block,5addr
01101 8k page size,24bit ecc,128page/block,5addr

10000 8k page size,24bit ecc,64page/block,5addr
10001 4k page size,24bit ecc,64page/block,5addr
10101 2k page size,4bit ecc,128page/block,5addr
10110 2k page size,8bit ecc,128page/block,5addr
11001 2k page size,24bit ecc,128page/block,5addr
11010 2k page size,8bit ecc,64page/block,5addr
11110 4k page size,8bit ecc,64page/block,5addr
11111 4k page size,8bit ecc,128page/block,5addr

10 | NAND FLASH
11 | Reserve

Put this cap close to the Hi3535.

# SYSTEM & FLASH

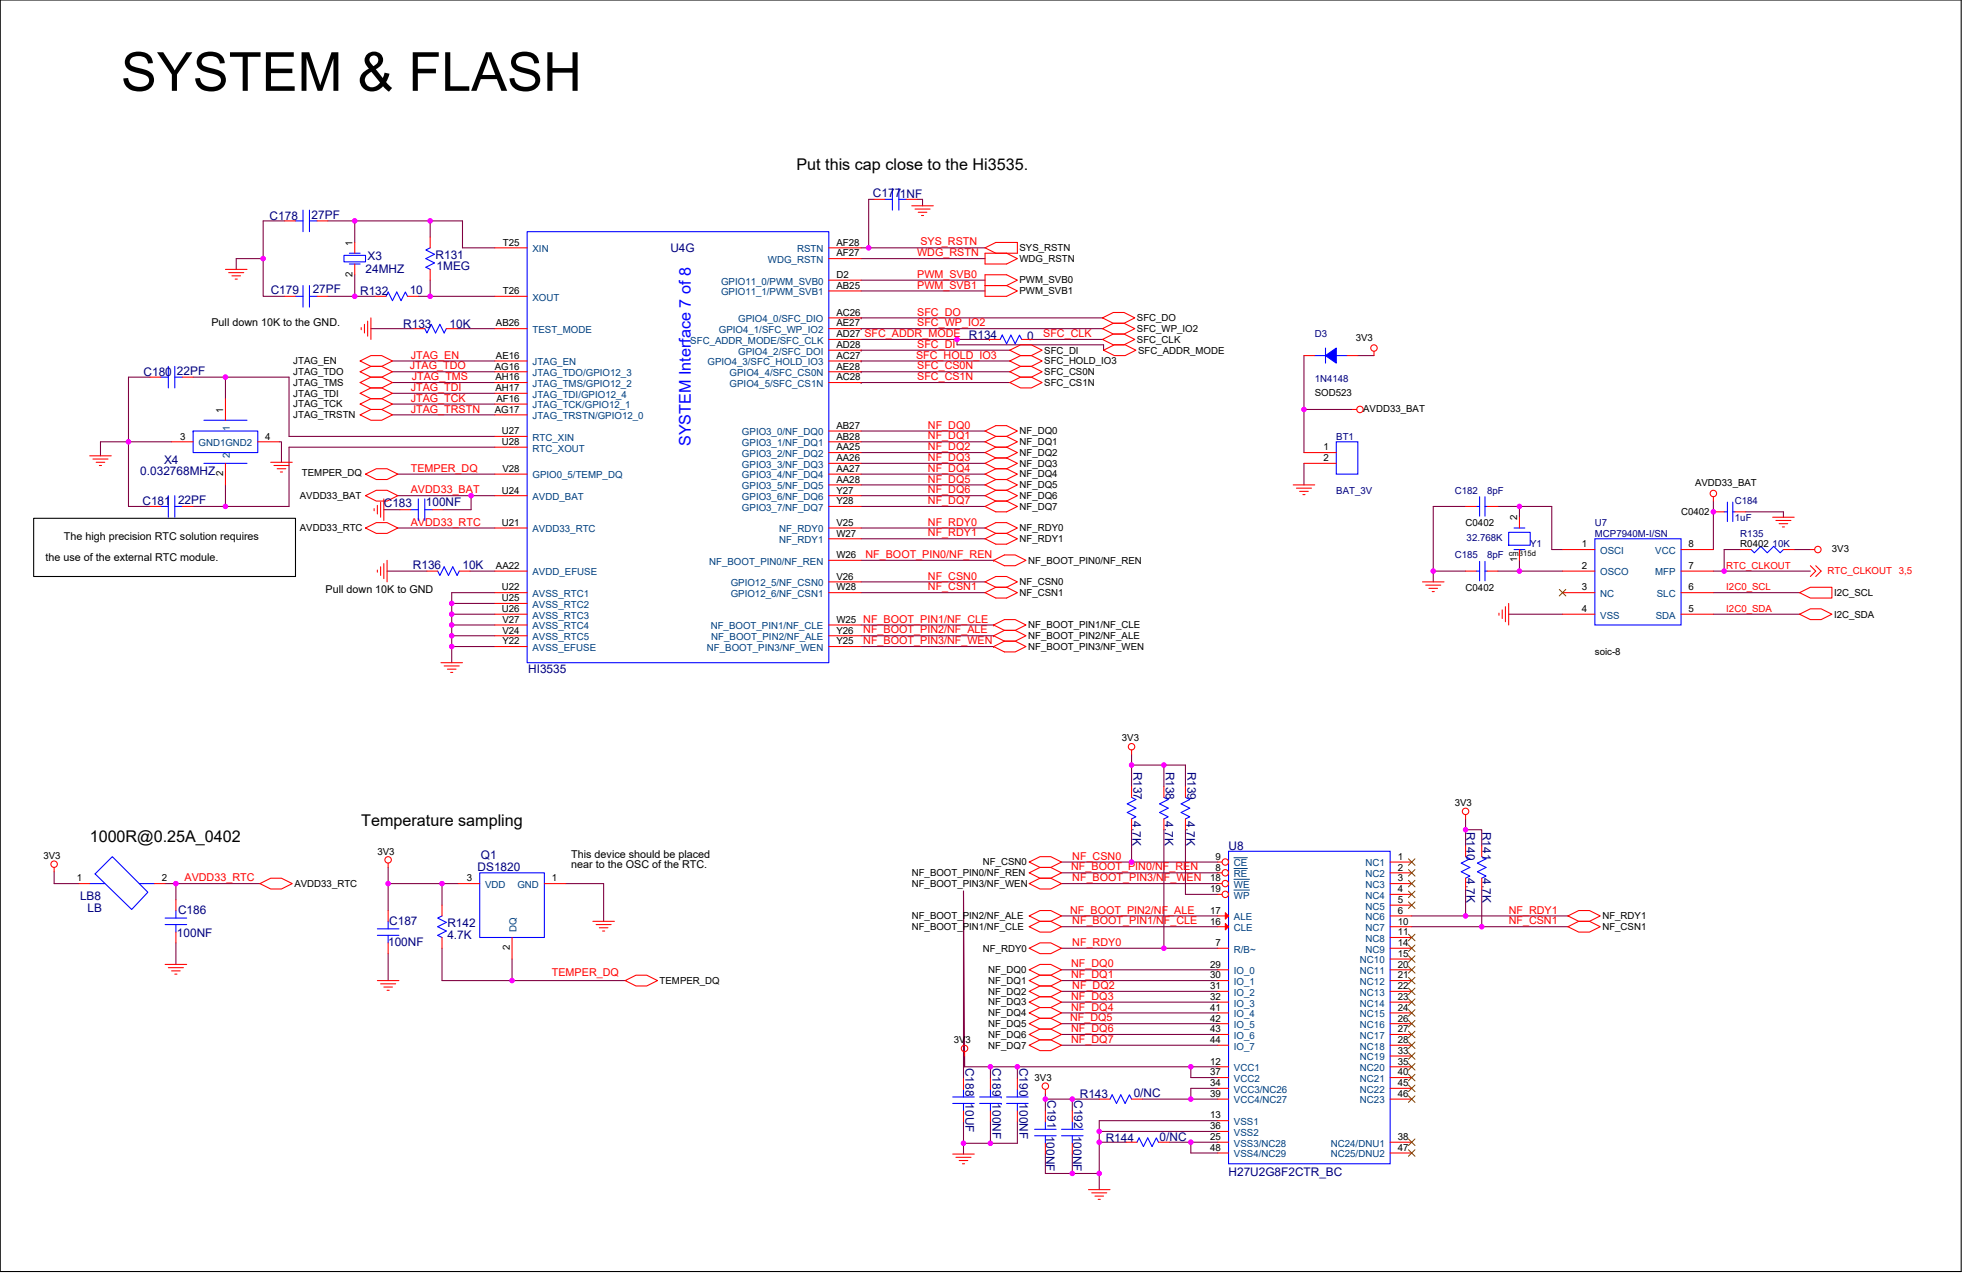
[picture p45: page 8]

Pull down 10K to the GND.

TEMPER_DQ AVDD33_BAT | GPIO0_5/TEMP_DQ V28 AVDD_BAT U24 AVDD33_RTC U21 AVDD_EFUSE AA22 | NF_DQ2

The high precision RTC solution requires
the use of the external RTC module.

Pull down 10K to GND

This device should be placed
near to the OSC of the RTC.

# DDR3_B

the same as that for the Hi3535 demo board.

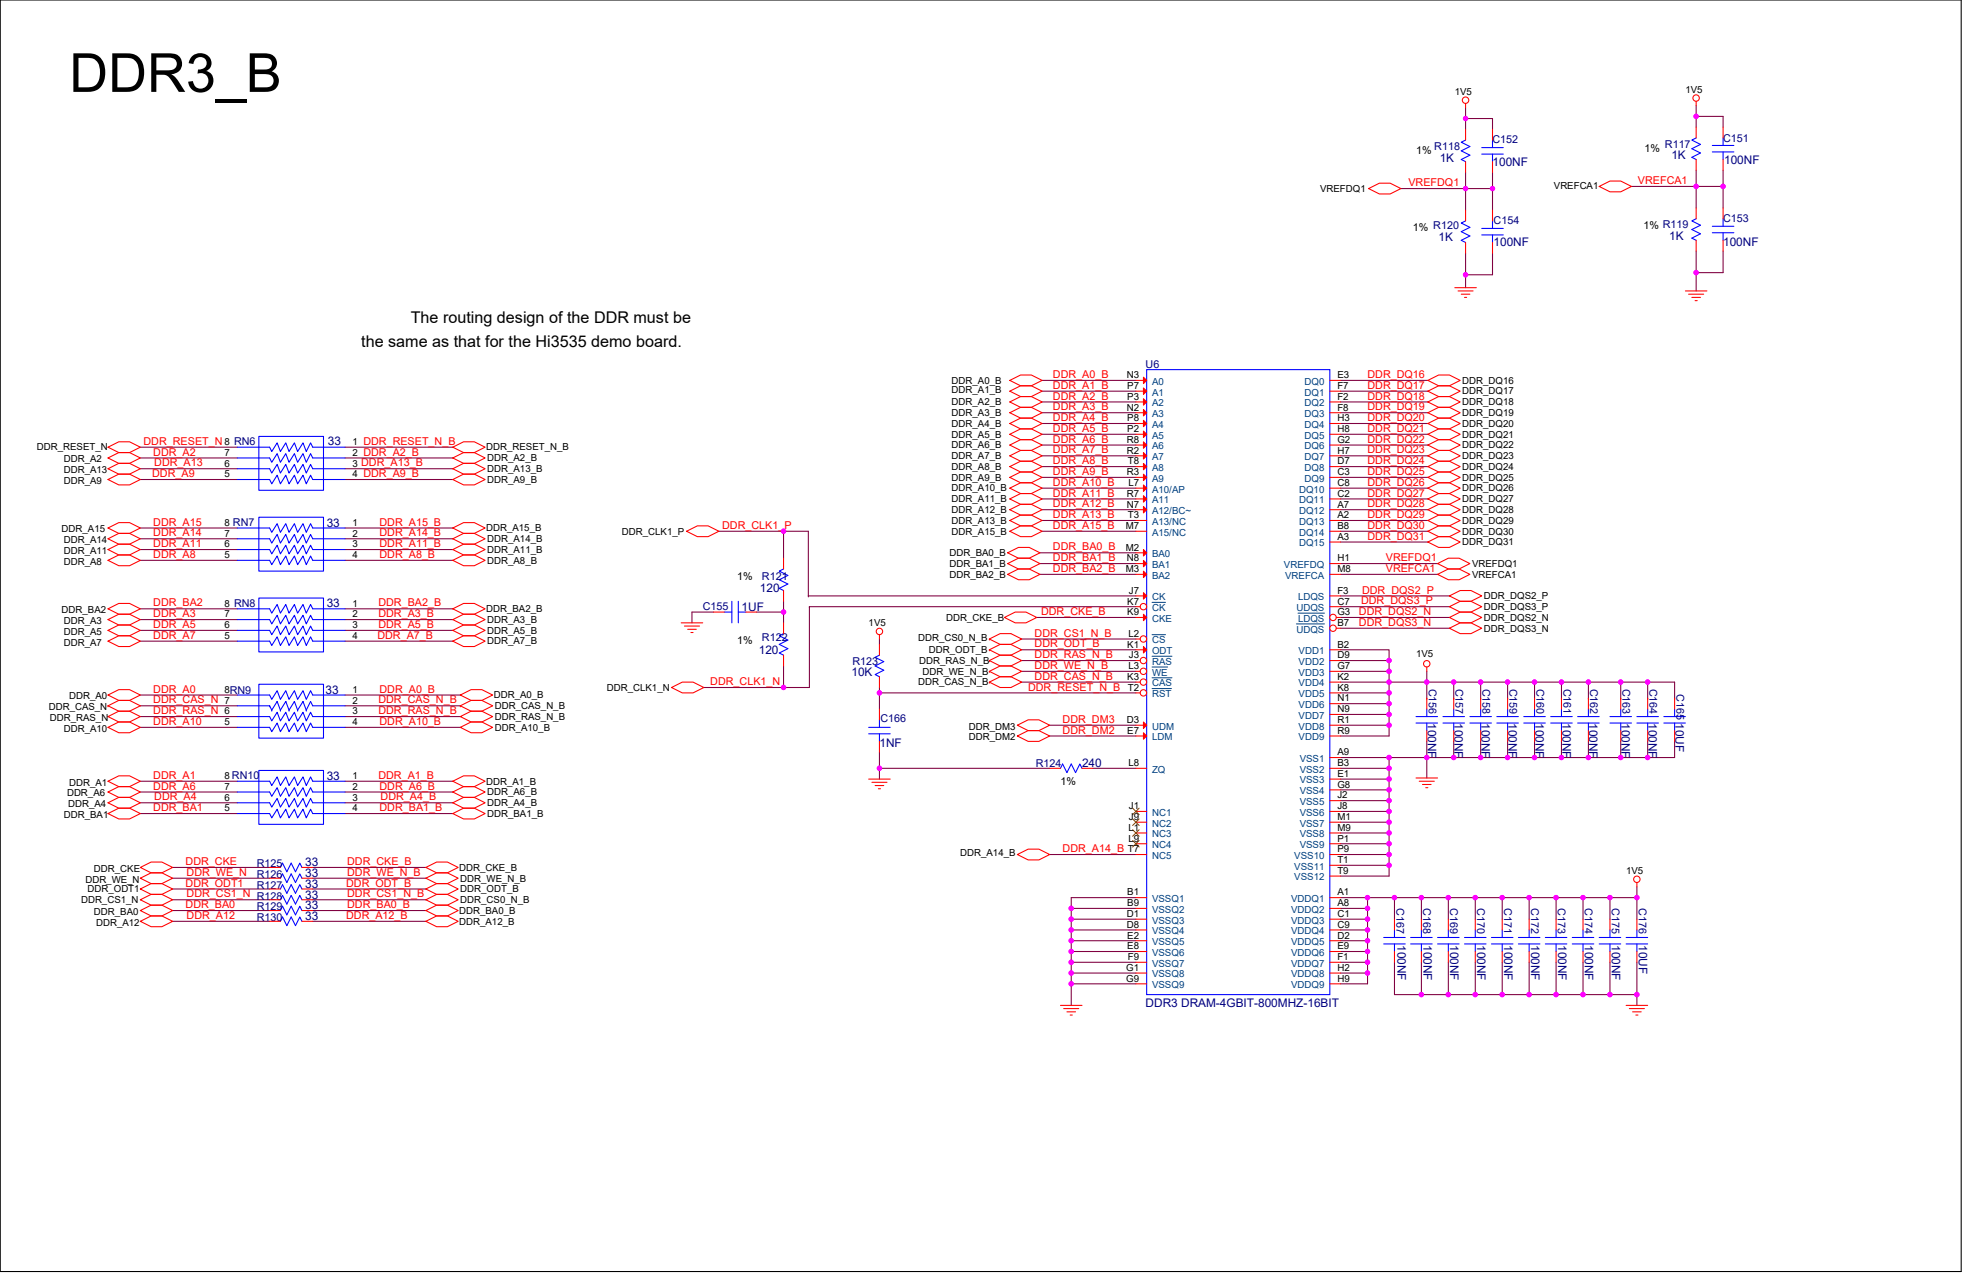
[picture p46: page 9]

The routing design of the DDR must be

1%

the same as that for the Hi3535 demo board.

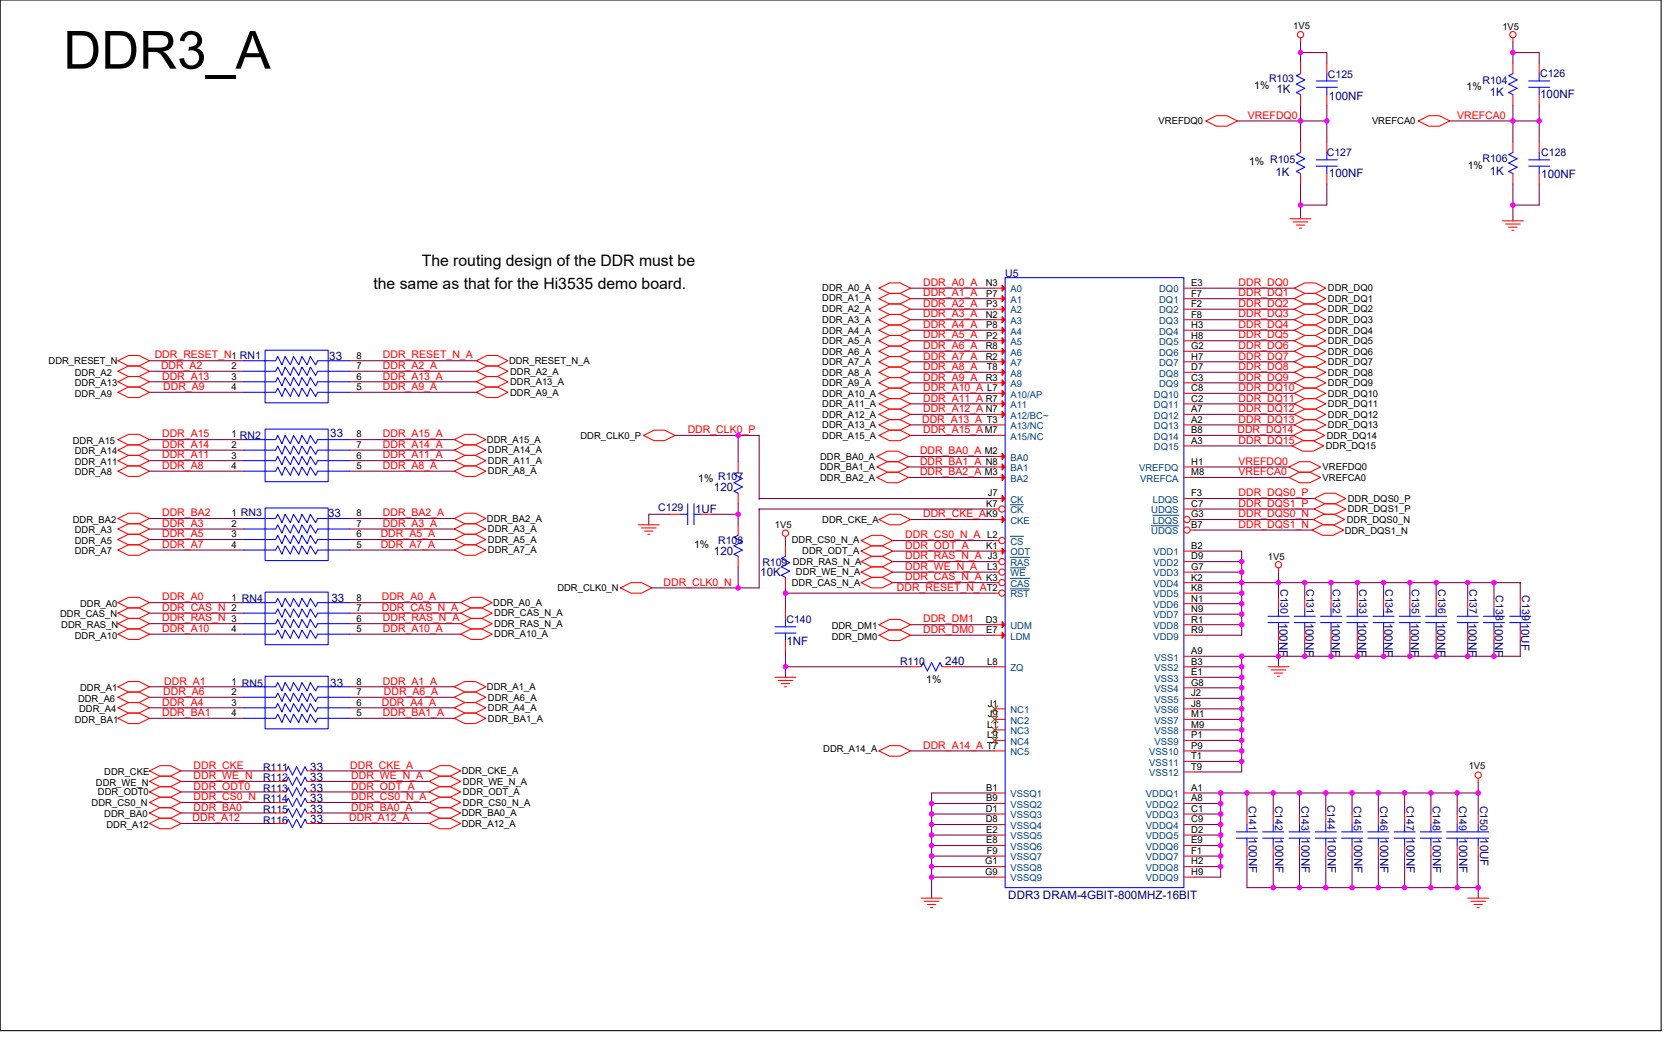
[picture p47: page 10]

The routing design of the DDR must be

# HI3535 DDR3

the same as that for the Hi3535 demo board.

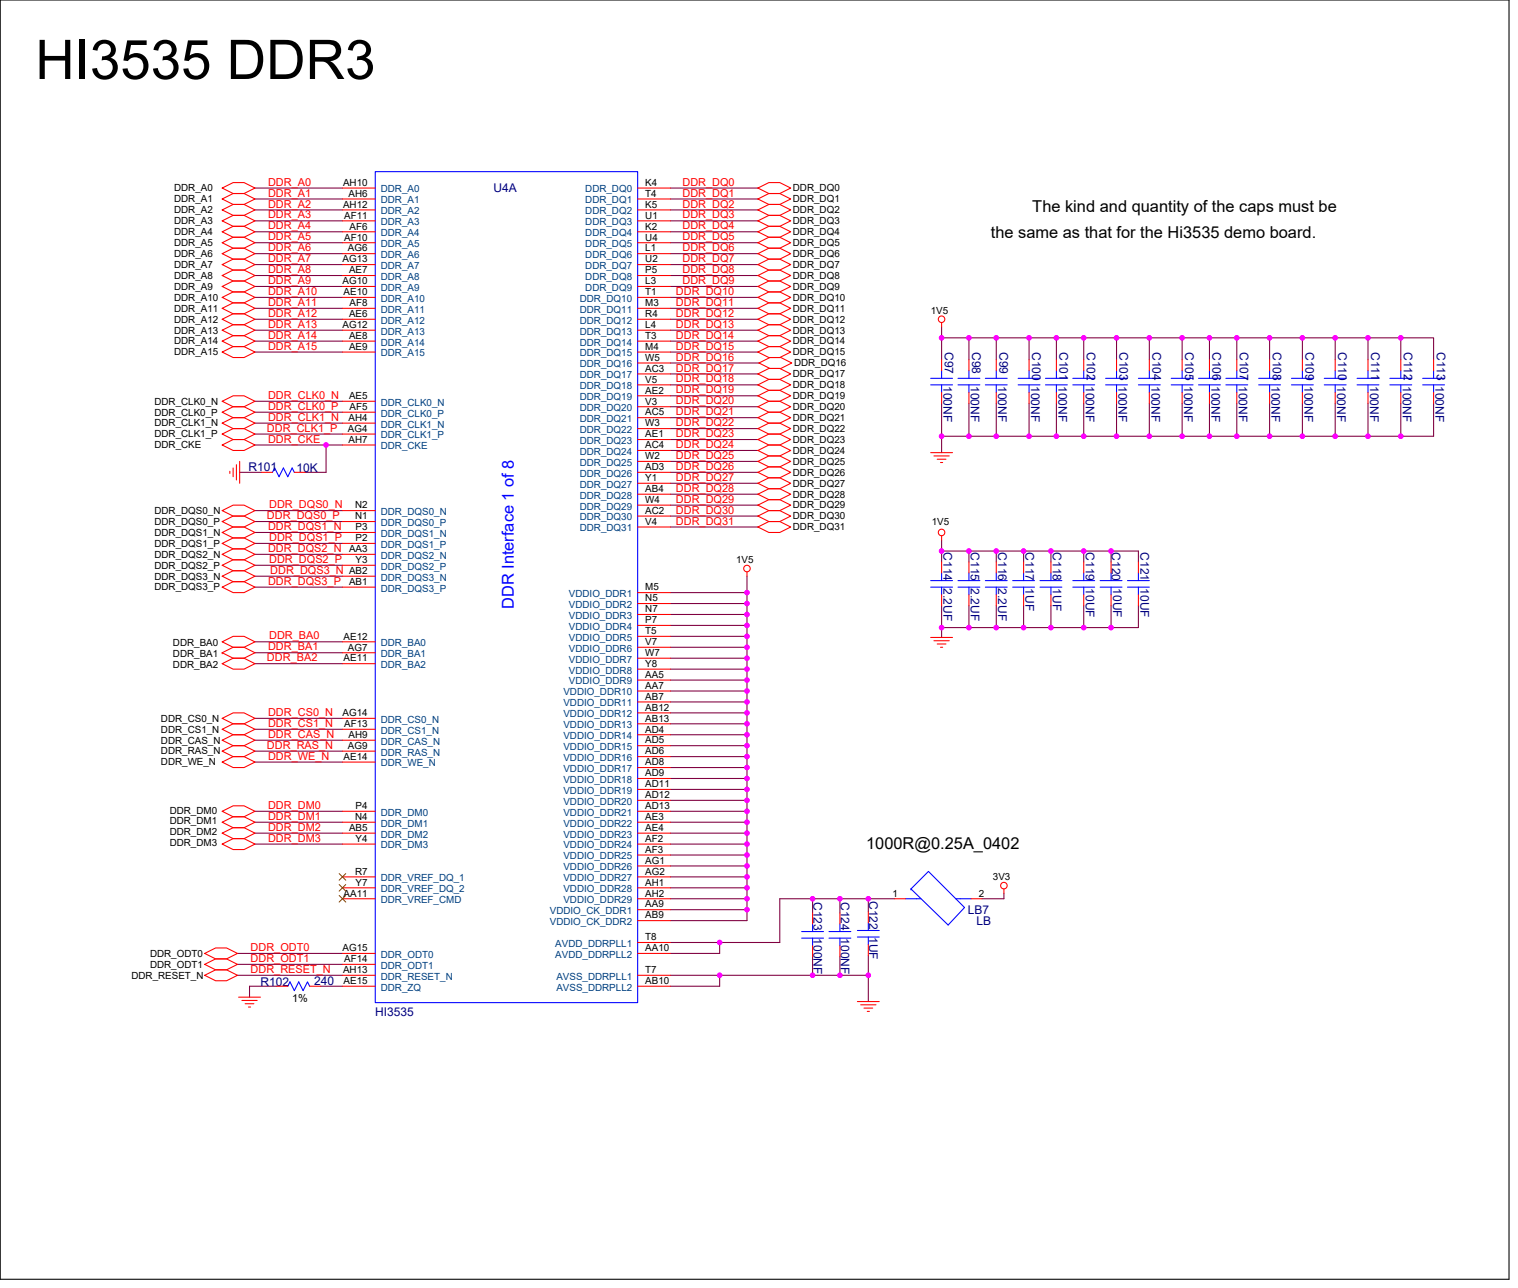
[picture p48: page 11]

The kind and quantity of the caps must be

# POWER & VSS

## 1000R@0.25A_0402

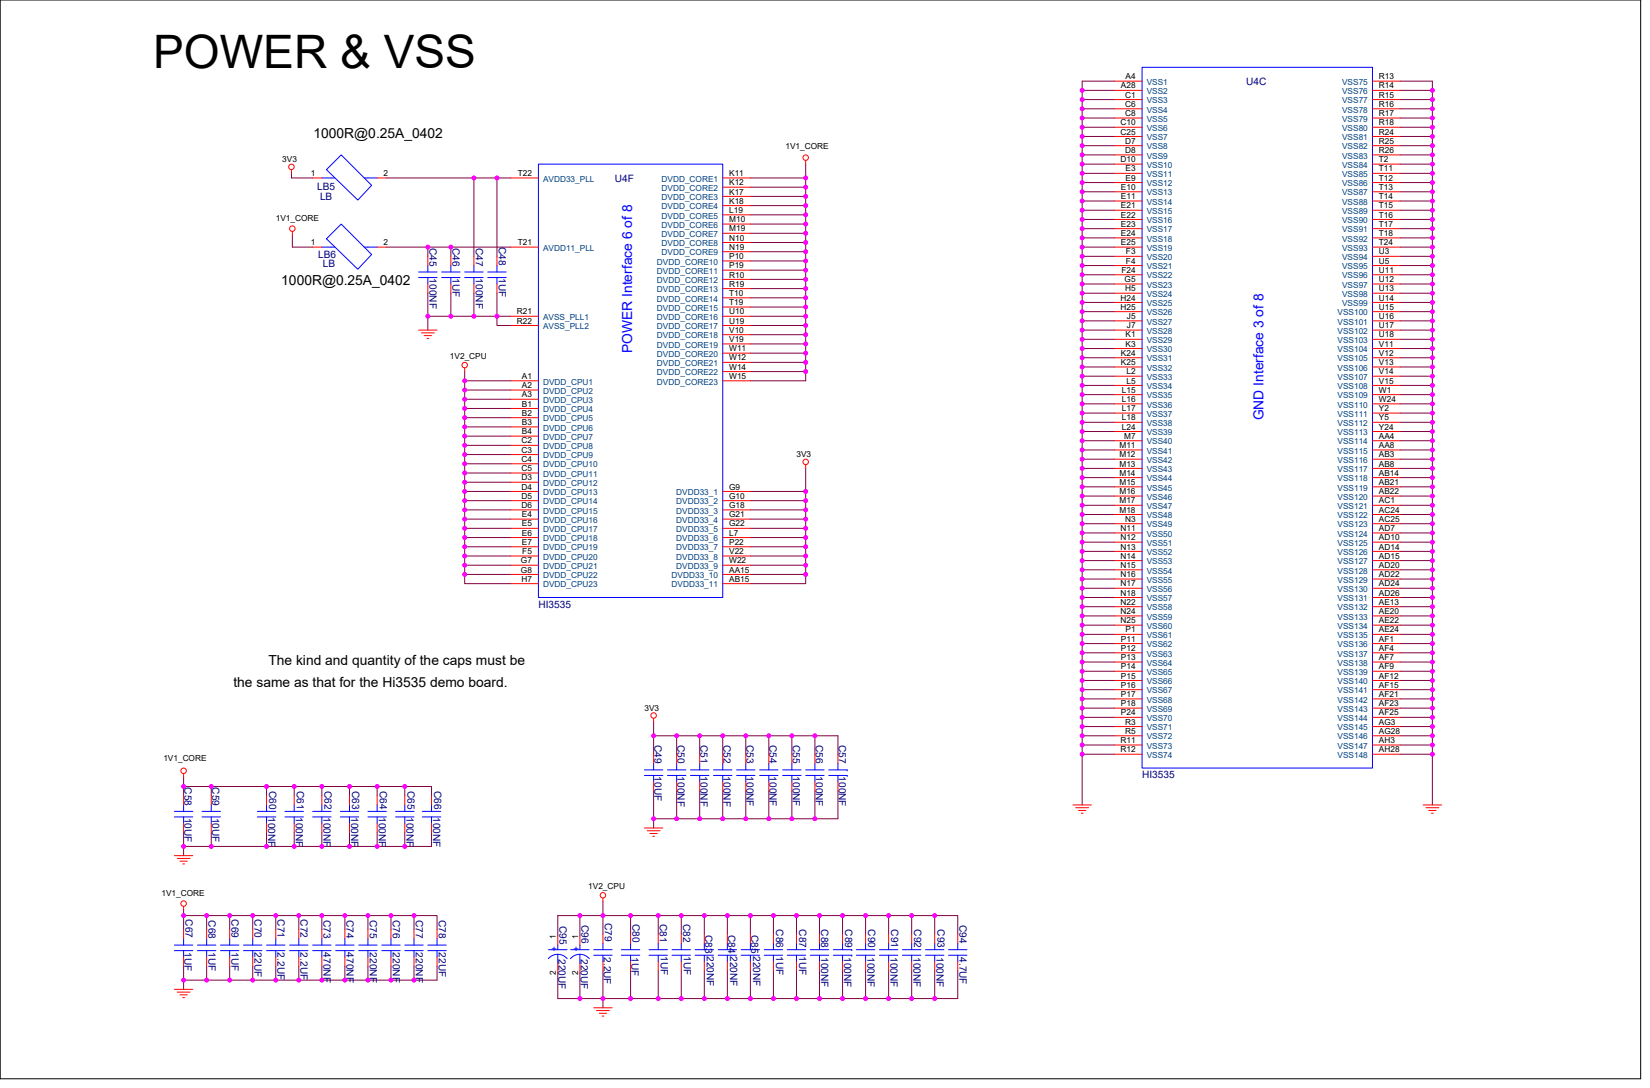
[picture p49: page 12]

The kind and quantity of the caps must be
the same as that for the Hi3535 demo board.

# BLOCK DIAGRAM

# USB3.0

# USB2.0 USB2.0

# DDR

# DDR

SATA3.0 | SATA3.0 | SATA3.0
| SPI
HDMI | VGA

# Connector

# Connector HI3535 Sys crystal RTC crystal

# Nandflash

# 2013.07.10 Ver.A schematic

# CHANGE LIST

# 2013.09.27 Change C144 C145 form 10nF to 100nF

# 16.Connector

15.VO

# 14.HDMI

# 13.DISPLAY

# 12.USB & SATA

# 11.INTERFACE

# 10.POWER ON SETTING PINS

# 09.SYSTEM & FLASH

# 08.DDR3_B

# 07.DDR3_A

# 06.Hi3535 DDR3

# 05.POWER & VSS

# 04.POWER TREE

# 03.BLOCK DIAGRAM

# 02.CHANGE LIST

# 01.Hi3535DMEB VER.A

# Hi3535DMEB VER.A

# ETH0

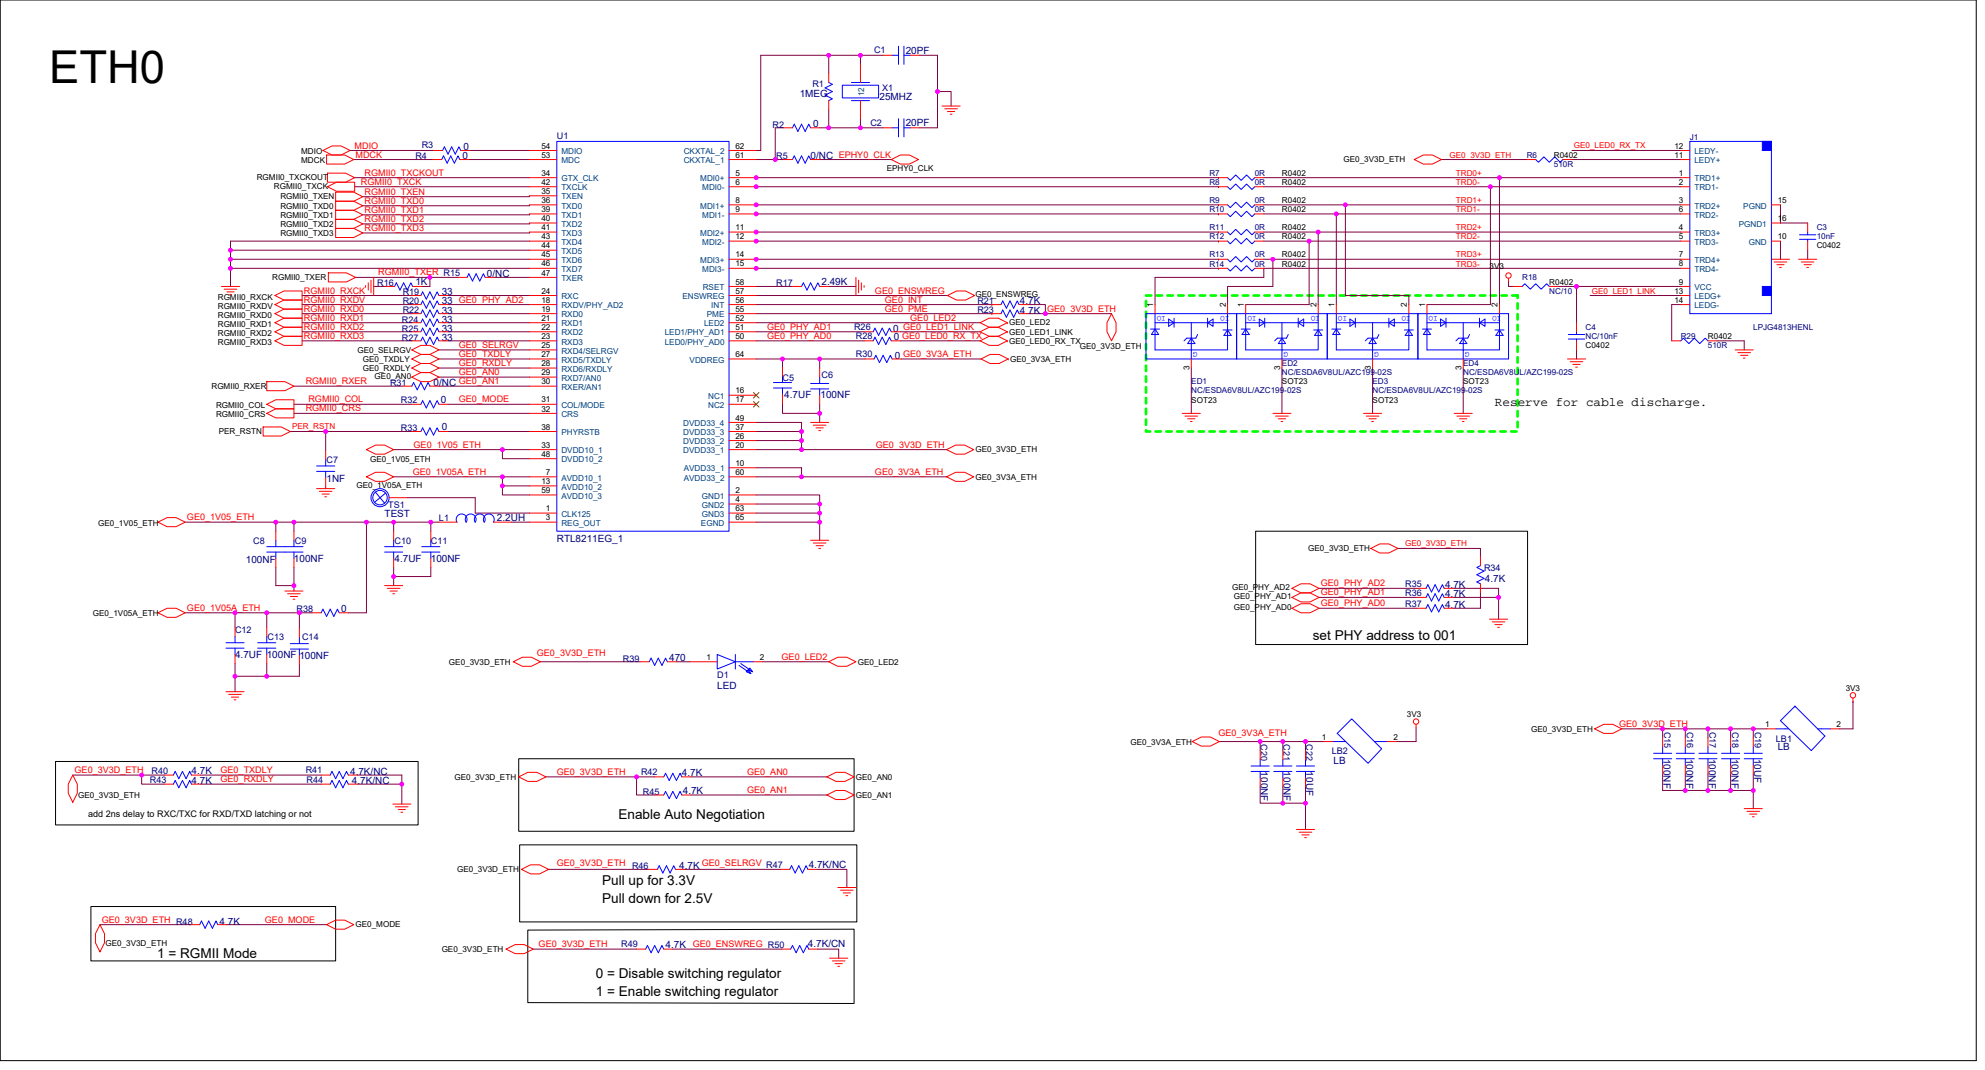
[picture p50: page 16]

# ETH1

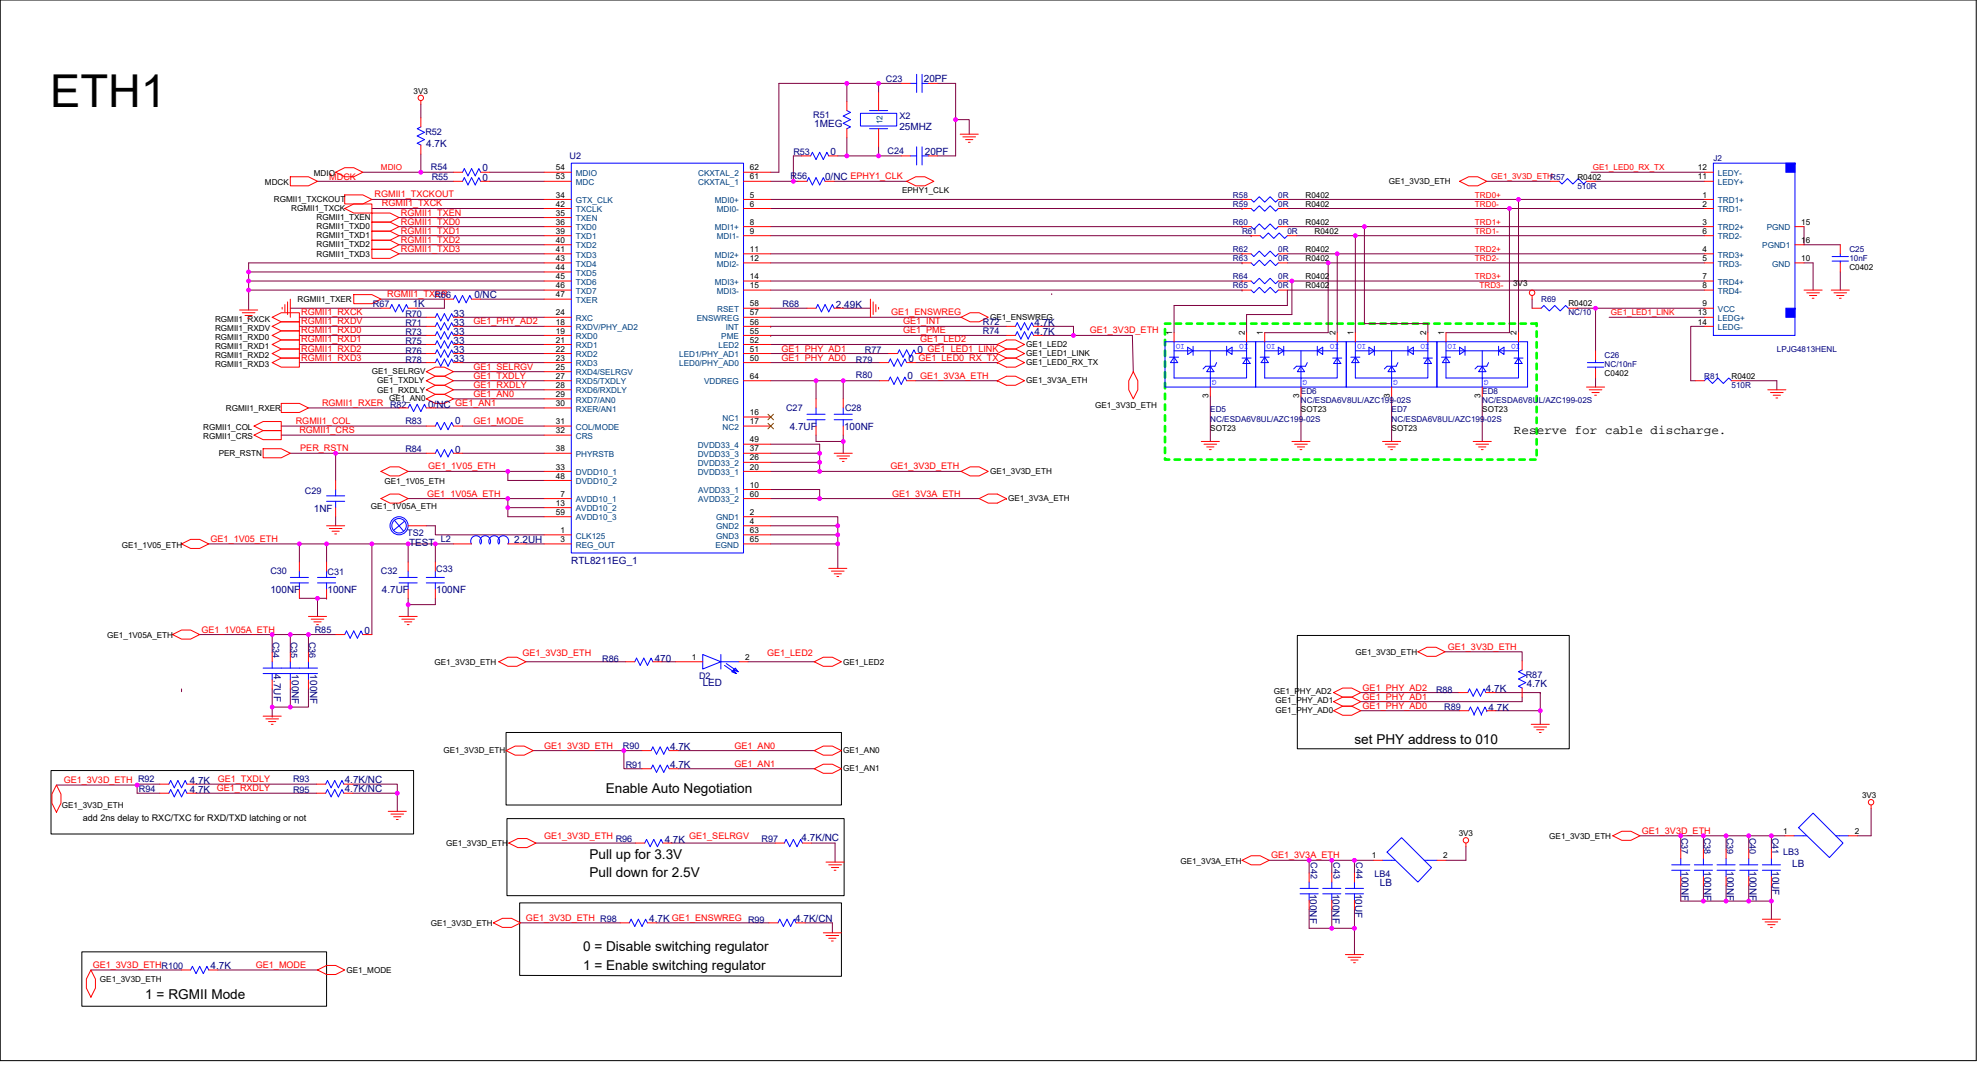
[picture p51: page 17]

TXD4 43 | TRD2-
TXD5 44 | TRD3+

set PHY address to 010

GE1_3V3D_ETH
add 2ns delay to RXC/TXC for RXD/TXD latching or not

# DC/DC 12V->DVDD_CORE 3Amax

60@4A_1206

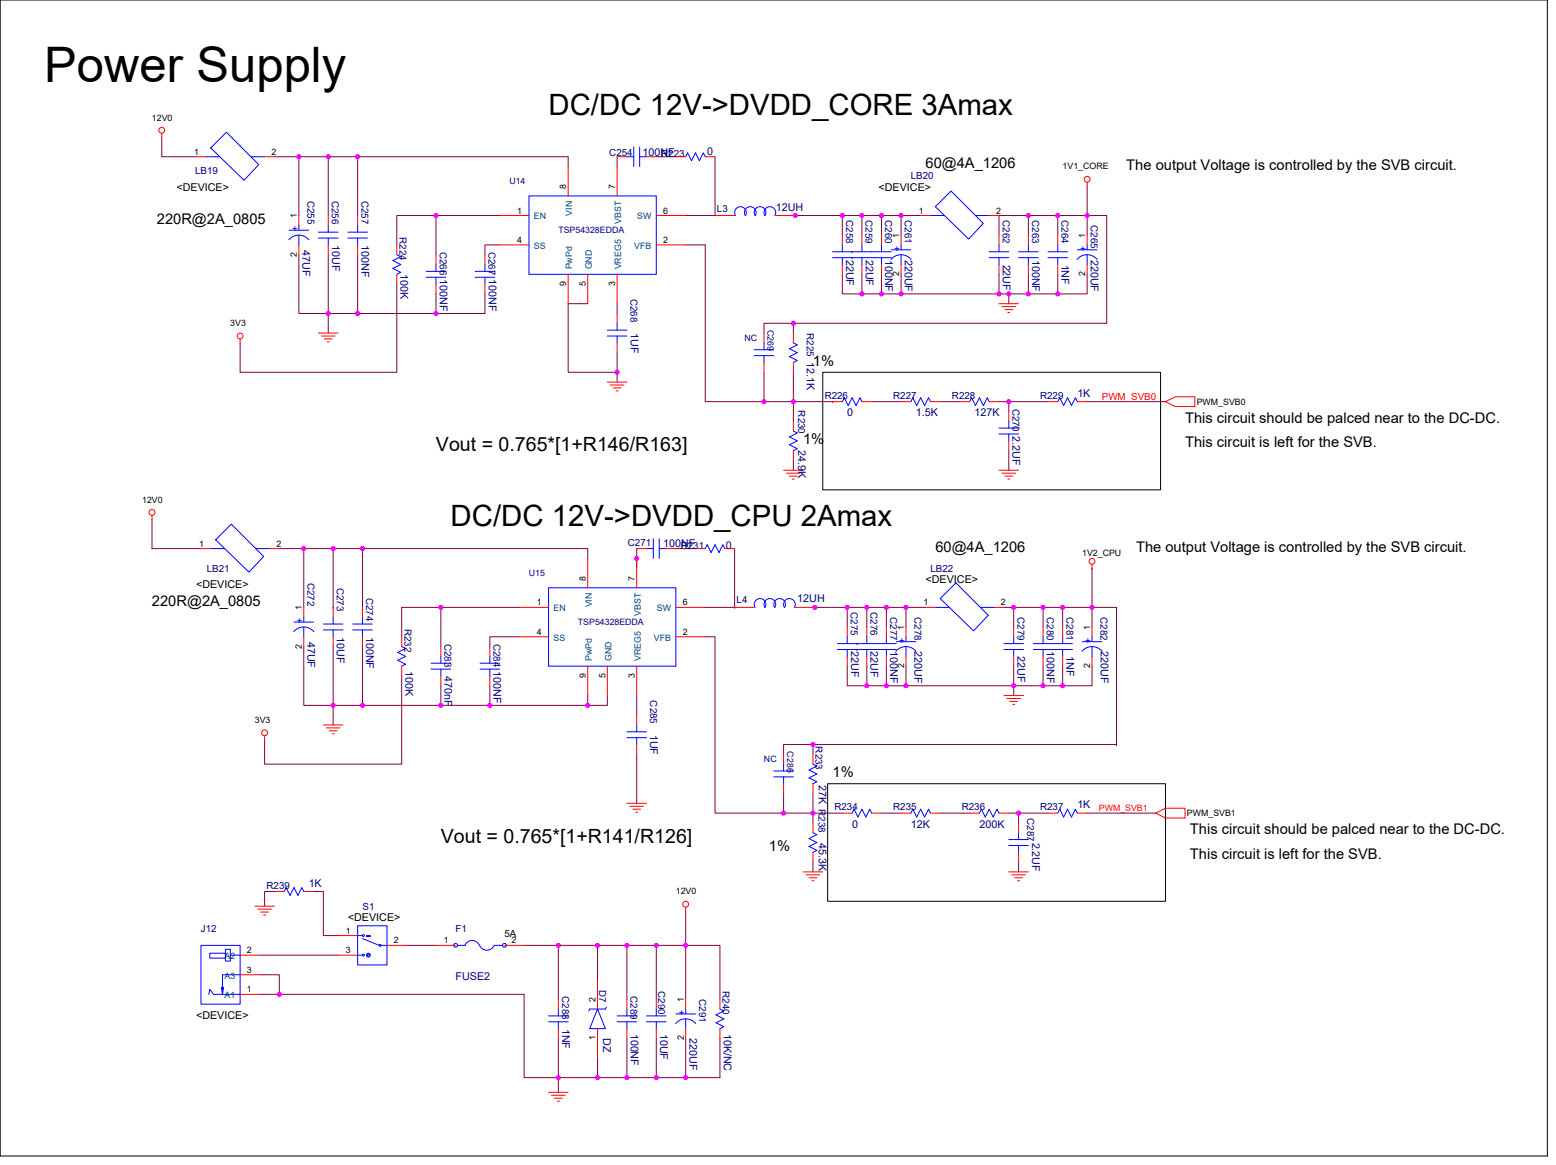
[picture p52: page 18]

The output Voltage is controlled by the SVB circuit.

PWM_SVB0
This circuit should be palced near to the DC-DC.
This circuit is left for the SVB.

PWM_SVB1

# DC/DC 12V->1V5 800Amax

# Power Supply

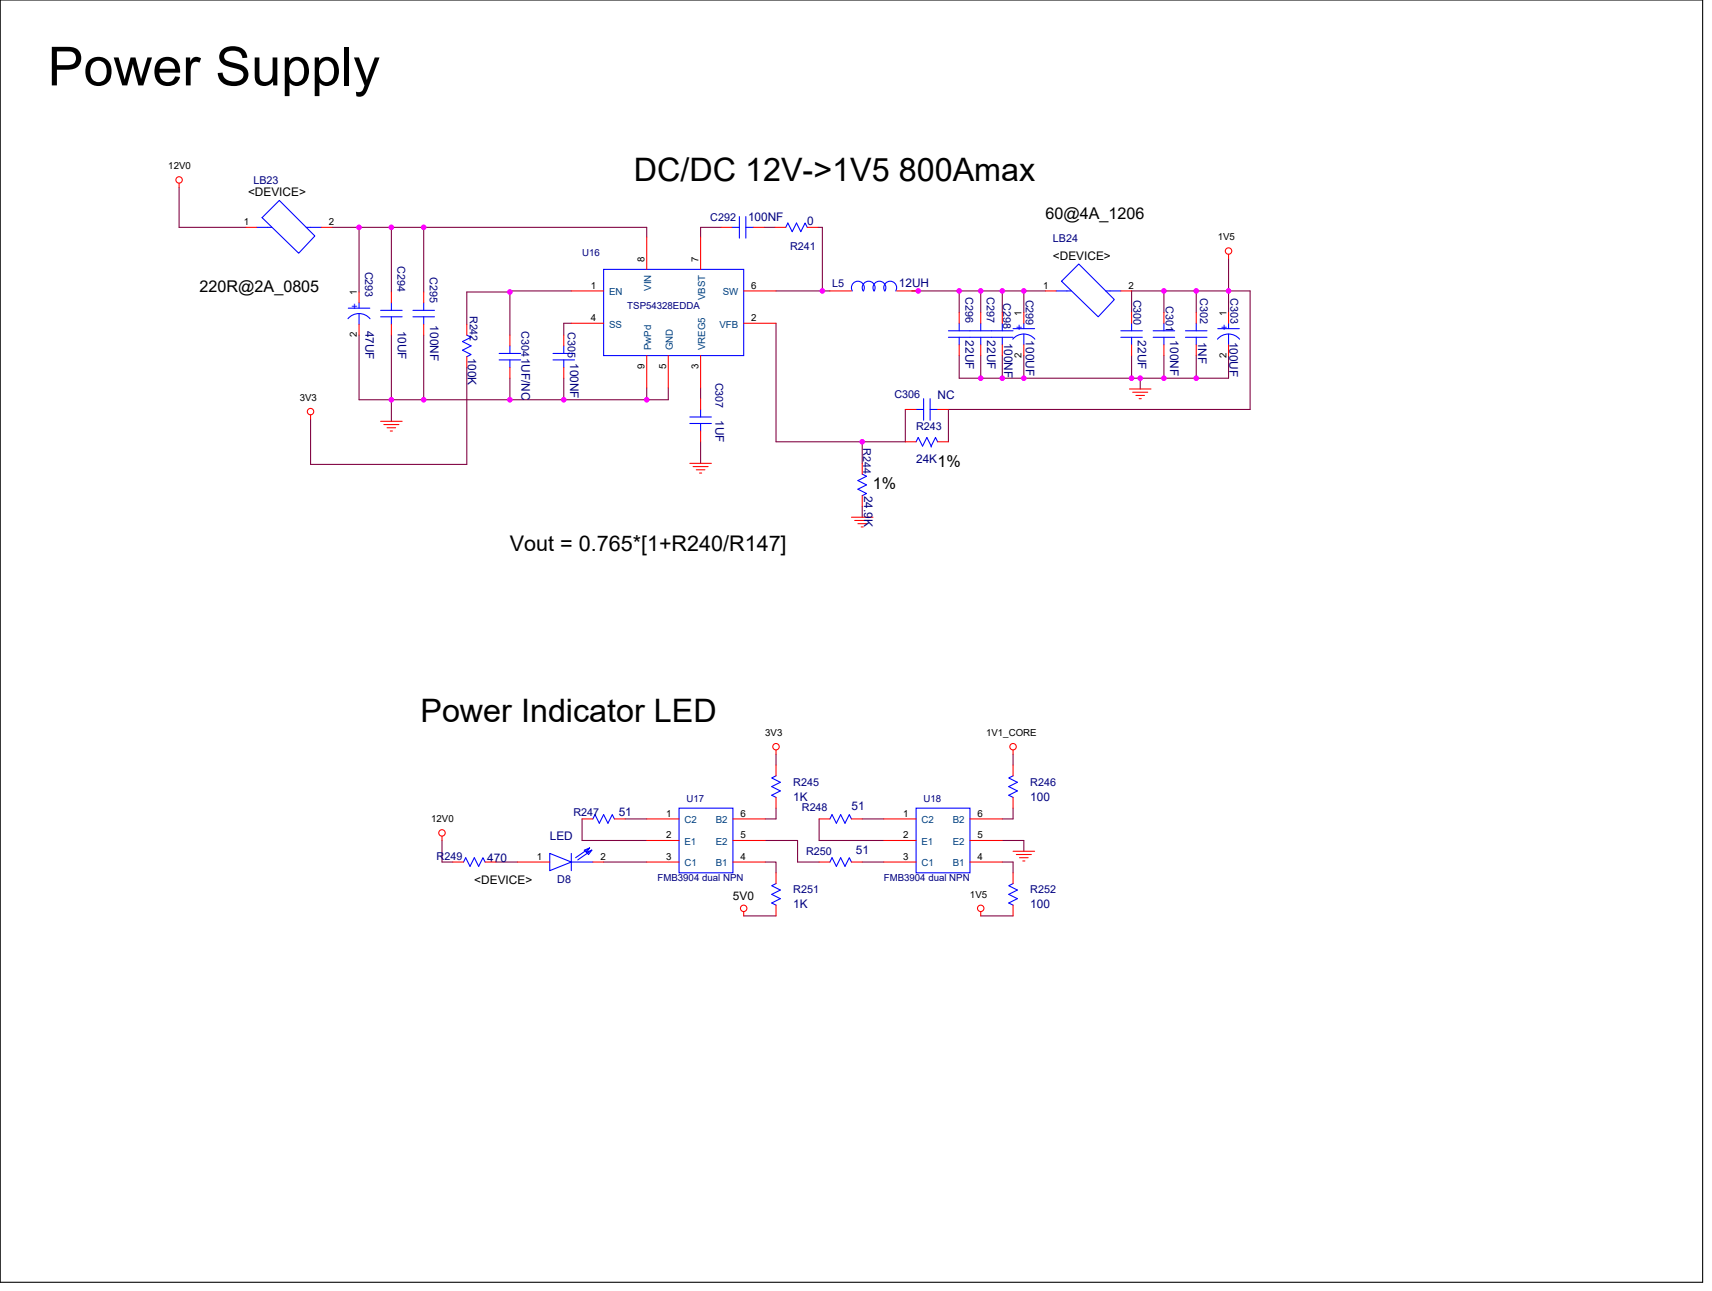
[picture p53: page 19]

# Power Supply

# 12V -> 5V - 2A and 3.3V - 2A

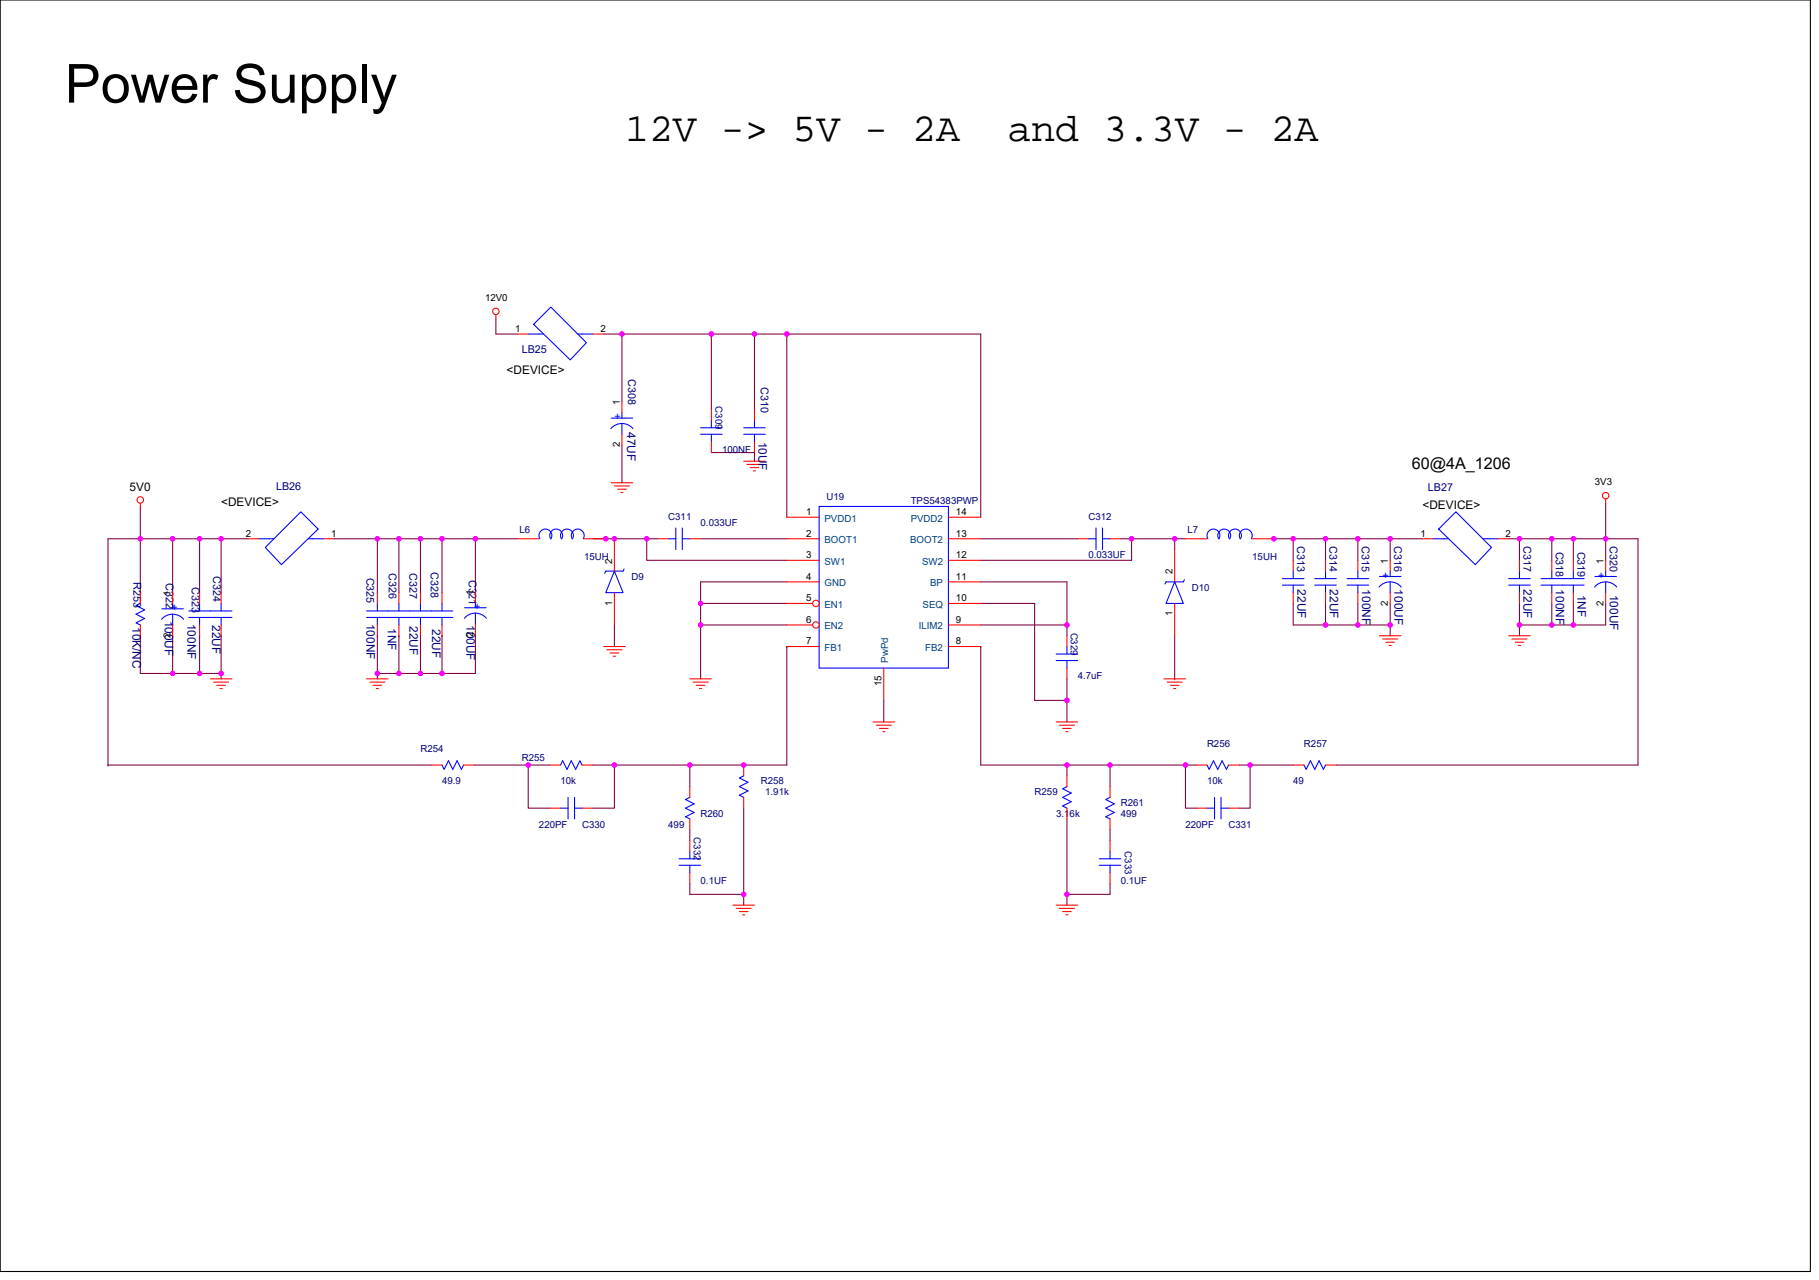
[picture p54: page 20]

# POWER TREE

# 1V1_CORE

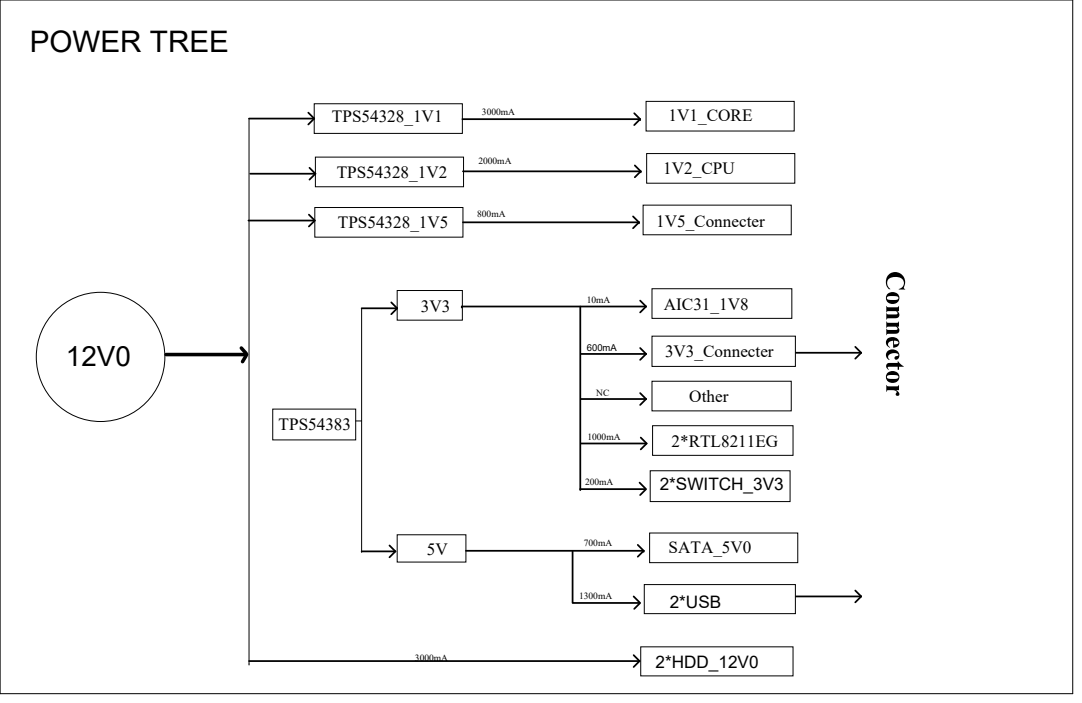
[picture p55: page 21]
1V2_CPU; 1V5_Connecter; AIC31_1V8; 3V3_Connecter; 2*RTL8211EG; SATA_5V0; Other; TPS54328_1V2; TPS54328_1V5; 2*SWITCH_3V3; 2*USB; 2*HDD_12V0 ³⁰⁰⁰mA; TPS54328_1V1; TPS54383

# UART2_TXD UART0_TXD

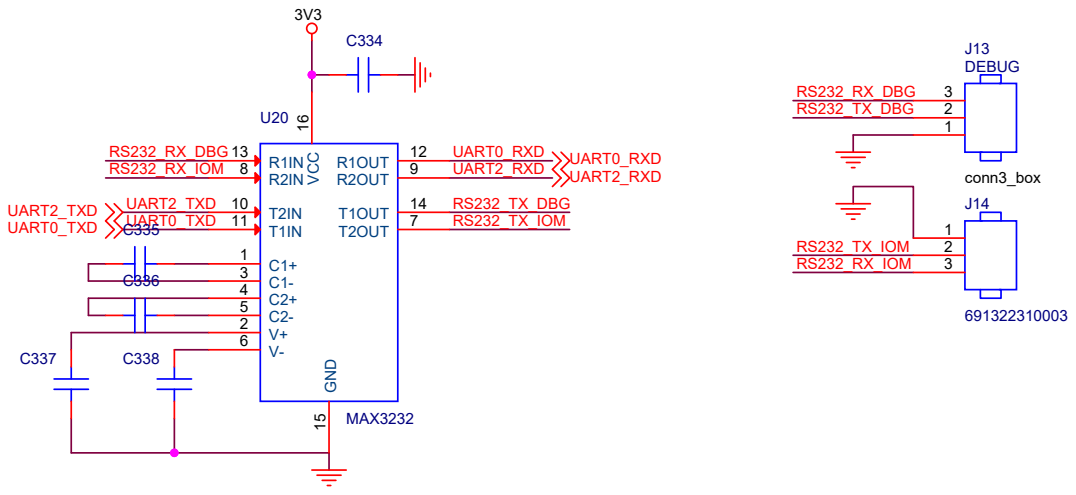
[picture p56: page 22]

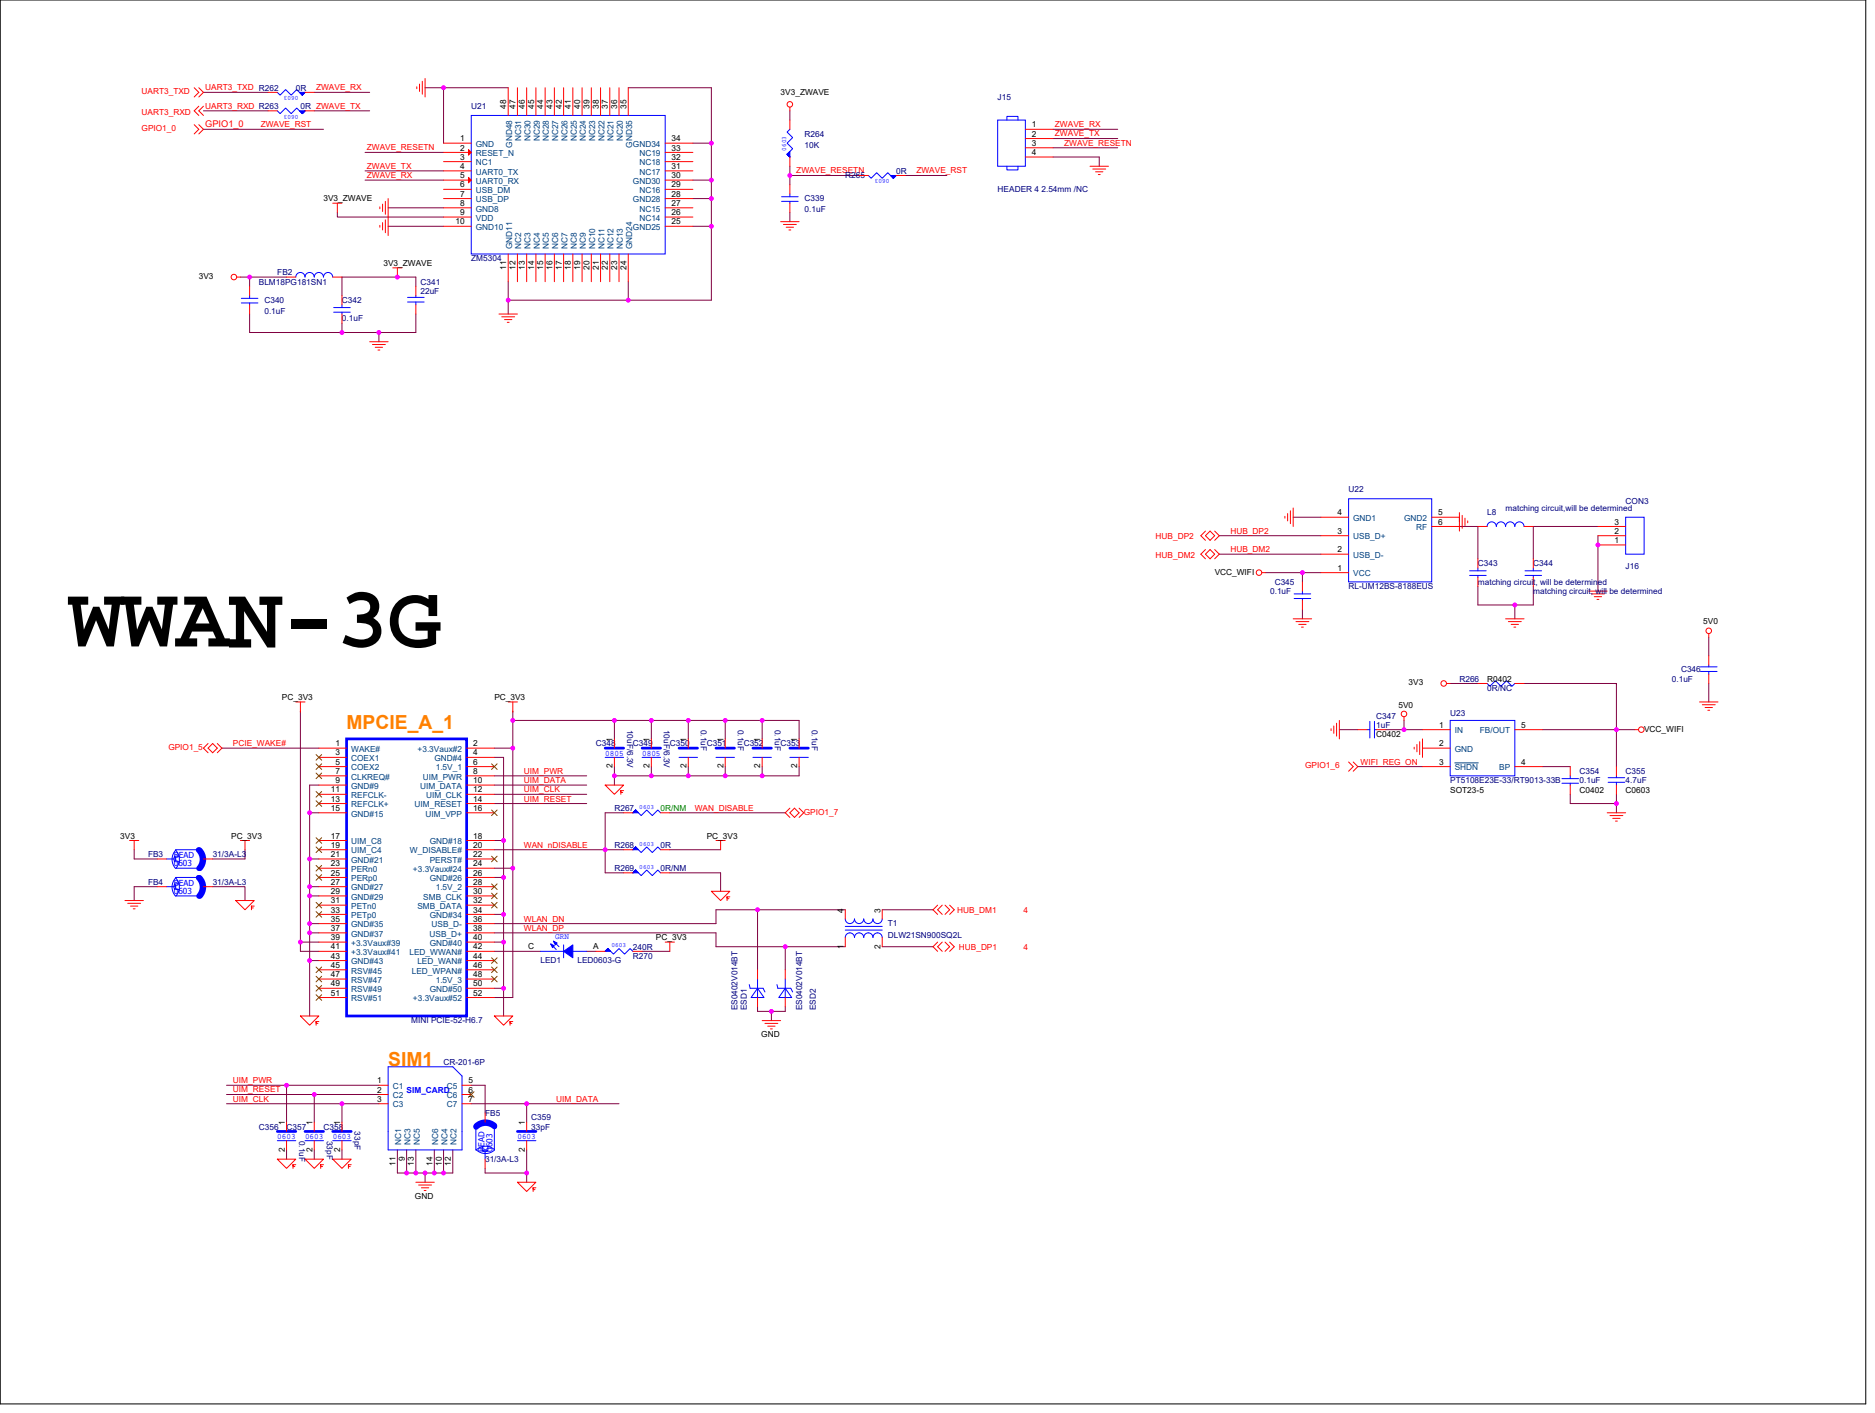
[picture p57: page 23]

L8 matching circuit,will be determined

matching circuit, will be determined
