m-soori/hi3535_nvr/(list of files, drawings)

Other design files:
1. Schematic/Hi3535DMEB_VER_A_SCH.DSN
1. Schematic/hi3535dmeb_ver_a_sch.opj
1. Schematic/NVR-Ver1-1.opj
